silly82/Herz_Schwarm_CCC_V/README.md

# ❤️ CCC Heart Swarm Badge (Herz-Schwarm)

Synchronized ESP-NOW Heart Badges for the CCC Camp & Congress.
*Synchronisierte ESP-NOW Herz-Badges für das CCC Camp & den Congress.*

---

## Deutsch

### Was ist das?
Ein Schwarm von 8x8 LED Herz-Badges auf Basis der **Waveshare ESP32-S3-Matrix**. Die Badges kommunizieren über **ESP-NOW**, synchronisieren ihren Takt, reagieren auf die Nähe anderer Geräte (RSSI) und enthalten interaktive Easter Eggs.

### Funktionen
- **Herzschlag-Sync:** Alle Badges schlagen im exakt gleichen Rhythmus.
- **Näherungseffekt:** Je näher dir ein anderes Badge kommt, desto heller leuchtet dein Herz. Ab Badge-FW 1.6.0 zählt dafür das **nächste** Badge (stärkstes Signal), nicht mehr der Durchschnitt über alle; das Tempo hängt nicht mehr an der Nähe, damit alle im gleichen Takt bleiben. Ferngesteuerte Effekte leuchten auf allen Badges gleich hell (feste Helligkeit, `FX_BRIGHT`).
- **Primzahlen-Osterei:** Wenn die **Gesamtzahl im Schwarm** eine Primzahl ist — also **sichtbare andere Badges plus dein eigenes** (z. B. du + 12 andere = 13; nur unter 17, ab dort greift die Singularität) — pulsiert das Herz stärker und es gibt weisse Glitzer-Pixel.
- **Die Singularität (≥17 Geräte):** Sobald **mindestens 17 Geräte insgesamt** da sind (du + 16 sichtbare Peers), schaltet die Animation auf den **Regenbogen-Modus** um (nicht nur bei exakt 17).
- **Der Morse-Virus:** Morsese ein **«C»** (`- . - .`) über die BOOT-Taste, um einen weissen Blitz-Virus durch den gesamten Schwarm zu jagen. Ab Badge-FW 1.6.0 endet der Morse-Virus auf jedem Badge nach **3 s** von selbst (am Badge gibt es keine Stopp-Geste); nur der von Basisstation/App gestartete Virus läuft endlos bis zum Stopp.
- **Die Welle (Basisstation):** Eine Welle breitet sich von der Basisstation aus: Badges in der Nähe leuchten zuerst, weiter entfernte später. Ein Durchlauf dauert ~4 s und wiederholt sich ab Badge-FW 1.4.1 **endlos** (Zyklus alle 4000 ms) — beendet wird die Welle erst per **manuellem Stopp** (Modus `10`, oder `12` für alle Effekte): Toggle im Web-UI, MQTT-Payload `10` oder Nerves-Dashboard; Badges leiten den Stopp begrenzt weiter, so erreicht er auch Geräte außerhalb der Basis-Reichweite. Ältere Badges verstehen den Stopp nicht und laufen wie bisher nach ~4 s aus. Ab Badge-FW 1.4.0: Wer die Basis direkt hört, zündet nach deren Signal (−45 dBm → sofort, −95 dBm → 2 s); alle anderen nach dem Badge, von dem sie die Welle haben, plus 150–750 ms je nach Signal zu ihm. Jedes Badge rechnet dabei auf den gemeinsamen Wellenstart zurück und übernimmt den kürzesten bekannten Weg — die Welle läuft so auch zu Badges, die die Basis gar nicht hören.
- **Fernauslösung (Basisstation):** Kompatibles `SyncPacket` mit `mode` **1** (Virus), **2** (Regenbogen / Singularity-Optik), **3** (Primzahl-Party), **4** (Welle / RSSI-Ripple, 4-s-Zyklus), **5** (Beat-Puls ~150 ms), **6** (RSSI-Zonen-Farben), **7** (Ambient-Farbe), **8** (Strobe), **9** (Badge finden — nur das Badge mit der Ziel-MAC blinkt grün), **10** (Welle stoppen — beendet die laufende Welle, ab Badge-FW 1.4.1), **11** (Tap-Meldung — `virusID` = Tap-Zählerstand), **12** (Alle stoppen — global, `virusID` = Kennung des Stopps), **13** (Funk-Update auslösen — nur App + Bridge, ab Badge-FW 1.7.0). Ab Badge-FW **1.5.0** laufen alle visuellen Effekte **endlos**, bis man sie stoppt oder ein neu gestarteter visueller Effekt sie ersetzt („letzter Effekt gewinnt" — Beat und Identify bleiben dabei erhalten). Die früheren festen Fenster (Virus 3 s, Regenbogen 15 s, Primzahl 12 s, Zonen 5 s, Ambient 30 s, Strobe 2 s) sind nur noch **nominale Zykluslängen**, nach denen der Effekt sich wiederholt. Ausnahmen: **Beat** bleibt ein 150-ms-Puls pro Paket, **Identify** (Modus 9) bleibt 10 s. Neue `virusID` pro Effekt verhindert Doppel-Trigger; während eines Effekts wird der passende `mode` weitergesendet (Kettenreaktion im Schwarm).
- **Tap-Counter (BOOT-Taste, ab Badge-FW 1.5.0):** Kurze Drücke auf die BOOT-Taste (**≤ 250 ms** — dieselben Ereignisse, die in der Morse-Eingabe ein Punkt sind; Morse unverändert) werden gezählt und als Modus `11` gemeldet (`virusID` = Zählerstand, monoton; 3× im 60-ms-Abstand plus Nachsendung nach 1,2 s, einmal beim Start). Andere Badges leiten fremde Tap-Pakete begrenzt weiter (**23 Byte** mit angehängter Ursprungs-MAC) und merken sich je MAC den höchsten Stand (Dedup). Der Zählerstand wird gedrosselt in NVS gespeichert (Namespace `hstap`, max. 1 Schreibvorgang/30 s). In der Nerves-App endet die Kette als **Tap-Counter-Karte** (Gesamtsumme und je Badge, Reset mit Rückfrage — Reset setzt nur die Anzeige auf 0, die Badge-Zähler laufen weiter).
- **Alle stoppen (Modus `12`, ab Badge-FW 1.5.0):** Globaler Stopp. Ab Badge-FW 1.6.0 / Basisstation 0.4.2 / Bridge 0.4.2 / App 0.2.2 trägt jeder Stopp eine eigene Kennung im `virusID`-Feld und wirkt je Badge genau einmal — ein verspätetes Echo schaltet so keinen Effekt mehr ab, der nach dem Stopp gestartet wurde (`virusID = 0` von älteren Sendern wird weiter verstanden, dann ohne diesen Schutz). Badges deaktivieren alle Effekt-Slots außer Identify und leiten den Stopp begrenzt weiter (max. 3 Sendungen, ~60 ms Abstand, dann 1000 ms Sperre — gleiches Muster wie der Wellen-Stopp). Erreichbar über Dashboard-Knopf „Alle Effekte auf den Badges stoppen", Basisstation-Knopf „⏹ Alle stoppen", `POST /api/effect?m=12` oder MQTT-Payload `12`.
- **Bewegungssensor (ab Badge-FW 1.8.0):** Schütteln lässt das Herz 1,5 s mit weißen Funken flattern. Optional: „Herz immer aufrecht" und Abdunkeln in Ruhe (beides standardmäßig aus). Am Gerät noch nicht getestet — siehe *Bewegungssensor*.
- **Funk-Update (ab Badge-FW 1.7.0):** Badges laden eine neue Firmware selbst per WLAN, ausgelöst über den Schwarm-Funk von der App-Seite `/badge-update` (Modus `13`, mit Schlüssel abgesichert). Nur in Builds mit `ota_secret.h`; am Gerät noch nicht getestet — siehe *Funk-Update der Badges*.
- **Nerves-Controller (Raspberry Pi):** Optionale Elixir/Nerves-App (`herz_schwarm_nerves/`) steuert den Schwarm über einen USB-ESP32-Bridge (ESP-NOW). LiveView Web-UI für Effekt-Steuerung, Beat-Tap-Tempo, Ambient-Farbwahl. Koexistiert mit der Basisstation auf Kanal 13. **Dev-Start auf Mac** (ohne Nerves-Build): siehe `herz_schwarm_nerves/MAC_SETUP.md`. Ab App 0.2.0 / Bridge 0.3.0 steuert die Seite **`/bridge-update`** die Bridge-Firmware per **UART-OTA** über das bestehende USB-Kabel (kein WLAN, kein `esptool`) — die Bridge braucht dafür einmalig einen USB-Flash mit dem neuen Partition-Schema `min_spiffs`; Details in Punkt 12 der nummerierten Doku. Ab App 0.2.0 / Bridge 0.4.0 zusätzlich im Dashboard: **Tap-Counter-Karte** (Modus `11`) und Knopf „Alle Effekte auf den Badges stoppen" (Modus `12`); BPM-Slider und Farbwähler wurden in Formulare gesetzt (vorher kamen Tempo- und Farbänderungen nie an) und das Verschieben des Tempo-Sliders startet den Beat nicht mehr. Ab App 0.3.0 / Bridge 0.5.0 löst die Seite **`/badge-update`** das Funk-Update der Badges aus. Betrieb auch direkt auf **Raspberry Pi OS** (systemd-Dienst, ohne Nerves-Firmware) — siehe *Betrieb auf dem Raspberry Pi*.

### Spezifische Hardware-Hinweise (Waveshare ESP32-S3-Matrix)
- **Pinout:** Die interne Matrix ist fest an **GPIO 14** verdrahtet. Die BOOT-Taste liegt auf **GPIO 0**.
- **Farben:** Die Matrix der Waveshare-Boards ist **RGB** verdrahtet (am Gerät verifiziert — mit `BGR` waren Rot und Blau vertauscht). Die Firmware initialisiert entsprechend `FastLED.addLeds<WS2812B, LED_PIN, RGB>`.
- **Sicherheit:** Da die Rückseite des Boards offene Kontakte hat, wird dringend empfohlen, diese mit Klebeband (Kapton) zu isolieren oder ein Gehäuse zu verwenden.
- **Eigene Hardware:** `herz_badge/` enthält das KiCad-Projekt für ein akkubetriebenes Badge (Waveshare-Schaltplan nachgezeichnet, Akku-Version platziert, noch nicht geroutet). Siehe `herz_badge/README.md`.

---

## 🇬🇧 English

### What is this?
A swarm of 8x8 LED heart badges based on the **Waveshare ESP32-S3-Matrix**. They communicate via **ESP-NOW**, sync their pulse, react to proximity (RSSI), and feature interactive Easter Eggs.

### Features
- **Heartbeat Sync:** All badges beat at the exact same rhythm.
- **Proximity Awareness:** The closer another badge gets, the brighter your heart glows. From badge FW 1.6.0 this follows the **nearest** badge (strongest signal) instead of the average over all peers; tempo no longer depends on proximity, so everyone stays on the same beat. Remote-triggered effects use a fixed brightness (`FX_BRIGHT`) and look the same on every badge.
- **Prime Number Easter Egg:** When the **total swarm size** is prime — **other visible badges plus your own** (e.g. you + 12 others = 13; only below 17, where the singularity takes over) — the heart pulses more strongly with occasional white sparkles.
- **The Singularity (≥17 devices):** When **at least 17 devices** are present in total (you + 16 visible peers), the animation switches to **rainbow mode** (not only at exactly 17).
- **The Morse Virus:** Morse a **"C"** (`- . - .`) using the BOOT button to trigger a white flash "virus" across the entire swarm. From badge FW 1.6.0 the Morse virus ends after **3 s** on every badge (there is no stop gesture on the badge); only a virus started from the base station or the app runs until stopped.
- **The Wave (base station):** A wave ripples outward from the base station: nearby badges light up first, distant ones later. One pass takes ~4 s; from badge FW 1.4.1 the wave **repeats endlessly** (4000 ms cycle) and only ends on a **manual stop** (mode `10`, or `12` to stop all effects): toggle in the web-UI, MQTT payload `10`, or Nerves dashboard — badges relay the stop with limited rebroadcasts, so it also reaches devices outside the base's range. Older badges don't understand the stop and finish after ~4 s as before. From badge FW 1.4.0, badges that hear the base fire by its signal strength (−45 dBm → immediately, −95 dBm → 2 s); others fire after the badge they got the wave from, plus 150–750 ms by signal to it. Every badge aligns to the shared wave start and keeps the shortest known path, so the wave also reaches badges out of the base's range.
- **Remote trigger (base station):** Compatible `SyncPacket` with `mode` **1** (virus), **2** (rainbow / singularity look), **3** (prime-party look), **4** (wave / RSSI ripple, 4 s cycle), **5** (beat pulse ~150 ms), **6** (RSSI zone colors), **7** (ambient color), **8** (strobe), **9** (find badge — only the badge with the target MAC blinks green), **10** (stop the wave — ends the running wave, badge FW 1.4.1+), **11** (tap report — `virusID` = tap counter), **12** (stop all — global, `virusID` = id of this stop), **13** (trigger over-the-air update — app + bridge only, badge FW 1.7.0+). From badge FW **1.5.0** all visual effects run **endlessly** until stopped or until a newly started visual effect replaces them ("last effect wins" — beat and identify are kept). The previous fixed windows (virus 3 s, rainbow 15 s, prime 12 s, zones 5 s, ambient 30 s, strobe 2 s) are now only **nominal cycle lengths** after which the effect repeats. Exceptions: **beat** remains a 150 ms pulse per packet, **identify** (mode 9) stays at 10 s. A fresh `virusID` per effect avoids re-triggering; while active, badges forward the same `mode` for swarm propagation.
- **Tap counter (BOOT button, badge FW 1.5.0+):** Short BOOT presses (**≤ 250 ms** — the same events that count as a dot in morse input; morse itself is unchanged) are counted and reported as mode `11` (`virusID` = counter, monotonic; sent 3× at 60 ms spacing plus a re-send after 1.2 s, and once at boot). Other badges relay foreign tap packets with limited rebroadcast (**23 bytes** with the origin MAC appended) and keep the highest value per MAC (dedup). The counter is persisted to NVS with throttling (namespace `hstap`, max. 1 write/30 s). In the Nerves app the chain ends on a **Tap-Counter card** (total and per badge, reset with confirmation — reset only zeroes the display, badge counters keep running).
- **Stop all (mode `12`, badge FW 1.5.0+):** Global stop. From badge FW 1.6.0 / base station 0.4.2 / bridge 0.4.2 / app 0.2.2 every stop carries its own id in `virusID` and takes effect exactly once per badge, so a late echo can no longer switch off an effect started after the stop (`virusID = 0` from older senders is still understood, without that protection). Badges deactivate all effect slots except identify and relay the stop with limited rebroadcast (max. 3 sends, ~60 ms apart, then a 1000 ms lock — same pattern as the wave stop). Reachable via the dashboard button "Alle Effekte auf den Badges stoppen", the base station button "⏹ Alle stoppen", `POST /api/effect?m=12`, or MQTT payload `12`.
- **Motion sensor (badge FW 1.8.0+):** Shaking the badge makes the heart flutter with white sparks for 1.5 s. Optional: "heart always upright" and dimming at rest (both off by default). Not yet tested on hardware — see *Bewegungssensor* (German).
- **Over-the-air update (badge FW 1.7.0+):** Badges download new firmware over Wi-Fi themselves, triggered through the swarm radio from the app page `/badge-update` (mode `13`, protected by a shared key). Only in builds with `ota_secret.h`; not yet tested on hardware — see *Funk-Update der Badges* (German).
- **Nerves Controller (Raspberry Pi):** Optional Elixir/Nerves app (`herz_schwarm_nerves/`) controls the swarm via a USB ESP32 bridge (ESP-NOW). LiveView web-UI for effect control, beat tap-tempo, ambient color picker. Coexists with the base station on channel 13. From app 0.2.0 / bridge 0.3.0 the **`/bridge-update`** page pushes new bridge firmware via **UART-OTA** over the existing USB cable (no Wi-Fi, no `esptool`) — existing bridge devices first need one USB flash with the new `min_spiffs` partition scheme. **Security note:** the `/bridge-update` page has **no login** — anyone who can reach the app on the network can upload and flash bridge firmware. Run the app only in a trusted network or restrict access at the network level (firewall/VPN/LAN segment); there is deliberately no login yet, unlike the base station's OTA, which uses HTTP Basic Auth. From app 0.2.0 / bridge 0.4.0 the dashboard also shows a **Tap-Counter card** (mode `11`) and an "Alle Effekte auf den Badges stoppen" button (mode `12`); the BPM slider and color picker now sit inside forms (`phx-change` does not fire on standalone inputs outside a form, so tempo and color changes never arrived), and moving the tempo slider no longer starts the beat (start only via "Start"). From app 0.3.0 / bridge 0.5.0 the **`/badge-update`** page triggers the over-the-air update of the badges (also without login; a trigger additionally needs the shared key `BADGE_OTA_KEY` on the server). The app also serves the diagnosis page **`/diagnose`** (monitoring: counters, bridge state, log panel, badge metrics). The app currently runs on plain **Raspberry Pi OS (Debian 13, aarch64)** as systemd service `herz-schwarm` on port 4000 — no Nerves firmware; see `herz_schwarm_nerves/MAC_SETUP.md`.

### Specific Hardware Notes (Waveshare ESP32-S3-Matrix)
- **Pinout:** Internal matrix is wired to **GPIO 14**. BOOT button is on **GPIO 0**.
- **Color Order:** The matrix is wired **RGB** (verified on device — with `BGR`, red and blue were swapped). The firmware initializes `FastLED.addLeds<WS2812B, LED_PIN, RGB>`.
- **Safety:** As the back of the board has exposed contacts, it is highly recommended to insulate it with tape (Kapton) or use a 3D-printed case.
- **Own hardware:** `herz_badge/` holds the KiCad project for a battery-powered badge (the Waveshare schematic redrawn, the battery version placed, not yet routed). See `herz_badge/README.md`.

### Build, flash & serial monitor (Arduino CLI)
- **FQBN:** `esp32:esp32:esp32s3` — sketch folder = repository root (`Herz_Schwarm_CCC_V.ino`). Port: `arduino-cli board list`.
- **Production build:** `compile` + `upload` without debug flags (smaller binary, no serial overhead in the loop).
- **Serial debug on USB (ESP32-S3):** enable **USB CDC On Boot** (`CDCOnBoot=cdc`) and `ENABLE_SERIAL_DEBUG=1`. Because `upload` has no `--build-property`, use `--build-path build_debug` on compile and `--input-dir build_debug` on upload — see the **Arduino CLI** subsection under *Setup & Configuration* for copy-paste commands.
- **Live log:** `arduino-cli monitor -p <port> -c baudrate=115200` in an **interactive** terminal; stop with `Ctrl+C` before flashing again.
- **Batch flash (several devices):** `scripts/batch_flash_herz_schwarm.sh` needs **esptool** on `PATH` in addition to arduino-cli. See *Batch-Update* under *Setup & Configuration* (German) for options and the log files `firmware_update_log.csv` / `firmware_update_log.md`.
- **Interactive TUI (currently v0.2.1):** running the same script in a terminal with `pyserial` installed auto-launches an ANSI menu (`scripts/flash_gui.py`) for port scanning, build mode (release/debug), compile, flash + MAC-read (parsed from upload output, no separate `esptool read_mac`), and log view. TUI covers **flash operations only** — effect control (modes 1–8, plus wave stop `10` and stop-all `12`) stays on the base station via Web-UI (port 80) or MQTT. macOS, Linux and (from v0.2.0) Windows; v0.2.0 also adds parallel flashing, retry of failed ports and automatic rebuild of a stale build.
- **Morse logging:** with debug on, each symbol prints as `[Morse]`; after 800 ms without a new symbol the word is evaluated (`-.-.` triggers the virus, otherwise `ignoriert`). With debug off, none of this is compiled into `loop()`.
- **Firmware version:** see *Firmware-Version* (German section under *Setup & Configuration*): `FW_*` in `Herz_Schwarm_CCC_V.ino`; release `MAJOR.MINOR.PATCH`, debug `MAJOR.MINOR.DD+debug` with `DD` 01–99.
- **ESP-NOW:** firmware version is sent in each sync packet (17-byte `SyncPacket`); legacy 13-byte peers still work — see *ESP-NOW Paket (Sync)* in the German section.
- **Windows:** building and uploading with Arduino CLI works the same (ports are `COMx`); the TUI (`python scripts\flash_gui.py`) supports Windows from v0.2.0, the Bash batch script is macOS/Linux only — see *Windows* below.
- **Checks:** there is no CI; compile the firmwares and run `pytest` / `mix test` locally before pushing — see *Prüfen vor dem Push* below.

---

## 🛠 Setup & Configuration
- **MCU:** Waveshare ESP32-S3-Matrix
- **Arduino IDE Board:** "ESP32S3 Dev Module"
- **USB Mode:** "Hardware CDC and JTAG"
- **USB CDC On Boot:** *Enabled* if you want `Serial` output on the USB cable while debugging (matches `CDCOnBoot=cdc` in CLI).
- **Library:** FastLED (v3.6+); WiFi, ESP-NOW, Wire, Update und HTTPClient kommen mit dem ESP32-Core. Basisstation zusätzlich PubSubClient, Bridge zusätzlich ArduinoJson 7.
- **Geprüfter Stand:** ESP32-Core 3.3.12, FastLED 3.10.9, PubSubClient 2.8.0, ArduinoJson 7.4.3.

### Arduino CLI
Build und Upload lassen sich mit der **Arduino CLI** erledigen. **FQBN:** `esp32:esp32:esp32s3`. **Sketch-Verzeichnis:** Wurzel dieses Repos (Datei `Herz_Schwarm_CCC_V.ino`). Im Ordner `.cursor/rules/` liegt eine **Cursor-Regel** (`arduino-cli.mdc`) mit typischen Befehlen.

**Port ermitteln:**

```bash
arduino-cli board list
```

**Standard-Build & Upload** (ohne Serial-Debug, weniger Flash/RAM):

```bash
arduino-cli compile --fqbn esp32:esp32:esp32s3 .
arduino-cli upload -p /dev/cu.usbmodemXXXX --fqbn esp32:esp32:esp32s3 .
```

(`usbmodemXXXX` durch den eigenen Eintrag aus `board list` ersetzen.)

**Serial-Debug & Live-Log am USB-Kabel (ESP32-S3):**  
Am Rechner erscheint `Serial` nur zuverlässig über USB, wenn **USB CDC On Boot** aktiv ist. Zusätzlich muss `ENABLE_SERIAL_DEBUG` an sein (siehe unten). `arduino-cli upload` unterstützt **kein** `--build-property`; deshalb zuerst in einen Build-Ordner kompilieren und mit `--input-dir` flashen:

```bash
arduino-cli compile --fqbn esp32:esp32:esp32s3 --board-options CDCOnBoot=cdc \
  --build-property "compiler.cpp.extra_flags=-DENABLE_SERIAL_DEBUG=1" \
  --build-path build_debug .
arduino-cli upload -p /dev/cu.usbmodemXXXX --fqbn esp32:esp32:esp32s3 \
  --board-options CDCOnBoot=cdc --input-dir build_debug .
```

Der Zwischenordner `build_debug/` steht in `.gitignore` und wird nicht ins Repo committet.

**Seriellen Monitor (live):** In einem **normalen Terminal** starten (Hintergrund/CI beendet den Monitor oft sofort). **Baudrate:** 115200.

```bash
arduino-cli monitor -p /dev/cu.usbmodemXXXX -c baudrate=115200
```

Beenden mit `Ctrl+C`. Vor einem erneuten Upload den Monitor beenden (Port freigeben).

### Windows

Kompilieren und Hochladen mit der Arduino CLI funktionieren unter Windows mit denselben Befehlen (kompiliert geprüft mit Arduino CLI 1.6.0; geflasht wurde von Windows aus bisher nicht). Unterschiede:

- Der Port heißt `COMx` statt `/dev/cu.…` (`arduino-cli board list`).
- In PowerShell mehrzeilige Befehle in eine Zeile schreiben oder mit dem Backtick statt `\` umbrechen.
- Die TUI läuft ab v0.2.0 auch unter Windows: `python scripts\flash_gui.py` (braucht `pip install pyserial`). `scripts/batch_flash_herz_schwarm.sh` und `scripts/version.sh` sind Bash-Skripte für macOS/Linux; in Git Bash laufen sie, die Port-Erkennung des Bash-Modus kennt `COMx` aber nicht.
- Die App (`herz_schwarm_nerves/`) braucht Elixir; ohne lokale Installation lassen sich ihre Tests nur auf dem Mac oder dem Pi ausführen.

### Prüfen vor dem Push

Das Projekt hat bewusst **keine CI**. Vor einem Push von Hand prüfen:

| Was | Befehl |
|-----|---|
| Firmware | Badge, Basisstation und Bridge mit `arduino-cli compile` bauen (Befehle oben) |
| Flash-Tooling | `python -m pytest scripts` (43 Tests) |
| App | `mix test` in `herz_schwarm_nerves/` (braucht Elixir) |

Funk- und LED-Verhalten bleiben ein Test am Gerät.

### Betrieb auf dem Raspberry Pi
Die Phoenix-App läuft aktuell **ohne Nerves-Firmware** direkt auf **Raspberry Pi OS (Debian 13, aarch64)** als systemd-Dienst `herz-schwarm` auf Port **4000** — kein Nerves-Build, kein `mix release`. Zusätzlich stellt die App die Diagnose-Seite **`/diagnose`** bereit (Monitoring: Zähler, Bridge-Zustand, Log-Panel, Badge-Metriken). Setup-Details (Autostart, Log, Updates) stehen in `herz_schwarm_nerves/MAC_SETUP.md`; hier bewusst nur der Verweis, keine doppelte Anleitung.

### Batch-Update (mehrere Badges nacheinander)

Für viele Waveshare-Matrix-Badges am USB (nacheinander flashen oder **mehrere USB-Ports gleichzeitig**): Skript `scripts/batch_flash_herz_schwarm.sh` im Repo. Es baut **einmal** in den lokalen Ordner `build_batch/` (in `.gitignore`, analog zu `build_debug/`) und führt pro erkanntem Port `arduino-cli upload` aus, danach **`esptool read_mac`**, und **hängt** einen Eintrag an die Protokolldateien in der **Repo-Wurzel** an:

- **`firmware_update_log.csv`** — Semikolon-getrennt: Zeitstempel, Firmware-String, Port, Ergebnis, MAC
- **`firmware_update_log.md`** — dieselben Daten als Markdown-Tabelle

**Voraussetzung:** [Arduino CLI](https://arduino.github.io/arduino-cli/) (wie oben) **und** [esptool](https://github.com/espressif/esptool) (`esptool.py` oder `esptool` im `PATH`, z. B. `brew install esptool`). Liest esptool den Chip nicht, **`ESPTOOL=/pfad/zu/esptool.py`** setzen.

**Port-Erkennung:** `arduino-cli board list --format json` — es werden Anschlüsse genutzt, deren **Board-Erkennung** `esp32:esp32:esp32s3` *oder* (häufig auf macOS) **`esp32:esp32:esp32_family`** liefert. Wenn kein passender Port erscheint, Ports manuell oder per USB-Heuristik:

```bash
chmod +x scripts/batch_flash_herz_schwarm.sh
./scripts/batch_flash_herz_schwarm.sh
./scripts/batch_flash_herz_schwarm.sh --ports /dev/cu.usbmodem101 /dev/cu.usbmodem102
./scripts/batch_flash_herz_schwarm.sh --all-usb
./scripts/batch_flash_herz_schwarm.sh --no-compile
./scripts/batch_flash_herz_schwarm.sh --debug
```

| Option / Ablauf | Bedeutung |
|---|---|
| (ohne Optionen) | Erkannte ESP32-Ports flashen, einmal kompilieren |
| `--ports …` | Nur diese Gerätepfade (z. B. aus `arduino-cli board list`) |
| `--all-usb` | Typische USB-Seriell-Pfade (`usbmodem*`, WCH, FTDI-ähnlich), wenn die CLI kein FQBN meldet |
| `--no-compile` | Nur `upload` aus bestehendem `build_batch/` (nach vorherigem Lauf) |
| `--debug` | Entspricht **Serial-Debug**-Build: `CDCOnBoot=cdc` und `-DENABLE_SERIAL_DEBUG=1` (siehe oben) |

Vor dem Lauf: **seriellen Monitor beenden** (`Ctrl+C`), sonst ist der Port belegt. Pro Gerät: zuerst Flash, danach MAC auslesen; Ergebnis `ok` / `upload_failed` / `ok_mac_unread` u. a. steht in der CSV/MD. Ausdrücklich mit **`bash ./scripts/...`** starten, falls die System-Shell zickt.

### CLI Pseudo-GUI (interaktiv, aktuell v0.2.1)

`scripts/batch_flash_herz_schwarm.sh` startet **automatisch** eine interaktive TUI, wenn ein TTY erkannt wird und `pyserial` installiert ist. Die TUI (`scripts/flash_gui.py`) ist ein dünner Wrapper um die gleiche Logik — nutzt aber ANSI-Boxen für Menü, Live-Output und Multi-Select.

**Voraussetzung** (einmalig):
```bash
pip3 install --user pyserial
```

**Start:**
```bash
./scripts/batch_flash_herz_schwarm.sh       # TUI automatisch
./scripts/batch_flash_herz_schwarm.sh --no-gui   # Bash-Modus erzwingen
./scripts/batch_flash_herz_schwarm.sh --gui      # TUI erzwingen (Fehler wenn nicht möglich)
python3 scripts/flash_gui.py               # TUI direkt starten
python3 scripts/flash_gui.py --debug       # gleich im Debug-Modus starten
python scripts\flash_gui.py                # Windows (PowerShell)
```

Über dem Menü steht eine Statuszeile: Firmware-Version, Build-Modus, ob der vorhandene Build noch zum Sketch passt, die ausgewählten Ports und zuletzt fehlgeschlagene Ports.

**Hauptmenü:**
| Taste | Funktion |
|---|---|
| `1` | ESP32-S3-Ports scannen und auswählen (Enter = alle, sonst `1,3` oder `2-4`) |
| `2` | Build-Modus: Release ↔ Debug umschalten |
| `3` | Firmware kompilieren (Live-Ausgabe von arduino-cli) |
| `4` | Flashen, MAC aus der Upload-Ausgabe; am Ende eine Ergebnisübersicht mit Dauer |
| `5` | Log anzeigen (letzte 20 Zeilen aus `firmware_update_log.md`) |
| `6` | Gleichzeitig flashen an/aus (Standard aus: ein Board nach dem anderen mit Live-Ausgabe) |
| `r` | Fehlgeschlagene Ports erneut flashen (erscheint nur nach einem Fehler) |
| `q` | Beenden |

Vor dem Flashen baut die TUI von selbst neu, wenn kein Build da ist, der Build-Modus gewechselt wurde oder `Herz_Schwarm_CCC_V.ino` bzw. `ota_secret.h` neuer sind als der Build. Ein Upload, der länger als 3 Minuten hängt, wird abgebrochen.

**Geltungsbereich:** TUI ist **nur** für **Flash-Operationen** zuständig (Compile, Upload, MAC-Read, Log). Effekt-Steuerung (Modes 1–8 + Wellen-Stopp `10` + Alle stoppen `12`, Virus/Regenbogen/Beat/Ambient/…) läuft weiterhin über die **Basisstation**: per **Web-UI** (Port 80) oder per **MQTT** (Broker konfiguriert in NVS). Der TUI-Flasher hat keinen ESP-NOW-Adapter und ist deshalb kein Effekt-Tool.

**Plattformen:** macOS (primär, mit Badges getestet), Linux (gleicher Code). Windows ab v0.2.0: Ports heißen `COMx` und werden über arduino-cli bzw. pyserial gefunden; Menü, Port-Suche und Kompilieren sind unter Windows 11 geprüft, das Flashen selbst dort noch nicht.

**Logs:** werden in die **gleichen Dateien** angehängt wie der Bash-Modus (`firmware_update_log.csv` / `firmware_update_log.md`) — keine Duplikation, vollständige Audit-Trail über alle Läufe und Tools.

**Änderungen v0.2.0** (mit Tests geprüft, mit echten Badges noch nicht geflasht):
- **Windows-Unterstützung** — `COMx`-Ports, Farben im Windows-Terminal, UTF-8-Ausgabe; arduino-cli wird auch unter `C:\Program Files\Arduino CLI` gefunden (oder über die Umgebungsvariable `ARDUINO_CLI`)
- **Falsche Debug-Version behoben** — `#define`-Zeilen mit Kommentar dahinter wurden übersehen und als 0 gelesen; im Log stand deshalb z. B. `1.8.00+debug` statt `1.8.01+debug`
- **Veralteter Build wird erkannt** — vorher wurde nach einem Wechsel Release ↔ Debug oder nach einer Sketch-Änderung die alte Binärdatei geflasht, solange irgendeine da war
- **Upload-Ausgabe läuft live mit** statt erst nach dem Ende des Uploads zu erscheinen
- **Gleichzeitig flashen** (Taste `6`) für mehrere Boards an einem Hub; **erneut flashen** nur der fehlgeschlagenen Ports (Taste `r`); Ergebnisübersicht am Ende
- **Rahmen stimmen** — die Breite wird ohne Farbcodes berechnet und passt sich Inhalt und Terminal an
- **Log** immer UTF-8 mit Zeitzone im Zeitstempel (vorher fehlte sie in der TUI)
- **41 Unit-Tests** in `flashlib/`

**Änderungen v0.2.1:** Im Kopf der TUI erscheint das Badge-Herz als Blockgrafik (ab 72 Spalten Fensterbreite; in schmaleren Fenstern entfällt es). 43 Unit-Tests.

**Änderungen v0.1.0 → v0.1.1 (Punkt-Release):**
- **MAC aus Upload-Output geparst** statt separates `esptool read_mac` — kein Bootloader-Reset-Race mehr, ~3s pro Board gespart
- **arduino-cli Path-Fallback** — funktioniert auch wenn das Binary nicht im PATH ist (z. B. nur in `/Applications/Arduino IDE.app/...`)
- **argv-Bug behoben** — `arduino-cli` wurde doppelt als Binary + Sub-Command übergeben (`unknown command "arduino-cli"`)
- **Auto-Build vor Flash** — wenn `build_batch_gui/*.bin` fehlt, wird automatisch kompiliert
- **23/23 Unit-Tests** in `flashlib/` grün

**Verifiziert mit 3 ESP32-S3-Badges** (18:58 Uhr, Firmware 1.1.0):
| Port | MAC |
|---|-----|
| `/dev/cu.usbmodem101`  | `34:b7:da:53:6b:98` |
| `/dev/cu.usbmodem1101` | `3c:0f:02:e4:61:00` |
| `/dev/cu.usbmodem1101` | `a0:f2:62:ec:3c:c8` |

### Funk-Update der Badges (OTA über WLAN, ab Badge 1.7.0 / Bridge 0.5.0 / App 0.3.0)

Badges holen sich eine neue Firmware selbst per WLAN, ausgelöst über den Schwarm-Funk — kein USB-Kabel pro Badge. **Stand: kompiliert und in der CI geprüft, am Gerät noch nicht getestet** (siehe `todo.md`).

**Einmalig einrichten:**

1. `ota_secret.h.example` als `ota_secret.h` neben `Herz_Schwarm_CCC_V.ino` kopieren und alle drei Werte setzen: `OTA_WIFI_SSID`, `OTA_WIFI_PASS` (ein 2,4-GHz-WLAN, in dem der Rechner mit der App erreichbar ist) und `OTA_KEY` (langer zufälliger Text). Die Datei steht in `.gitignore`.
2. Alle Badges **einmal per USB** mit dieser Firmware flashen. Ohne `ota_secret.h` wird der OTA-Code gar nicht mitkompiliert — im öffentlichen Repo gibt es bewusst keinen Standard-Schlüssel.
3. Bridge auf 0.5.0 bringen (über `/bridge-update`).
4. Die App mit der Umgebungsvariable `BADGE_OTA_KEY` starten — exakt derselbe Text wie `OTA_KEY`.

**Update ausführen:**

1. Firmware mit erhöhter Version und derselben `ota_secret.h` bauen: `arduino-cli compile --fqbn esp32:esp32:esp32s3 --build-path build_ota .` → `build_ota/Herz_Schwarm_CCC_V.ino.bin`. Diese Datei enthält WLAN-Passwort und Schlüssel im Klartext — nicht weitergeben; `build_ota/` steht in `.gitignore`.
2. In der App die Seite **`/badge-update`** öffnen, die `.bin` ablegen. Die App liest Version (Marker `HERZFW:x.y.z;` im Binary), Größe und MD5.
3. Adresse des App-Rechners im Badge-WLAN und Port (Standard 4000) prüfen, **„Update an alle Badges senden"**.

**Was die Badges tun:** Jedes Badge prüft den Auslöser (Modus `13`, HMAC-SHA256 mit `OTA_KEY`), leitet ihn begrenzt weiter (3×) und aktualisiert sich nur, wenn die Zielversion **neuer** ist als die eigene. Nach einer zufälligen Wartezeit (0,5–6,5 s, damit nicht alle gleichzeitig laden) verlässt es den Schwarm-Funk, meldet sich am WLAN an, lädt `http://<Adresse>:<Port>/firmware/badge.bin`, prüft Größe und MD5 und startet neu. Anzeige: **blau blinkend** = sucht WLAN, **blau füllend** = lädt, **grün** = fertig, **rot** = fehlgeschlagen. Auch nach einem Fehler startet das Badge neu und läuft mit der alten Firmware weiter; denselben Auslöser versucht es nicht noch einmal, erst einen neuen.

**Grenzen:** Eine Firmware, die ohne `ota_secret.h` gebaut wurde, lässt sich per Funk einspielen, kann danach aber selbst kein Funk-Update mehr (dann wieder USB). Gleiche oder ältere Versionen werden abgelehnt — zum Testen die Version erhöhen. Die Basisstation kann das Update nicht auslösen, nur App + Bridge. Wer einen echten Auslöser mitschneidet, kann ihn erneut senden: Badges mit älterer Version versuchen dann das Update, scheitern ohne erreichbaren Server und sind dafür etwa 25 s aus dem Schwarm — eine fremde Firmware lässt sich so nicht einspielen (MD5 im signierten Auslöser).

### Bewegungssensor (ab Badge 1.8.0)

Die Waveshare ESP32-S3-Matrix hat einen Beschleunigungssensor (QMI8658, I²C: SDA GPIO 11, SCL GPIO 12, Adresse `0x6B`). Die Firmware liest ihn 25-mal pro Sekunde. **Stand: kompiliert, am Gerät noch nicht getestet.** Antwortet beim Start kein passender Sensor oder meldet er in Ruhe nicht etwa 1 g, bleibt alles aus und das Badge läuft wie bisher. Ganz abschalten: `-DENABLE_IMU=0`.

| Funktion | Standard | Schalter |
|---|---|---|
| **Schütteln → Herzflattern:** 1,5 s weiße Funken über dem normalen Herz, nur am eigenen Badge und nur ohne ferngesteuerten Effekt | an | Schwelle `IMU_SHAKE_G` (1,2 g), `IMU_SHAKE_HITS`, `IMU_FLUTTER_MS` |
| **Herz immer aufrecht:** dreht das Herz in 90°-Schritten nach der Schwerkraft | **aus** | `IMU_AUTO_ROTATE=1`, dazu `IMU_ROTATION_OFFSET` (0–3) und `IMU_MIRROR` (0/1) |
| **Abdunkeln in Ruhe:** nach der eingestellten Zeit ohne Bewegung leuchtet das normale Herz nur mit `BRIGHT_MIN` | **aus** | `IMU_REST_DIM_MS` (z. B. `300000` für 5 min) |

**„Herz immer aufrecht" einmessen** (einmal für den Board-Typ, weil die Lage des Sensors zur LED-Matrix nicht aus den Unterlagen hervorgeht):

1. Debug-Build mit `-DIMU_AUTO_ROTATE=1 -DENABLE_SERIAL_DEBUG=1` flashen, seriellen Monitor öffnen. Alle 2 s erscheint `[IMU] x=… y=… z=… |a|=… Lage=N Drehung=M`.
2. Badge so halten, wie es getragen wird. Zeigt das Herz nicht aufrecht, `IMU_ROTATION_OFFSET` so wählen, dass `(Lage + Offset) mod 4 = 0` ergibt.
3. Badge um 90° im Uhrzeigersinn drehen. Dreht sich das Herz in die falsche Richtung, `IMU_MIRROR=1` setzen und den Offset mit `(4 − Lage + Offset) mod 4 = 0` neu bestimmen.
4. Beide Werte im Sketch eintragen und `IMU_AUTO_ROTATE` auf `1` stellen.

Liegt das Badge flach (weniger als 0,6 g in der Matrix-Ebene), bleibt die letzte Drehung stehen.

### Serial-Debug & Morse-Logging
- **Aktivierung:** Im Sketch `ENABLE_SERIAL_DEBUG` auf `1` setzen *oder* beim Kompilieren `-DENABLE_SERIAL_DEBUG=1` wie oben.
- **Aus:** Standard im Sketch ist `0` — dann gibt es **keinen** Serial-Code in der Hauptschleife (kein Einfluss auf die Animation).
- **Mit Debug an:** Es erscheinen u. a. alle 2 s eine **Status**-Zeile (Peers, RSSI, Helligkeit, Morse-Puffer) und **sofort** bei jedem erkannten Morse-Zeichen eine Zeile `[Morse]` mit Dauer in ms; nach 800 ms Pause wird das Wort ausgewertet (`VIRUS` bei exakt `-.-.`, sonst `ignoriert`).
- **Morse-Regel im Code:** Taste gedrückt halten **≤ 250 ms** → Punkt `.`, **> 250 ms** → Strich `-`. Nach **800 ms** ohne neues Zeichen wird der Puffer geleert und geprüft.

### Firmware-Version (Schema A.B.C.D)

Im Sketch `Herz_Schwarm_CCC_V.ino` oben bei den `FW_VERSION_*`-Defines. Versionsschema **A.B.C.D**:

| Komponente | Name | Bedeutung | Wann erhöhen? |
|---|---|---|---|
| **A** = `FW_VERSION_MAJOR` | Major | Breaking Change, Architektur-Wechsel | Nur auf speziellen Wunsch (per Diskussion) |
| **B** = `FW_VERSION_MINOR` | Minor | Großes neues Feature (z. B. TUI, neue Effekte, neues Funk-Protokoll) | Nach Diskussion, vor Merge nach `main` |
| **C** = `FW_VERSION_PATCH` | Patch | Kleines Feature / Refactor / Bugfix | Nach Diskussion, max 99, danach B hoch |
| **D** | Build | **Git-Commit-Zähler seit letztem A.B.C-Wechsel** | **Nur in Git-Tags**, nicht im Code (würde sonst Neukompilation bei jedem Commit erfordern). Tag-Format: `v1.2.0.5` = 5 Commits seit `v1.2.0` |

**Anzeige im Badge / Basisstation** (ohne D, da SyncPacket nur 17 Byte hat):

| Build | Anzeige (Beispiel) | Bedeutung |
|---|---|---|
| **Release** (`ENABLE_SERIAL_DEBUG=0`) | `1.2.0` | `FW_VERSION_MAJOR.MINOR.PATCH` |
| **Debug** (`ENABLE_SERIAL_DEBUG=1`) | `1.2.01+debug` | `FW_VERSION_MAJOR.MINOR` + **`FW_DEBUG_BUILD`** zweistellig (`01`…`99`) + Kennzeichnung `+debug` |

**Versions-Helper** (`scripts/version.sh`):
```bash
scripts/version.sh current        # aktuelle A.B.C aus .ino
scripts/version.sh next-tag       # naechster vA.B.C.D-Tag (D = Commits seit vA.B.C.0)
scripts/version.sh since v1.2.0.0 # Anzahl Commits seit Tag
scripts/version.sh tag            # annotierten Tag setzen
```

**Beispiel:** Code-Stand ist `1.2.0`, seit `v1.2.0.0` gab es 5 Commits → Tag `v1.2.0.5`. Nach Merge in `main` und Diskussion über ein neues Feature wird C auf `1` gesetzt → `1.2.1` → nächster Tag wird `v1.2.1.0`. Bump auf `1.3.0` (großes Feature) → C wieder auf `0` → `v1.3.0.0`. Bump auf `2.0.0` (Breaking Change) → kompletter Reset.

**Aktueller Stand:** `1.8.0` — letzter Git-Tag `v1.4.0.0` (1.4.1 bis 1.8.0 sind noch nicht getaggt). Versionen aller Module: siehe *Versionen aller Module*.

**Versionsverlauf Badge:**

| Version | Änderung |
|---|---|
| 1.8.0 | Bewegungssensor: Schütteln lässt das Herz flattern; „Herz immer aufrecht" und Abdunkeln in Ruhe als Optionen (siehe *Bewegungssensor*). Am Gerät noch nicht getestet. |
| 1.7.0 | Funk-Update über WLAN, Modus `13` (siehe *Funk-Update der Badges*). Am Gerät noch nicht getestet. |
| 1.6.0 | Nähe steuert nur noch die Helligkeit und meint das nächste Badge statt des Durchschnitts; Tempo je Modus fest (normal ~58 BPM, Primzahl ~103, Regenbogen ~123); ferngesteuerte Effekte mit fester Helligkeit; Morse-Virus endet nach 3 s; „Alle stoppen" mit Kennung. Am Gerät noch nicht getestet. |
| 1.5.1 | Echtes 50-Hz-Frame-Raster und 20-Hz-Sync (vorher zählte die Arbeitszeit des Frames nicht mit, effektiv ~44 Hz / ~15 Hz); Basisstation und Bridge zählen nicht mehr als Peer; Regenbogen-Farbton läuft über den Schwarm-Takt und ist zwischen Badges synchron. Am Gerät noch nicht getestet. |
| 1.5.0 | Alle visuellen Effekte laufen endlos bis Stopp bzw. bis ein neuer Effekt sie ersetzt; Tap-Meldung über die BOOT-Taste (Modus `11`); globaler Stopp (Modus `12`); LED-Farbordnung RGB. |
| 1.4.1 | Welle wiederholt sich endlos, Wellen-Stopp (Modus `10`). |
| 1.4.0 | Welle läuft von der Basis nach außen (Signal des Wellen-Pakets, Hop-Verzögerung, gemeinsamer Wellenstart). |
| 1.3.0 | „Badge finden" (Modus `9`); Stationen zählen nicht mehr für den Takt. |
| 1.2.1–1.2.3 | Sync mit 20 Hz statt 50 Hz; gemeinsamer Phasen-Zähler (wirklich synchroner Puls); Races zwischen den Kernen behoben. |
| 1.2.0 | Versionsschema A.B.C.D, Flash-TUI. |

**Änderungen v1.1.0 (Performance-Optimierung, historisch):**
- `String` → `char[12]` für Morse-Puffer (kein Heap-Overhead)
- Peer-Tracking: Hash-Index statt O(n²)-Scan
- `isPrime()` → Lookup-Tabelle (O(1))
- Herz-Maske: 64-bit Bitmaske statt 2D-Array
- Wave-Rebroadcast: nicht-blockierend statt `delay()`
- Frame-Limit: dynamisch statt festes `delay(20)`
- Effekt-State: Array-basiert statt 24 Einzelvariablen
- `smoothRSSI` als `volatile` für ISR-Sicherheit (ab 1.2.3 durch einen gemeinsamen Schutz der geteilten Daten ersetzt, ab 1.6.0 Signal je Peer)

**Pflege:**
- **`FW_VERSION_PATCH`** (und bei Bedarf MINOR/MAJOR) bei **Releases / Merge nach `main`** anheben (SemVer-üblich).
- **`FW_DEBUG_BUILD`** nur auf dem **Debug-Zweig** bei jedem **sichtbaren neuen Debug-Stand** um 1 erhöhen, **höchstens 99**. Bei Überlauf: MINOR anheben und Debug-Zähler wieder bei `01` starten (oder neue Basis-Version festlegen — im Team einheitlich halten).
- Nach größeren Änderungen: Kurzkommentar im Sketch neben den `FW_*`-Zeilen aktualisieren.

### Versionen aller Module

Das A.B.C.D-Schema oben beschreibt **nur die Badge-Firmware** (`Herz_Schwarm_CCC_V.ino`) — sie treibt auch den repo-weiten `vA.B.C.D`-Git-Tag. Die anderen vier Artefakte im Monorepo versionieren sich **unabhängig**, mit je eigenem `MAJOR.MINOR.PATCH`:

| Modul | Datei | Define/Feld | Aktuell |
|---|---|---|---|
| Badge (Schwarm) | `Herz_Schwarm_CCC_V.ino` | `FW_VERSION_MAJOR/MINOR/PATCH` | 1.8.0 |
| Basisstation | `Herz_Schwarm_BaseStation/Herz_Schwarm_BaseStation.ino` | `BASESTATION_FW_MAJOR/MINOR/PATCH` | 0.4.2 |
| Bridge (Nerves-Adapter) | `herz_schwarm_nerves/firmware/esp32_bridge/esp32_bridge.ino` | `BRIDGE_FW_MAJOR/MINOR/PATCH` | 0.5.0 |
| Nerves/Phoenix-App | `herz_schwarm_nerves/mix.exs` | `@version` | 0.3.0 |
| Flash-Tooling (Python) | `scripts/flashlib/__init__.py` | `__version__` | 0.2.1 |

Jedes Modul wird unabhängig gebaut, geflasht bzw. deployed — eine einzige globale Versionsnummer für alles ist bewusst nicht das Ziel. `scripts/version.sh all` zeigt den aktuellen Stand aller fünf; `scripts/version.sh tag` schreibt sie als Snapshot in die Tag-Message des `vA.B.C.D`-Releases (D bleibt reiner Git-Commit-Zähler seit dem letzten `vA.B.C`-Tag, repo-weit — nicht auf Badge-Änderungen beschränkt).

### ESP-NOW Paket (Sync)
Kompaktes `SyncPacket` (packed): `magic_id`, `beatCounter`, `virusID`, `mode` wie bisher, plus **vier Byte** `ver_major`, `ver_minor`, `ver_rel`, `ver_dbg` (gesamt **17 Byte**). **Ältere Firmware** sendet nur **13 Byte** — wird weiter erkannt; die Version des Peers bleibt dann unbekannt (`?` im Debug-Log), bis ein Paket mit voller Länge ankommt. Zusätzliche Kosten: etwas größeres Payload pro Sendezyklus, wenig RAM pro Peer für die gespeicherte Version.

**`beatCounter` = Schwarm-Takt (ab Badge-FW 1.2.2):** gemeinsamer Phasen-Zähler, ein Puls = 65536 Einheiten; die Helligkeit wird ausschließlich daraus berechnet. Empfängt ein Badge einen Wert, der vor seinem eigenen liegt, holt er weich auf (Max-Regel, ab 4 Pulsen Abstand direkter Sprung) — der Schwarm folgt so dem schnellsten Badge und pulsiert synchron. Ausnahme Modus `7`: dort ist `beatCounter` die Farbe. Pakete von Stationen (Basisstation/Bridge, `ver_major == 0`) zählen ab 1.3.0 nicht für den Takt — sie senden ihr `millis()` und ließen den Schwarm sonst bei jedem Effekt in der Phase springen. Bis 1.2.1 lief der Puls über `beatsin8()` mit dem lokalen `millis()` und war deshalb nie wirklich synchron.

**Senderate:** Ab Badge-FW 1.2.1 broadcastet jedes Badge mit **20 Hz** (`SYNC_TX_INTERVAL_MS`, vorher 50 Hz = jeder Frame); bei einem Wechsel von `mode`/`virusID` wird sofort gesendet, damit sich Effekte ohne Verzögerung verbreiten. Das reduziert die Kanal-Last bei vielen Badges um 60 %.

**`mode`-Werte (Badge & Basisstation):** `0` normal; `1` Virus-Animation; `2` Fern-Regenbogen; `3` Fern-Primzahl-Party; `4` Welle (RSSI-/Hop-basierter Ripple, ~4 s pro Durchlauf, ab Badge-FW 1.4.1 **endlos** wiederholt bis Stopp via Modus `10` (oder `12` für alle Effekte); ab Badge-FW 1.4.0 hängen Badges 2× `uint16` an — Phase im laufenden Zyklus (`elapsed % 4000`, 0…3999; vorher „ms seit Wellenstart“, da `uint16` bei endloser Welle nach ~65 s überlaufen würde) und eigene Puls-Verzögerung, 21 Byte; Layout unverändert, abwärtskompatibel; Stationen senden weiter 17 Byte); `5` Beat-Puls (weiss, ~150 ms pro Paket — bleibt ein Einzel-Puls, kein Endlos-Effekt); `6` RSSI-Zonen-Farben (rot/gelb/blau, nominaler Zyklus ~5 s); `7` Ambient-Farbe (RGB aus `beatCounter`, nominaler Zyklus ~30 s); `8` Strobe (weisse Blitze, nominaler Zyklus ~2 s) — `1`–`4`, `6`–`8` laufen ab Badge-FW 1.5.0 **endlos**, bis Stopp (`10`/`12`) oder bis ein neuer visueller Effekt sie ersetzt, die Zeiten sind dann nur noch nominale Zykluslängen; `9` „Badge finden“ (ab Badge-FW 1.3.0: Paket = `SyncPacket` + **6 Byte Ziel-MAC**, 23 Byte; nur das Badge mit dieser STA-MAC blinkt 10 s grün mit voller Helligkeit, ältere Firmware ignoriert es); `10` Welle stoppen (ab Badge-FW 1.4.1 / Basisstation 0.3.1; das Stopp-Paket trägt die Ziel-Wellen-ID im `virusID`-Feld, `0` = Wildcard „stoppe die laufende Welle“; Badges beenden die Welle und leiten den Stopp begrenzt weiter — max. 3 Sendungen, ~60 ms Abstand, danach 1000 ms Sperre — damit er auch Badges außerhalb der Basis-Reichweite erreicht; dieselbe Welle (gleiche `virusID`) zündet danach nicht wieder, ein neuer Wellenstart (neue `virusID`) läuft normal an; ältere Badges ignorieren `10` und laufen wie bisher in ~4 s aus); `11` Tap-Meldung (ab Badge-FW 1.5.0: Badge zählt kurze Drücke auf die BOOT-Taste ≤ 250 ms — dieselben Ereignisse, die in der Morse-Eingabe ein Punkt sind, Morse unverändert — und sendet `mode = 11` mit dem **Zählerstand in `virusID`** (monoton): 3× im Abstand von 60 ms plus Nachsendung nach 1,2 s, beim Start einmal; fremde Tap-Pakete werden begrenzt weitergeleitet — **23 Byte** mit angehängter Ursprungs-MAC —, gemerkt wird je MAC nur der **höchste** Stand (Dedup); Zählerstand wird gedrosselt in NVS gespeichert (Namespace `hstap`, max. 1 Schreibvorgang/30 s)); `12` Alle stoppen (ab Badge-FW 1.5.0: **global**; `virusID` = Kennung des Stopps, ab 1.6.0 wirkt jede Kennung je Badge genau einmal, `0` = alter Sender ohne Kennung; Badges deaktivieren alle Effekt-Slots außer Identify und leiten den Stopp begrenzt weiter — max. 3 Sendungen, ~60 ms Abstand, danach 1000 ms Sperre, gleiches Muster wie der Wellen-Stopp). `13` Funk-Update auslösen (ab Badge-FW 1.7.0, nur in Builds mit `ota_secret.h`; **54 Byte**: `SyncPacket` + Zielversion (3) + IPv4-Adresse (4) + Port (2) + Größe (4) + MD5 (16) + Prüfwert (8, gekürzter HMAC-SHA256 über die ersten 46 Byte); `virusID` = Kennung des Auslösers; gesendet nur von App + Bridge, Badges leiten 3× weiter — siehe *Funk-Update der Badges*). (`1`–`9` lösen Effekte aus — mit `11` seit 1.5.0 die Tap-*Meldung*, kein Effekt; `10` beendet die Welle, `12` stoppt alle Effekt-Slots außer Identify; `0` ist Standard nach Stopp bzw. bei reiner Nähe-Logik.)

**Paketlängen:** 13 Byte (alte Firmware ohne Version), 17 (`SyncPacket`), 21 (Welle von Badges), 23 („Badge finden" und weitergeleitete Tap-Meldung), 54 (Funk-Update).

**`virusID`-Bereiche (ab Badge-FW 1.6.0):** `1`…`99999` gehören dem Morse-Virus der Badges (endet nach 3 s). Basisstation (ab 0.4.2), Bridge (ab 0.4.2) und App (ab 0.2.2, `100001`…`2³²−1`) vergeben nur Kennungen darüber — daran erkennt ein Badge, ob ein Virus endlos laufen soll.

**Stationen:** Basisstation und Bridge senden `ver_major == 0`. Badges erkennen sie daran und zählen sie weder als Peer (ab 1.5.1) noch für den Takt (ab 1.3.0); Basisstation und Bridge führen sich gegenseitig nicht in ihrer Badge-Liste (ab 0.4.1). Eine Badge-Firmware mit Hauptversion 0 würde deshalb als Station gelten.

---

## Projekt-Dokumentation (nummeriert)

1. **Badge-Sketch:** `Herz_Schwarm_CCC_V.ino` (Repo-Wurzel), Ziel-Hardware **Waveshare ESP32-S3-Matrix**, **FQBN** `esp32:esp32:esp32s3`, Kanal **13**, `MAGIC_ID` wie im Sketch.
2. **Basisstation-Sketch:** Ordner `Herz_Schwarm_BaseStation/`, Datei `Herz_Schwarm_BaseStation.ino`, **FQBN** `esp32:esp32:esp32s3`; Ethernet **W5500** (Referenz-Pins Spotpear: SCK 13, MISO 12, MOSI 11, CS 14, RST 9, INT 10).
3. **Firmware-Version Basisstation:** `BASESTATION_FW_MAJOR/MINOR/PATCH` im Basisstation-Sketch; in der Web-UI und in JSON (`/api/peers` → `station`) sichtbar (JSON-Key `station` ist ein fester String, unabhängig vom Define-Namen).
4. **Web-UI Basisstation:** **http://herz-base.local** (mDNS, ab 0.2.0) bzw. HTTP Port **80** auf der per DHCP vergebenen Ethernet-IP (Hostname `herz-base`, IP auch im Serial-Log `ETH IP: …`): Peers-Tabelle (Polling), alle Effekte **1–8** (Virus / Regenbogen / Primzahl-Party / Welle / Beat / Zonen / Ambient mit Farbwähler / Strobe), **MQTT-Konfiguration** (Formular). Ab 0.3.1: Der Welle-Button ist ein Toggle („🌊 Welle“ ↔ „⏹ Welle stoppen“, sendet Modus `10`); die Basisstation bleibt im Versand zustandslos und lernt den laufenden Wellenzustand aus den weitergeleiteten Badge-Paketen (Modus 4 → läuft, Modus 10 → gestoppt), angezeigt über das Peers-Polling (`wave`). Ab 0.4.0: Knopf **„⏹ Alle stoppen"** (Modus `12`); Tap-Zahlen (Modus `11`) werden in der Web-UI **nicht** angezeigt — sie stehen nur als `taps` je Peer in `GET /api/peers` und als Ereignis auf dem MQTT-Status-Topic.
5. **REST-API Basisstation:** `GET /api/peers` (JSON: Station-Version, `wave` (`true`/`false` — gelernt aus Badge-Paketen: Modus 4 → läuft, Modus 10 → gestoppt), Peer-Liste mit MAC, RSSI, Firmware-String, Alter und — ab 0.4.0 — `taps` (Tap-Zählerstand je Peer); `GET /api/peers` enthält außerdem `mqtt.enabled`/`mqtt.connected`; `POST /api/effect?m=1…8|10|12` (`m=10` stoppt die laufende Welle, ab 0.3.1; `m=12` stoppt alle Effekt-Slots außer Identify — global, ab 0.4.0; bei `m=7` optional `&c=RRGGBB` als Ambient-Farbe, Default Weiß; ungültiges `m` → HTTP 400); `POST /api/virus` (Alias für `m=1`); `POST /api/identify?mac=AA:BB:CC:DD:EE:FF` („Badge finden“, Modus 9, 3× gesendet); `POST /api/ota` (Firmware-Upload, multipart, HTTP Basic Auth `admin` / OTA-Passwort, danach Neustart); `GET /api/mqtt` (Konfiguration **ohne** Passwort, mit `has_password` und `connected`); `POST /api/mqtt` (Form-URL-encoded: `en`, `host`, `port`, `user`, optional `pass`, `ts`, `tc` — leeres Passwort = unverändert).
6. **MQTT:** **Klartext-TCP** (typisch Port **1883**), **kein TLS**. Einstellungen in **NVS** (`Preferences`, Namespace `hs_mqtt`); Broker per **Hostname oder IP** (`Network.hostByName`). Topics konfigurierbar: Status (Publish, JSON wie Peers-Kurzform), Befehl (Subscribe). Befehls-Payload: leer → Virus (`m=1`, wie bisher); `N` → Effekt `N` (1–8); `10` → laufende Welle stoppen (ab Basisstation 0.3.1; das Stopp-Paket trägt die zuletzt gelernte Ziel-Wellen-ID im `virusID`-Feld, `0` = Wildcard); `12` → alle Effekte stoppen (ab 0.4.0, globales Stopp-Paket; ab 0.4.2 mit eigener Kennung im `virusID`-Feld statt `0`); `7:RRGGBB` → Ambient-Farbe. Ab 0.4.0 publiziert die Basisstation bei einem **neuen Tap-Höchststand** zusätzlich `{"evt":"tap","mac":"…","count":N}` auf dem Status-Topic.
7. **Kompilieren Basisstation:** `arduino-cli compile Herz_Schwarm_BaseStation` — **ohne `--fqbn`**, Board-Optionen kommen aus `Herz_Schwarm_BaseStation/sketch.yaml` (`PartitionScheme=no_fs`: 2× 2 MB App statt 1,25 MB, Flash-Auslastung ~52 % statt 78 %; `CDCOnBoot=cdc`: Serial-Log über USB). Ein explizites `--fqbn` überschreibt die Datei. In der Arduino IDE: *Partition Scheme* „No FS 4MB (2MB APP x2)“ und *USB CDC On Boot* „Enabled“ wählen. NVS-Offset ist identisch zu „Default“ → MQTT-Konfiguration bleibt beim Umstellen erhalten.
8. **Flashen Badge:** `arduino-cli upload -p <PORT> --fqbn esp32:esp32:esp32s3 .` im Repo-Wurzelverzeichnis; Port mit `arduino-cli board list`.
9. **Flashen Basisstation:** `arduino-cli upload -p <PORT> Herz_Schwarm_BaseStation` (ebenfalls ohne `--fqbn`, damit die neue Partitionstabelle mitgeflasht wird). **Ab 0.3.0 auch per OTA** über die Web-UI (Karte *Firmware-Update*): `arduino-cli compile --export-binaries Herz_Schwarm_BaseStation` und `Herz_Schwarm_BaseStation/build/esp32.esp32.esp32s3/Herz_Schwarm_BaseStation.ino.bin` hochladen — das **App-Binary** (auf dem Gerät liegt es nach dem Update z. B. als `Herz_Schwarm_BaseStation_0.4.0.bin`); **nicht** `.merged.bin`, weder Bootloader noch Partitionstabellen. Das **OTA-Passwort** ist einkompiliert: im öffentlichen Repo steht nur ein Platzhalter, das echte Passwort gehört in `Herz_Schwarm_BaseStation/ota_secret.h` (gitignored, Vorlage `ota_secret.h.example`). Ohne diese Datei warnt die Web-UI. Die erste Version mit OTA muss einmal per USB drauf. (**Nicht verwechseln:** Das Update der *Basisstation* ist dieser HTTP-Upload; die ESP32-**Bridge** der Nerves-App hat kein Netzwerk und wird per UART-OTA aus dem Dashboard aktualisiert — Punkt 12a.)
9a. **Batch-Update Badges:** `scripts/batch_flash_herz_schwarm.sh` (siehe Abschnitt *Batch-Update*), Log: `firmware_update_log.csv` / `firmware_update_log.md`, Build-Cache `build_batch/`.
10. **Build-Artefakte und Geheimnisse:** Ordner `build_debug/`, `build_batch/`, `build_batch_gui/`, `build_basestation/`, `build_bridge/` und `build_ota/` sind in `.gitignore` und gehören nicht ins Repository. Ebenso `ota_secret.h` (Badge: WLAN-Zugang und Schlüssel für das Funk-Update) und `Herz_Schwarm_BaseStation/ota_secret.h` (OTA-Passwort der Basisstation) — im Repo liegen nur die Vorlagen `ota_secret.h.example`.
11. **Abwärtskompatibilität:** Badges mit alter Firmware reagieren nur auf **`mode == 1`** (Virus); `2`–`8` werden ignoriert. Basisstation und Nerves-Controller können trotzdem alle Modi senden. Modus `10` (Welle stoppen) versteht nur Badge-FW ab **1.4.1** — ältere Badges ignorieren ihn und laufen wie bisher in ~4 s aus (nicht endlos); gesendet wird er ab Basisstation **0.3.1**. Modi `11` (Tap-Meldung) und `12` (Alle stoppen) versteht nur Badge-FW ab **1.5.0** — ältere Badges ignorieren beide; `12` senden Basisstation ab **0.4.0** und das Nerves-Dashboard ab App 0.2.0 / Bridge 0.4.0. Tap-Weiterleitung (23 Byte) und Tap-Anzeige in der App setzen Bridge **0.4.0** voraus. **Gemischter Schwarm mit Badges unter 1.6.0:** Sie lassen den Morse-Virus endlos laufen, leiten „Alle stoppen" ohne Kennung weiter und koppeln Tempo und Helligkeit noch an den Durchschnitt aller Badges — sauber wird das erst, wenn alle auf 1.6.0 oder neuer sind. Modus `13` (Funk-Update) versteht nur Badge-FW ab **1.7.0** mit `ota_secret.h`; alle anderen Badges ignorieren ihn, ältere müssen also einmal per USB geflasht werden.
12. **Nerves-Controller:** Ordner `herz_schwarm_nerves/`, Elixir/Phoenix-App, als Nerves-Firmware für **Raspberry Pi 4** angelegt, im Betrieb aber als normale Phoenix-App auf Raspberry Pi OS (siehe *Betrieb auf dem Raspberry Pi*). Steuert Badges über USB-ESP32-Bridge (ESP-NOW Kanal 13). Web-UI auf Port 4000 mit Badge-Liste und „🔎 Finden“ (Modus 9, ab Bridge 0.2.0 / App 0.1.2). Bridge-Firmware: `herz_schwarm_nerves/firmware/esp32_bridge/esp32_bridge.ino` (Arduino, benötigt ArduinoJson-Library). Effektmodi 1–8 plus Wellen-Stopp (Modus `10`, Welle-Button als Toggle, ab Bridge 0.2.1 / App 0.1.3), Beat-Tap-Tempo, Ambient-RGB-Steuerung. Koexistiert mit Basisstation (unterschiedliche `virusID`s). Ab App 0.2.0 / Bridge 0.4.0: Dashboard mit **Tap-Counter-Karte** (Modul `HerzSchwarm.TapCounter`: Merge über Maximum je Badge, Gesamtsumme inkl. verdrängter Badges über ein High-Water-Mark, max. 64 Badges; Anzeige der Einzelergebnisse mit Rückfrage-Reset — Reset setzt nur die *Anzeige* auf 0 via Offset je MAC, die Badge-Zähler laufen weiter. Persistenz: JSON-Datei, Pfad aus Config `:tap_store_path`, Default `~/.local/share/herz-schwarm/taps.json`, Schreiben gedrosselt auf max. alle 5 s, atomar). Neuer Knopf **„Alle Effekte auf den Badges stoppen"** (Modus `12`). **Bedienfehler behoben:** BPM-Slider und Farbwähler hingen nicht an einem `<form>` — `phx-change` feuert auf Einzel-Inputs nur innerhalb eines Formulars, deshalb kamen Tempo- und Farbänderungen nie an; jetzt in Formularen, und das Verschieben des Tempo-Sliders startet den Beat nicht mehr (Start nur über „Start"). Die App hat bewusst keinen Login — im Netz ist sie damit grundsätzlich ungeschützt. Die LiveView-Seite **`DiagnoseLive`** (`/diagnose`) zeigt Zähler, Bridge-Uptime/Heap, Log-Filter und RSSI-Verlauf der Badge-Metriken.
12a. **Bridge-UART-Protokoll & UART-OTA (ab Bridge 0.3.0 / App 0.2.0):** Kommandos sind newline-JSON über Serial (115200 Baud, max. 256 Byte pro Zeile): neben `effect`/`status`/`peers`/`identify` neu `ota_begin` (`size`, optional informativ `ver`) → `Update.begin`, `ota_chunk` (`off`, `data` = Base64 über 96 Rohbytes) → `Update.write` mit je einem `ack`/`err` pro Chunk (strikt sequenziell, Wiederholung des letzten Chunks ist idempotent), `ota_end` → `Update.end(true)` + Neustart der Bridge, `ota_abort` → verwirft das Update. `pong` meldet zusätzlich `fw` (Bridge-Version) und `ota` (`idle`/`writing`/`error`); Firmware < 0.3.0 sendet beide Felder nicht. Ab Bridge 0.4.0 kommen über UART zusätzlich Tap-Meldungen an: `{"evt":"tap","mac":"AA:BB:CC:DD:EE:FF","count":N}` — nur bei neuem Höchststand einer MAC (Dedup in der Bridge). Während eines Updates antwortet `effect` mit `err` `busy: ota` (`status`/`peers` laufen weiter); ein verwaistes Update wirft die Bridge nach 30 s ohne Verkehr automatisch zurück (dann `ota:"error"` im pong, Effekte wieder möglich). **Voraussetzung Partitionierung:** `firmware/esp32_bridge/sketch.yaml` setzt `PartitionScheme=min_spiffs` (zwei App-Slots à ~1,9 MB); laut Build belegt die Firmware 46 % des Slots (S3) bzw. ~50 % (C3), mit dem `default`-Schema wären es 69 % von nur 1 310 720 B. Ein **bereits geflashtes Gerät muss einmalig per USB** mit dem neuen Schema geflasht werden (die Partitionstabelle wird mitgeschrieben) — erst danach funktioniert OTA; ohne OTA-Slot schlägt `Update.begin` fehl und die Update-Seite zeigt die Fehlermeldung. Bekannte Grenzen: keine eigene Prüfsumme pro Chunk (Integrität prüft `Update.end` über die Image-Prüfsumme), die App akzeptiert als Datei nur `.bin` mit ESP-Magic-Byte `0xE9`, der reale OTA-Ablauf auf Hardware ist noch nicht getestet. **Abgrenzung zur Basisstation (Punkt 9):** deren Update läuft als HTTP-Upload in der eigenen Web-UI — die Bridge hat kein Netzwerk, ihr Update kommt per UART aus dem Nerves-Dashboard. Neue Seite **`/bridge-update`**: zeigt Bridge-Firmware-Version und OTA-Zustand, Upload der Sketch-`.bin` (≈ 900 kB, z. B. `esp32_bridge.ino.bin`, max. 2 MB — **nicht** `.merged.bin`, nicht den Bootloader), Start/Abbruch, Fortschrittsbalken (Prozent + Bytes); der Dashboard-Header zeigt die Bridge-Version und verlinkt die Seite. Ablauf in der App: sequenziell in 96-Byte-Chunks, 1000 ms Timeout pro Chunk, max. 3 Wiederholungen, danach automatischer Abbruch; `ota_begin`/`ota_end` mit 20 s Timeout ohne Wiederholung; Gesamt-Timeout 10 min. Grobe Faustregel laut Implementierer: ~5–7 kB/s → ~2,5–4 min für ein ~900 kB-Image. Details: `herz_schwarm_nerves/MAC_SETUP.md`.
12b. **Funk-Update der Badges (ab Badge 1.7.0 / Bridge 0.5.0 / App 0.3.0):** Seite **`/badge-update`** (Modul `HerzSchwarm.BadgeOta`): legt die Badge-`.bin` ab (Verzeichnis aus Config `:badge_ota_dir`, Standard `~/.local/share/herz-schwarm`), liefert sie unter `GET /firmware/badge.bin` aus und baut das signierte 54-Byte-Auslösepaket (Schlüssel aus der Umgebungsvariable `BADGE_OTA_KEY`). An die Bridge geht es als `{"cmd":"badge_ota","pkt":"<Base64, 54 Byte>"}`; die Bridge prüft Länge, Magic und Modus und sendet es 3×. Ablauf und Grenzen: Abschnitt *Funk-Update der Badges*. Am Gerät noch nicht getestet.
**Sicherheitshinweis (`/bridge-update`):** Die Update-Seite hat **keinen Login** — jeder, der die App im Netz erreicht, kann eine Bridge-Firmware hochladen und flashen. Die App nur in einem vertrauenswürdigen Netz betreiben oder den Zugriff auf Netzwerkebene beschränken (Firewall/VPN/LAN-Segment); ein Login gibt es bewusst noch nicht — im Gegensatz zur OTA der Basisstation (Punkt 9), die HTTP Basic Auth nutzt.
13. **Cursor / Arduino CLI:** Zusätzliche Befehle in `.cursor/rules/arduino-cli.mdc`.
14. **Prüfung:** keine CI — Kompilieren und Tests laufen von Hand, siehe Abschnitt *Prüfen vor dem Push*.
15. **Offene Punkte und Tests am Gerät:** `todo.md`.
16. **Eigene Badge-Hardware:** `herz_badge/` (KiCad, Akku-Version; Stand in `herz_badge/README.md`).

### Code Adjustments
Ensure the FastLED initialization matches the Waveshare hardware (im Sketch ist die Farbreihenfolge wie dort verdrahtet gesetzt, siehe `Herz_Schwarm_CCC_V.ino`):
`FastLED.addLeds<WS2812B, 14, RGB>(leds, 64);` — die Matrix ist **RGB** verdrahtet (am Gerät verifiziert; mit `BGR` waren Rot und Blau vertauscht).

---
**Happy Hacking!** 🚀✨
