silly82/Herz_Schwarm_CCC_V/herz_badge/docs/datasheets/C3013940_ESP32-S3FH4R2.md

# ESP32-S3FH4R2 (C3013940)
Source: docs/datasheets/C3013940_ESP32-S3FH4R2.pdf, fetched 2026-10-17 by scripts/fetch_datasheets.py

Espressif ESP32-S3 series datasheet v1.9, **Chinese edition**. PDF page = printed page. FH4R2 = 4 MB quad flash + 2 MB quad PSRAM in package, -40 to 85 °C.

## Key numbers

| Parameter | Min / Typ / Max | Conditions | Page |
|---|---|---|---|
| VDDA, VDD3P3, VDD3P3_RTC, VDD3P3_CPU | 3.0 / 3.3 / 3.6 V (abs max 3.6 V) | VDD3P3_CPU ≤ 3.3 V while burning eFuses | p60 |
| Supply capability I_VDD | ≥0.5 A | single supply | p60 |
| Wi-Fi RX | 88 mA (HT20), 91 mA (HT40) | peak, 3.3 V, CPU 80 MHz | p62 |
| Wi-Fi TX | 340 mA @21 dBm (11b); 291 @19 dBm (11g); 283 @18.5 dBm (HT20 MCS7); 286 @18 dBm (HT40) | peak, 100 % duty | p62 |
| TX at 13 dBm / reduced power | not given | | p62 |
| Modem-sleep (WAITI) | 22.0 / 36.1 mA @80 MHz; 27.6 / 42.3 @160; 32.9 / 47.6 @240 | periph clocks off / on | p63 |
| Modem-sleep (dual-core busy) | 33.1-107.9 mA depending on clock and load | | p63 |
| Light-sleep | 240 µA + 40 µA for 2 MB quad PSRAM (≈280 µA) | VDD_SPI and Wi-Fi off | p63 |
| Deep-sleep | 7 µA (RTC mem on); 8 µA (RTC mem + RTC periph on) | | p63 |
| Off (CHIP_PU low) | 1 µA | | p63 |
| Brownout threshold / default | not given | | – |
| VDD_SPI for FH4R2 | 3.3 V, fed from VDD3P3_RTC via R_SPI = 14 Ω | | p13, p61 |
| VDD_SPI select | EFUSE_VDD_SPI_FORCE = 0 -> GPIO45 strap: 0 = 3.3 V (default, weak pull-down), 1 = 1.8 V | | p29, p31 |
| CHIP_PU timing | t_STBL ≥ 50 µs (rails stable before release), t_RST ≥ 50 µs (low to reset) | | p27 |
| CHIP_PU levels | VIH_nRST ≥ 0.75 x VDD, VIL_nRST ≤ 0.25 x VDD; must not float | | p25, p61 |
| Strapping hold t_H | ≥3 ms after CHIP_PU high | GPIO0 pull-up = SPI boot | p29, p30 |
| GPIO | VIH 0.75 VDD, VIL 0.25 VDD, VOH ≥ 0.8 VDD; I_OH 40 mA / I_OL 28 mA (drive 3); R_PU / R_PD 45 kΩ | 3.3 V, 25 °C | p61 |

## Notes for this board
- GPIO45 must be low at reset (or VDD_SPI fixed by eFuse). A pull-up on GPIO45 selects 1.8 V and the in-package 3.3 V flash/PSRAM will not boot.
- 7 GPIOs are taken by the in-package flash/PSRAM (SPICS0/SPICS1, CLK, D, Q, WP, HD; pins 28-35) and are not free (p4, p28).
- The modem-sleep table is stated for S3/S3FH8; PSRAM parts "may be slightly higher" (p62).
- RF figures are peak values at 100 % TX duty; average current for the sim depends on the duty cycle.
- The 3.3 V rail must stay ≥3.0 V at the ~340 mA TX peak. With the ME6217's 100-180 mV dropout at 300 mA, VSW ≥ ~3.2 V keeps the rail above 3.0 V, and VSW ≥ ~3.5 V keeps it in regulation.
- Main crystal is required (p38). Its frequency and load caps are not specified in this edition.
