silly82/Herz_Schwarm_CCC_V/herz_badge/docs/datasheets/C427602_ME6217C33M5G.md

# ME6217C33M5G (C427602)
Source: docs/datasheets/C427602_ME6217C33M5G.pdf, fetched 2026-10-17 by scripts/fetch_datasheets.py

Microne ME6217 series, rev V02. C = with CE pin, 33 = 3.3 V, M5 = SOT-23-5.

## Key numbers

| Parameter | Min / Typ / Max | Conditions | Page |
|---|---|---|---|
| Pinout (SOT-23-5) | 1 VIN, 2 VSS, 3 CE, 4 NC, 5 VOUT | ME6217Cxx | p2 |
| Output voltage | 0.99 / 1.00 / 1.01 x 3.3 V | I_OUT = 100 mA, V_IN = 4.3 V | p4 |
| Dropout @100 mA | ≈30 mV (graph) | ME6217C50 curve only, V_IN = V_OUT + 1 V | p7 |
| Dropout @200 mA | ≈60 mV (graph) | ME6217C50 curve only | p7 |
| Dropout @300 mA | – / 100 / 180 mV | 3.0 V ≤ V_OUT ≤ 5.5 V | p4 |
| Dropout definition | V_IN where V_OUT = 98 % of nominal | note 3 | p4 |
| Quiescent current I_SS1 | – / 100 / 130 µA | CE on, no load | p4 |
| Shutdown current I_SS2 | – / 0.1 / 1.0 µA | CE off | p4 |
| Max output current | 800 mA | V_IN ≥ V_OUT + 1 V, limited by package P_D | p4 |
| Input range | 2.0 to 6.5 V; abs max 7.0 V | | p2, p4 |
| Short-circuit current | 350 mA typ | V_OUT = 0 V (foldback) | p4 |
| Thermal shutdown | 160 °C | | p4 |
| CE thresholds | V_CEH ≥ 1.5 V, V_CEL ≤ 0.3 V; I_CE ±0.1 µA | no internal pull, do not float | p4, p5 |
| Load regulation | 10 / 50 mV | 1-300 mA | p4 |
| Required caps | C_IN ≥ 4.7 µF, C_L ≥ 4.7 µF, ESR ≤ 0.5 Ω | tested with 10 µF / 10 µF | p4, p6 |

## Notes for this board
- Use the SOT-23-5 column on p2. The application drawing on p1 numbers the pins like SOT-89-5 (1 CE, 4 VIN), which is wrong for M5. The AP2112K-3.3 symbol pinout (1 VIN, 2 GND, 3 EN, 5 VOUT) matches.
- The dropout curve is only given for the 5.0 V part. For the 3.3 V part only the 300 mA table value applies (100 typ / 180 max). Keep VSW ≥ ~3.5 V for Wi-Fi TX peaks (~340 mA).
- Iq vs V_IN (p7, C50 only) climbs to ~200 µA as V_IN approaches V_OUT. Expect higher Iq in dropout on a low battery; no 3.3 V curve is given.
- SOT-23-5 power dissipation is not given (only SOT-89-5 = 1000 mW). On USB, (4.6 - 3.3) V x 0.3 A ≈ 0.4 W at peaks.
- Tie CE to VIN (VSW); the datasheet forbids floating CE. V_OUT must not exceed V_IN + 0.3 V (reverse body diode, p5).
- Output may rise at loads ≤1 mA (p6), which matters in ESP32 deep sleep.
