silly82/Herz_Schwarm_CCC_V/herz_badge/docs/datasheets/C431540_MSK12C02.md

# MSK12C02 (C431540)
Source: docs/datasheets/C431540_MSK12C02.pdf, fetched 2026-10-17 by scripts/fetch_datasheets.py

Shenzhen Shouhan 7-pin SMD slide switch, spec Version A/0 (2024-12-14). PDF p1 is the drawing; PDF p3-p7 are spec pages "1/5"-"5/5".

## Key numbers

| Parameter | Min / Typ / Max | Conditions | Page |
|---|---|---|---|
| Contact rating | 12 V DC, 50 mA | | p1, p4 |
| Contact resistance | ≤100 mΩ (≤200 mΩ after env. tests, ≤500 mΩ end of life) | 5 V 10 mA | p4-p6 |
| Insulation / dielectric | ≥100 MΩ @ 100 V DC; 250 VAC 1 min | | p4 |
| Lever travel | 1.6 ±0.2 mm full travel | | p1, p4 |
| Operating force | 150 ±100 gf | | p4 |
| Life | 10,000 cycles | no load, 60/min | p6 |
| Operating temperature | -20 to +70 °C | | p3 |
| Contacts | ③ ② ① on one side, ② = common; drawn state ②-③ closed, ① open | circuit diagram | p1 |
| Pin spacing | ③-② 1.5 mm, ②-① 3.0 mm (unequal) | | p1 |
| Shell | 4 tabs ④, drawn tied to ground | | p1 |
| Body / actuator | 8.0 x 2.8 mm body; knob 1.3 mm wide, 1.45 mm above body | | p1 |
| Land pattern | signal pads 0.6 x 1.3 mm; tab pads 1.05 x 0.7 mm (outer span 8.4, inner 6.3, rows 2.2 mm apart); 2 x Ø0.85 mm holes 3 mm apart | "安装参考图" | p1 |
| Soldering | reflow peak 260 °C, 1 pass only; hand 350 °C ≤3 s | | p7 |

## Notes for this board
- 50 mA rating: fine for switching the P-FET gate (≈40 µA through the 100 k). It must never carry load current.
- The text says "1 pole, 1 throw" (p4) but the part has three terminals. The drawing gives ②-③ in one position and does not state which position closes ②-①. Wire ② (common) and one outer pin, then confirm ON/OFF direction against the knob on a sample.
- Unequal 1.5 / 3.0 mm pitch: check the footprint (KiCad SW_SPDT_Shouhan_MSK12C02) against p1.
- Only one reflow pass is allowed. On a double-sided build, place the switch on the second side.
- In the ON position the 100 k gate pull-up draws VSYS / 100 k ≈ 30-47 µA continuously (a circuit property, not from this datasheet).
