silly82/Herz_Schwarm_CCC_V/herz_badge/boards/badge/mcu.kicad_sch

## KiCad design herz_badge/boards/badge/mcu.kicad_sch (2026-10-20)

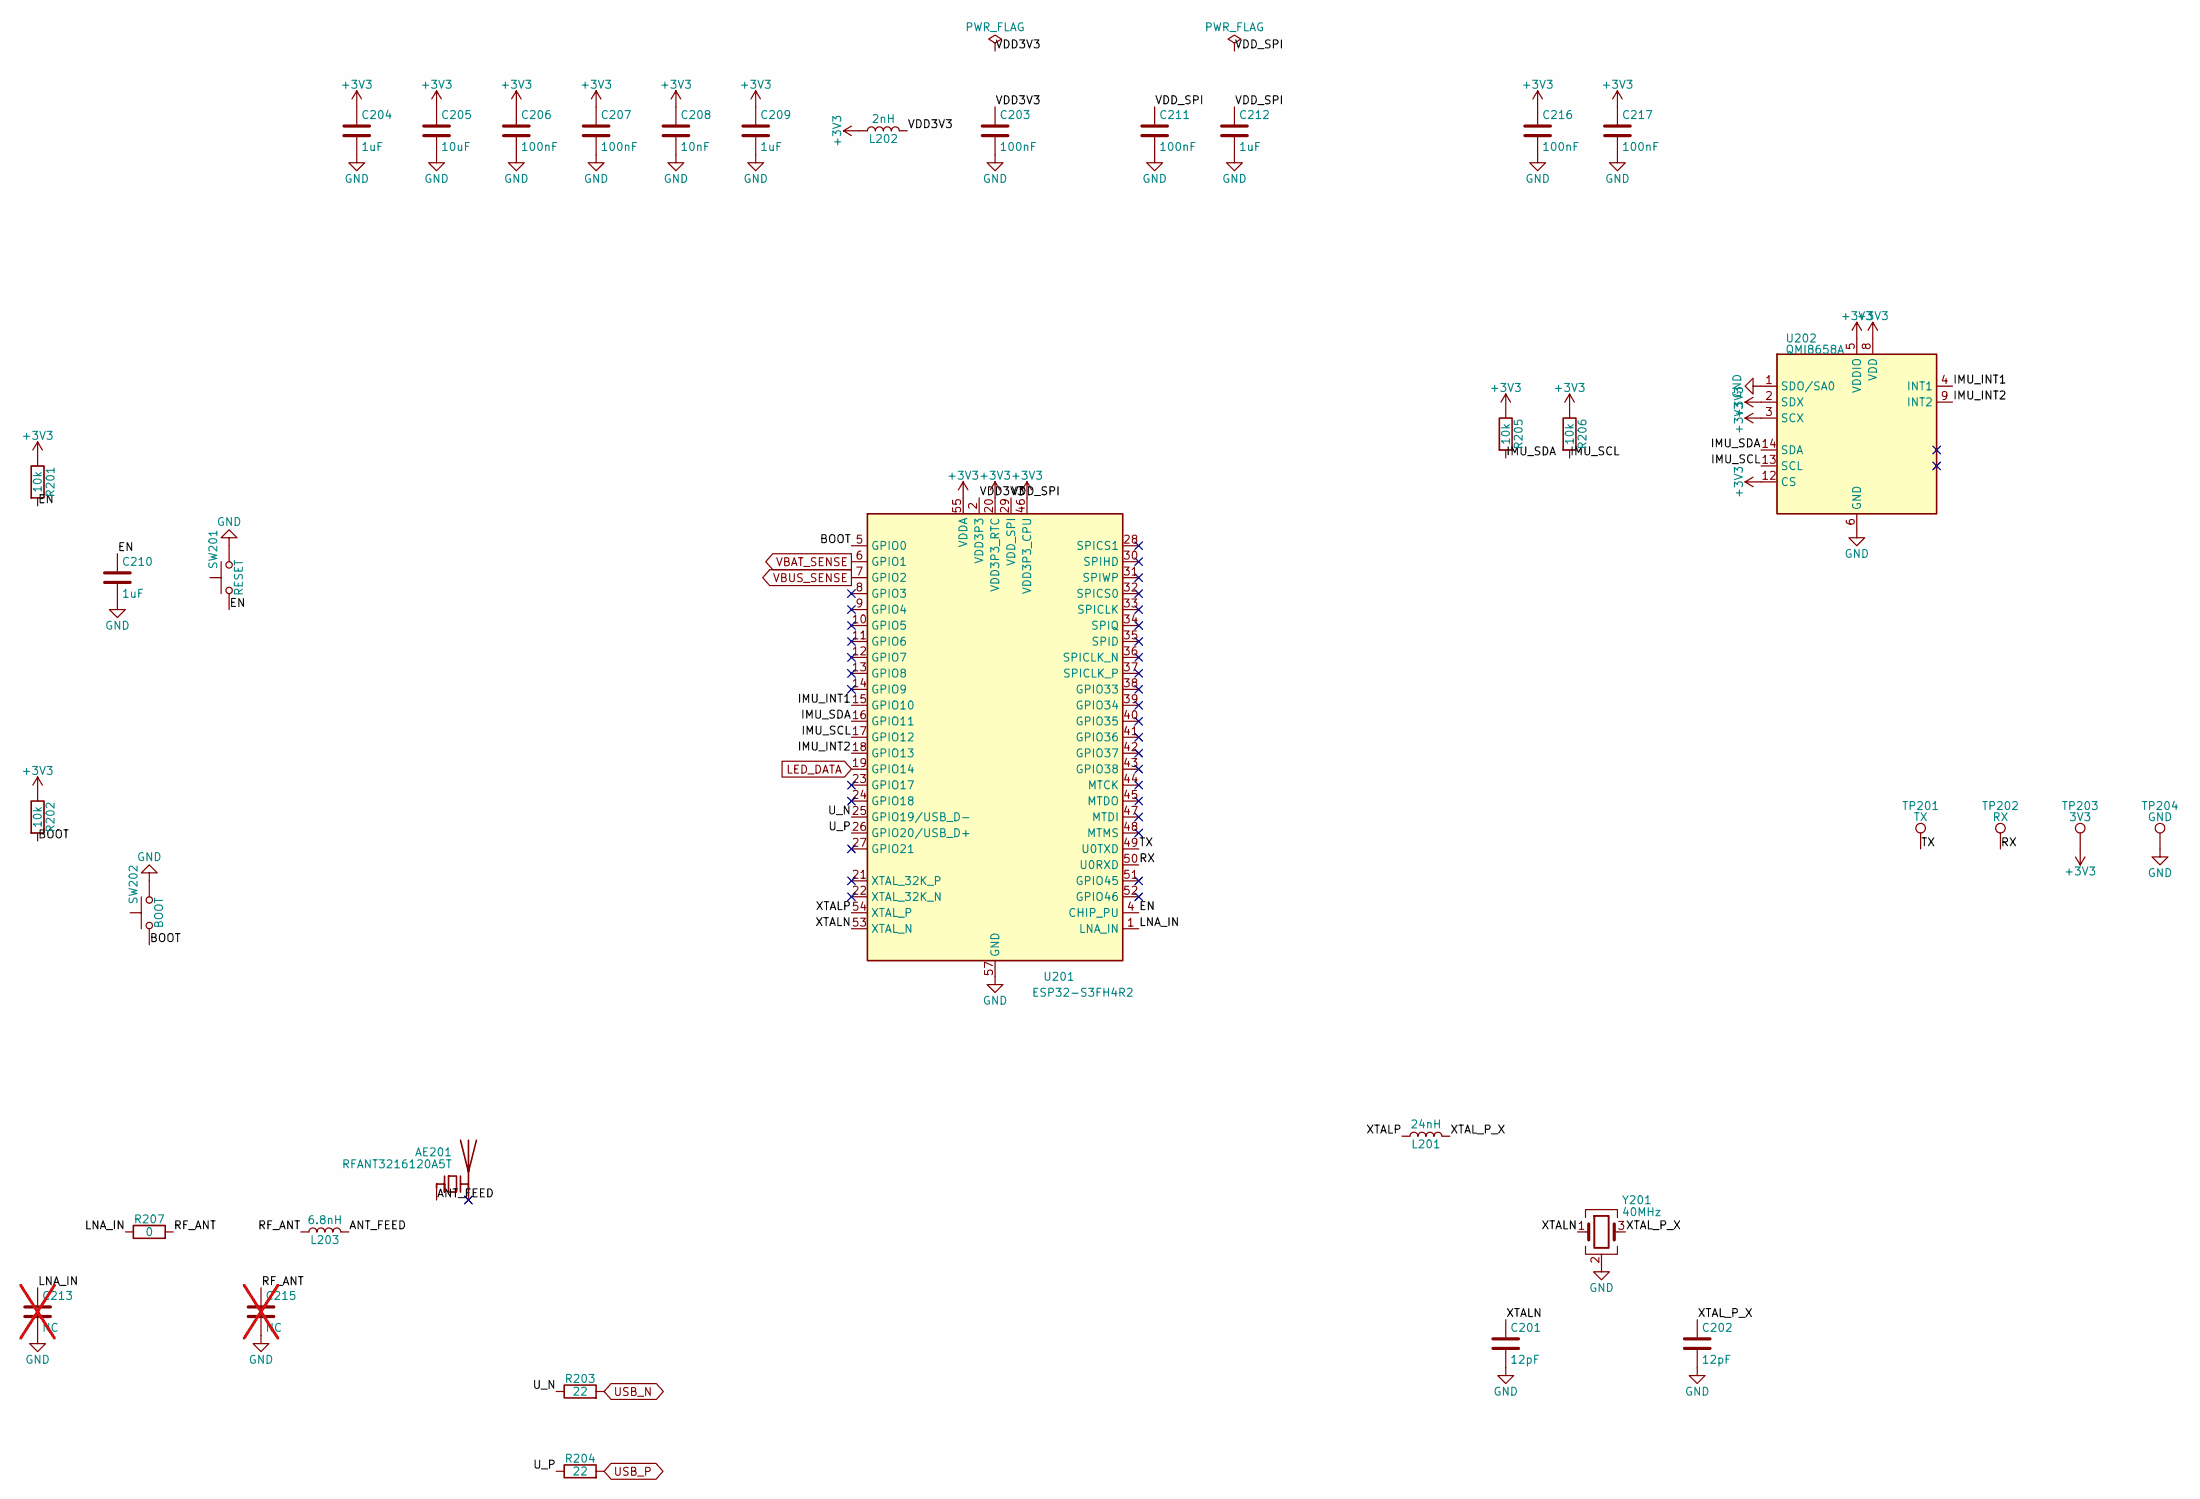
[picture p1: schematic mcu.kicad_sch]

Parts:
AE201: RFANT3216120A5T; ANT_Walsin_RFANT3216120A5T; LCSC C127629
C201, C202: 12pF; C_0402_1005Metric; LCSC C1547
C203, C206, C207, C211, C216, C217: 100nF; C_0402_1005Metric; LCSC C1525
C204, C209, C210, C212: 1uF; C_0402_1005Metric; LCSC C52923
C205: 10uF; C_0603_1608Metric; LCSC C19702
C208: 10nF; C_0402_1005Metric; LCSC C15195
C213, C215: NC; C_0402_1005Metric; not fitted
L201: 24nH; L_0402_1005Metric; LCSC C74301
L202: 2nH; L_0402_1005Metric; LCSC C76769
L203: 6.8nH; L_0402_1005Metric; LCSC C77110
R201, R202, R205, R206: 10k; R_0402_1005Metric; LCSC C25744
R203, R204: 22; R_0402_1005Metric; LCSC C25092
R207: 0; R_0402_1005Metric; LCSC C17168
SW201: RESET; SW_SPST_TS-1088-xR020; LCSC C455280
SW202: BOOT; SW_SPST_TS-1088-xR020; LCSC C455280
TP201: TX; TestPoint_Pad_D1.0mm
TP202: RX; TestPoint_Pad_D1.0mm
TP203: 3V3; TestPoint_Pad_D1.0mm
TP204: GND; TestPoint_Pad_D1.0mm
U201: ESP32-S3FH4R2; QFN-56-1EP_7x7mm_P0.4mm_EP4x4mm; LCSC C3013940
U202: QMI8658A; LGA-14_3x2.5mm_P0.5mm_LayoutBorder3x4y; LCSC C3021082
Y201: 40MHz; Crystal_SMD_3225-4Pin_3.2x2.5mm; LCSC C426988

Connections:
+3V3: C204.1, C205.1, C206.1, C207.1, C208.1, C209.1, C216.1, C217.1, L202.1, R201.1, R202.1, R205.1, R206.1, TP203.1, U201.20 (VDD3P3_RTC), U201.46 (VDD3P3_CPU), U201.55 (VDDA), U201.56 (VDDA), U202.2 (SDX), U202.3 (SCX), U202.5 (VDDIO), U202.8 (VDD), U202.12 (CS)
ANT_FEED: AE201.1 (FEED), L203.2
BOOT: R202.2, SW202.1, U201.5 (GPIO0)
EN: C210.1, R201.2, SW201.1, U201.4 (CHIP_PU)
GND: C201.2, C202.2, C203.2, C204.2, C205.2, C206.2, C207.2, C208.2, C209.2, C210.2, C211.2, C212.2, C213.2, C215.2, C216.2, C217.2, SW201.2, SW202.2, TP204.1, U201.57 (GND), U202.1 (SDO/SA0), U202.6 (GND), U202.7 (GND), Y201.2 (G), Y201.4 (G)
IMU_INT1: U201.15 (GPIO10), U202.4 (INT1)
IMU_INT2: U201.18 (GPIO13), U202.9 (INT2)
IMU_SCL: R206.2, U201.17 (GPIO12), U202.13 (SCL)
IMU_SDA: R205.2, U201.16 (GPIO11), U202.14 (SDA)
LED_DATA: U201.19 (GPIO14)
LNA_IN: C213.1, R207.1, U201.1 (LNA_IN)
RF_ANT: C215.1, L203.1, R207.2
RX: TP202.1, U201.50 (U0RXD)
TX: TP201.1, U201.49 (U0TXD)
USB_N: R203.2
USB_P: R204.2
U_N: R203.1, U201.25 (GPIO19/USB_D-)
U_P: R204.1, U201.26 (GPIO20/USB_D+)
VBAT_SENSE: U201.6 (GPIO1)
VBUS_SENSE: U201.7 (GPIO2)
VDD3V3: C203.1, L202.2, U201.2 (VDD3P3), U201.3 (VDD3P3)
VDD_SPI: C211.1, C212.1, U201.29 (VDD_SPI)
XTALN: C201.1, U201.53 (XTAL_N), Y201.1
XTALP: L201.1, U201.54 (XTAL_P)
XTAL_P_X: C202.1, L201.2, Y201.3
