silly82/Herz_Schwarm_CCC_V/herz_badge/boards/reference/mcu.kicad_sch

## KiCad design herz_badge/boards/reference/mcu.kicad_sch (2026-10-20)

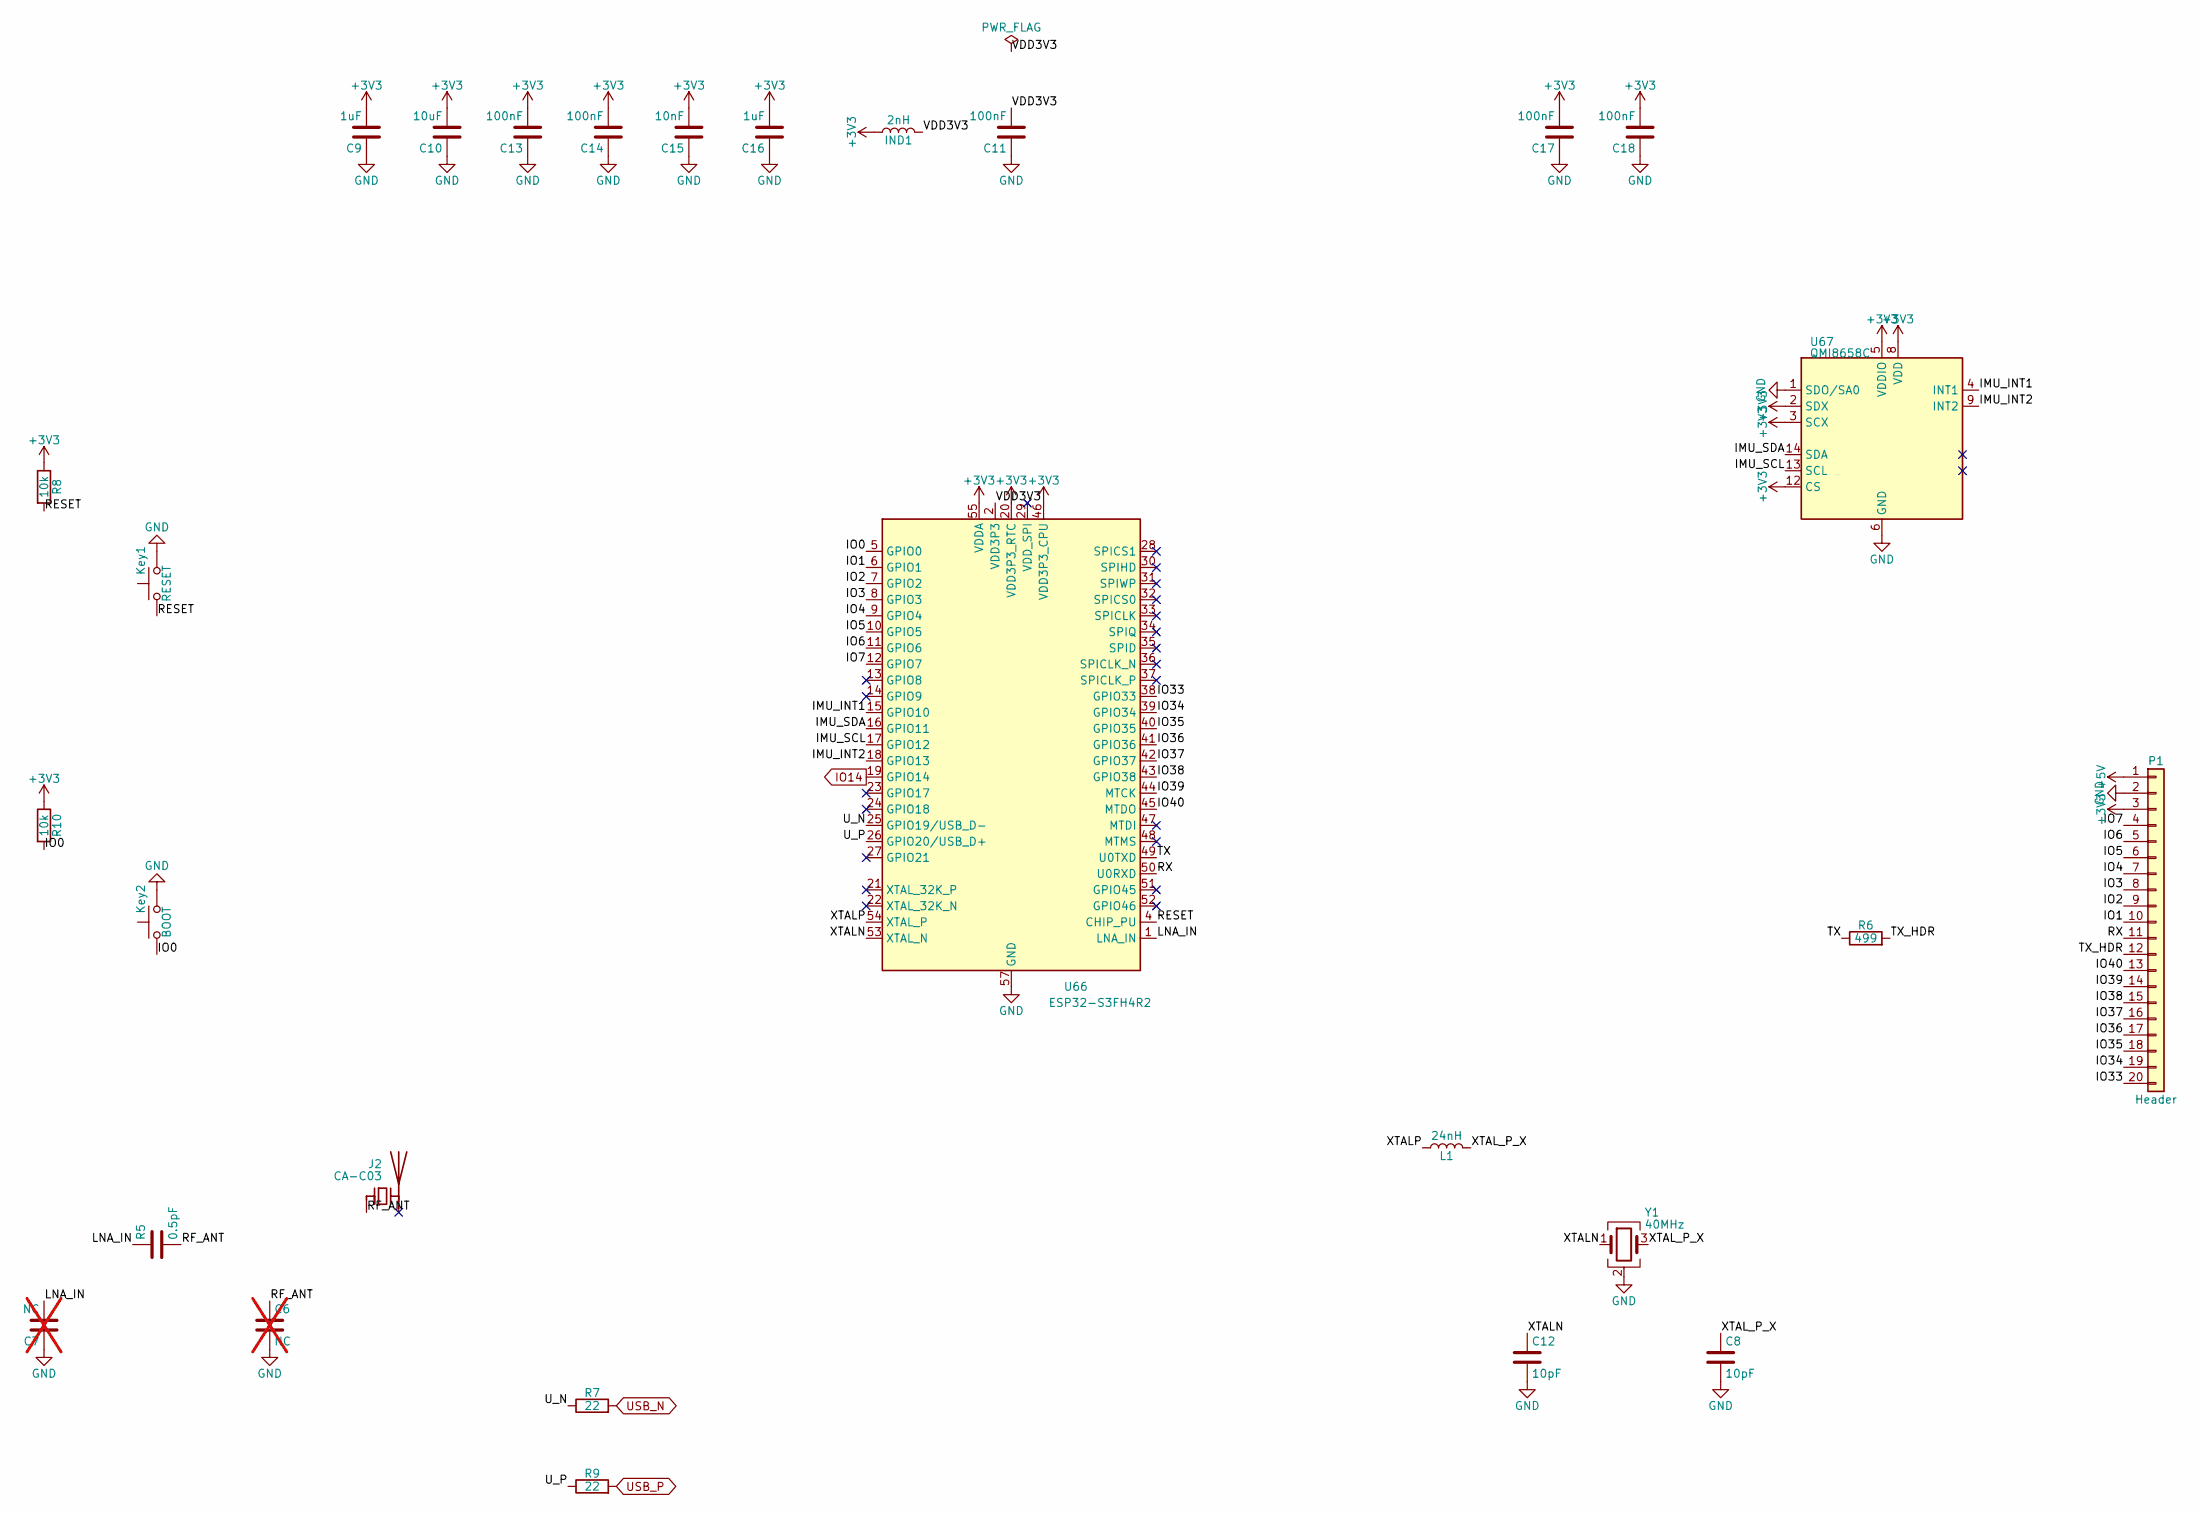
[picture p2: schematic mcu.kicad_sch]

Parts:
C6, C7: NC; C_0402_1005Metric; not fitted
C8, C12: 10pF; C_0402_1005Metric; LCSC C32949
C9, C16: 1uF; C_0402_1005Metric; LCSC C52923
C10: 10uF; C_0603_1608Metric; LCSC C19702
C11, C13, C14, C17, C18: 100nF; C_0402_1005Metric; LCSC C1525
C15: 10nF; C_0402_1005Metric; LCSC C15195
IND1: 2nH; L_0402_1005Metric; LCSC C76769
J2: CA-C03
Key1: RESET; SW_SPST_TS-1088-xR020; LCSC C455280
Key2: BOOT; SW_SPST_TS-1088-xR020; LCSC C455280
L1: 24nH; L_0402_1005Metric; LCSC C74301
P1: Header
R5: 0.5pF; C_0402_1005Metric; LCSC C1544
R6: 499; R_0402_1005Metric; LCSC C4125
R7, R9: 22; R_0402_1005Metric; LCSC C25092
R8, R10: 10k; R_0402_1005Metric; LCSC C25744
U66: ESP32-S3FH4R2; QFN-56-1EP_7x7mm_P0.4mm_EP4x4mm; LCSC C3013940
U67: QMI8658C; LGA-14_3x2.5mm_P0.5mm_LayoutBorder3x4y; LCSC C2842151
Y1: 40MHz; Crystal_SMD_3225-4Pin_3.2x2.5mm; LCSC C426988

Connections:
+3V3: C9.2, C10.2, C13.2, C14.2, C15.2, C16.2, C17.2, C18.2, IND1.1, P1.3, R8.1, R10.1, U66.20 (VDD3P3_RTC), U66.46 (VDD3P3_CPU), U66.55 (VDDA), U66.56 (VDDA), U67.2 (SDX), U67.3 (SCX), U67.5 (VDDIO), U67.8 (VDD), U67.12 (CS)
+5V: P1.1
GND: C6.2, C7.1, C8.2, C9.1, C10.1, C11.1, C12.2, C13.1, C14.1, C15.1, C16.1, C17.1, C18.1, Key1.2, Key2.2, P1.2, U66.57 (GND), U67.1 (SDO/SA0), U67.6 (GND), U67.7 (GND), Y1.2 (G), Y1.4 (G)
IMU_INT1: U66.15 (GPIO10), U67.4 (INT1)
IMU_INT2: U66.18 (GPIO13), U67.9 (INT2)
IMU_SCL: U66.17 (GPIO12), U67.13 (SCL)
IMU_SDA: U66.16 (GPIO11), U67.14 (SDA)
IO0: Key2.1, R10.2, U66.5 (GPIO0)
IO1: P1.10, U66.6 (GPIO1)
IO2: P1.9, U66.7 (GPIO2)
IO3: P1.8, U66.8 (GPIO3)
IO4: P1.7, U66.9 (GPIO4)
IO5: P1.6, U66.10 (GPIO5)
IO6: P1.5, U66.11 (GPIO6)
IO7: P1.4, U66.12 (GPIO7)
IO14: U66.19 (GPIO14)
IO33: P1.20, U66.38 (GPIO33)
IO34: P1.19, U66.39 (GPIO34)
IO35: P1.18, U66.40 (GPIO35)
IO36: P1.17, U66.41 (GPIO36)
IO37: P1.16, U66.42 (GPIO37)
IO38: P1.15, U66.43 (GPIO38)
IO39: P1.14, U66.44 (MTCK)
IO40: P1.13, U66.45 (MTDO)
LNA_IN: C7.2, R5.1, U66.1 (LNA_IN)
RESET: Key1.1, R8.2, U66.4 (CHIP_PU)
RF_ANT: C6.1, J2.1 (FEED), R5.2
RX: P1.11, U66.50 (U0RXD)
TX: R6.1, U66.49 (U0TXD)
TX_HDR: P1.12, R6.2
USB_N: R7.2
USB_P: R9.2
U_N: R7.1, U66.25 (GPIO19/USB_D-)
U_P: R9.1, U66.26 (GPIO20/USB_D+)
VDD3V3: C11.2, IND1.2, U66.2 (VDD3P3), U66.3 (VDD3P3)
XTALN: C12.1, U66.53 (XTAL_N), Y1.1
XTALP: L1.1, U66.54 (XTAL_P)
XTAL_P_X: C8.1, L1.2, Y1.3
