silly82/Herz_Schwarm_CCC_V/herz_badge/boards/reference/power.kicad_sch

## KiCad design herz_badge/boards/reference/power.kicad_sch (2026-10-20)

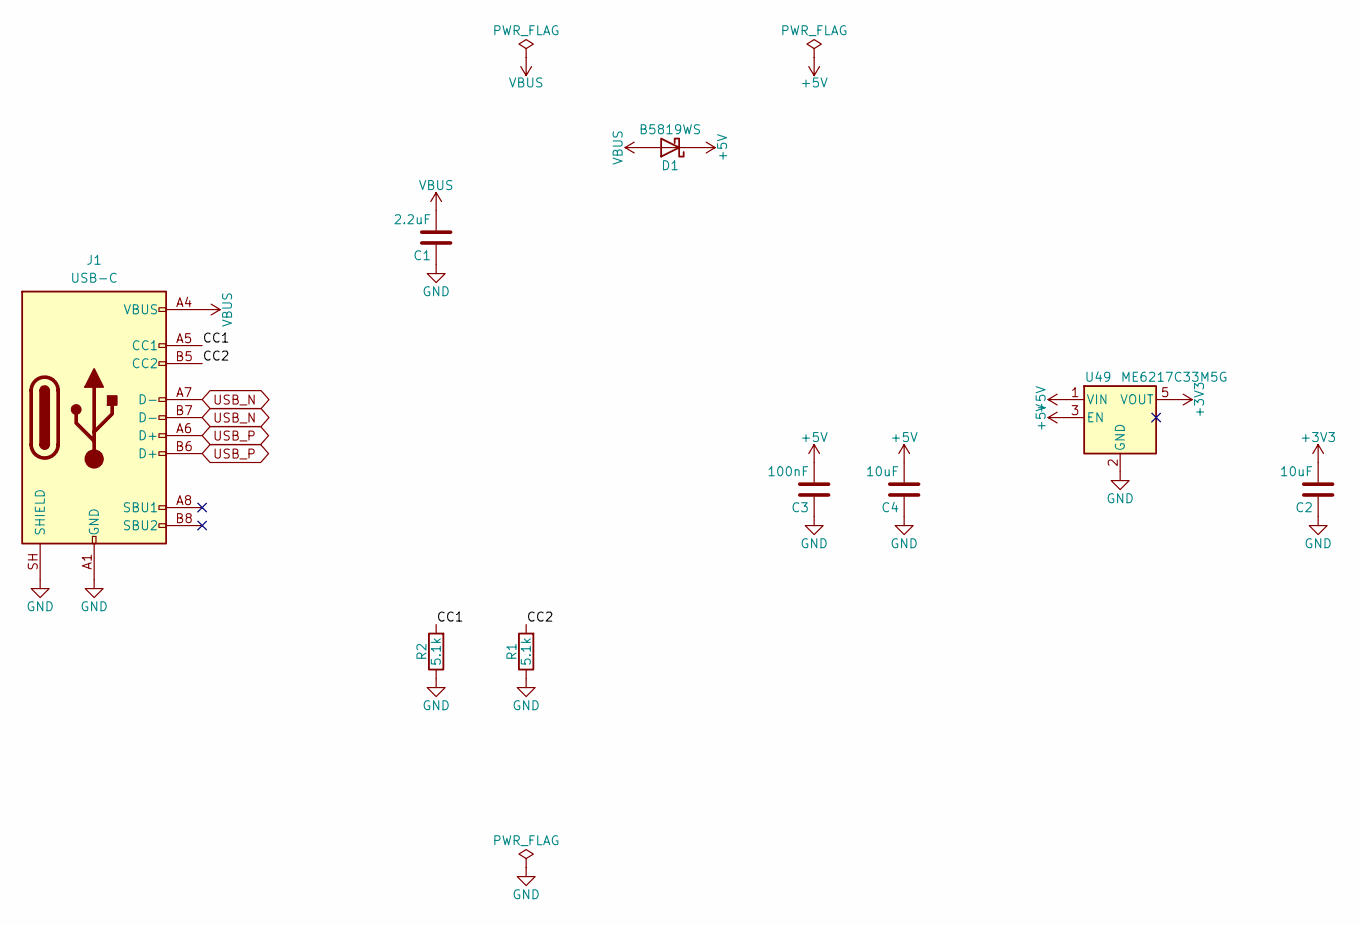
[picture p3: schematic power.kicad_sch]

Parts:
C1: 2.2uF; C_0402_1005Metric; LCSC C12530
C2, C4: 10uF; C_0603_1608Metric; LCSC C19702
C3: 100nF; C_0402_1005Metric; LCSC C1525
D1: B5819WS; D_SOD-323; LCSC C64886
J1: USB-C; USB_C_Receptacle_HRO_TYPE-C-31-M-12; LCSC C165948
R1, R2: 5.1k; R_0402_1005Metric; LCSC C25905
U49: ME6217C33M5G; SOT-23-5; LCSC C427602

Connections:
+3V3: C2.2, U49.5 (VOUT)
+5V: C3.2, C4.2, D1.1 (K), U49.1 (VIN), U49.3 (EN)
CC1: J1.A5 (CC1), R2.2
CC2: J1.B5 (CC2), R1.2
GND: C1.1, C2.1, C3.1, C4.1, J1.A1 (GND), J1.A12 (GND), J1.B1 (GND), J1.B12 (GND), J1.SH (SHIELD), R1.1, R2.1, U49.2 (GND)
USB_N: J1.A7 (D-), J1.B7 (D-)
USB_P: J1.A6 (D+), J1.B6 (D+)
VBUS: C1.2, D1.2 (A), J1.A4 (VBUS), J1.A9 (VBUS), J1.B4 (VBUS), J1.B9 (VBUS)
