silly82/Herz_Schwarm_CCC_V/Herz_Schwarm_CCC_V.ino

#include <esp_now.h>
#include <WiFi.h>
#include <FastLED.h>
#include <esp_wifi.h>
#include <Preferences.h>

// Funk-Update (OTA über WLAN, ab 1.7.0): nur aktiv, wenn ota_secret.h (gitignored, Vorlage:
// ota_secret.h.example) WLAN-Zugang und Schlüssel definiert. Ohne die Datei wird der gesamte
// OTA-Code nicht mitkompiliert und Modus 13 ignoriert — im öffentlichen Repo steht bewusst
// kein Standard-Schlüssel.
#if __has_include("ota_secret.h")
#include "ota_secret.h"
#endif
#if defined(OTA_WIFI_SSID) && defined(OTA_WIFI_PASS) && defined(OTA_KEY)
#define OTA_ENABLED 1
#include <HTTPClient.h>
#include <NetworkClient.h>
#include <Update.h>
#include "mbedtls/md.h"
#else
#define OTA_ENABLED 0
#endif

// Bewegungssensor (QMI8658 auf der Waveshare ESP32-S3-Matrix, ab 1.8.0). Abschalten mit
// -DENABLE_IMU=0. Antwortet beim Start kein passender Sensor, bleibt die Funktion von selbst aus.
#ifndef ENABLE_IMU
#define ENABLE_IMU 1
#endif
#if ENABLE_IMU
#include <Wire.h>
#endif

// Serial-Ausgaben blockieren und können die Animation ruckeln lassen — Standard: aus.
// Aktivieren: hier auf 1 setzen oder Build-Flag: -DENABLE_SERIAL_DEBUG=1
#ifndef ENABLE_SERIAL_DEBUG
#define ENABLE_SERIAL_DEBUG 0
#endif

/*
 * --- Firmware-Version (siehe README: „Firmware-Version“) ---
 * Git: Release mit Tag v1.0.0 auf main. 1.0.0 = Release-Linie (ESP-NOW Herzschwarm,
 * Primzahl/Singularität, Morse-Virus, optional Serial-Debug).
 *
 * Release-Build (ENABLE_SERIAL_DEBUG=0): Anzeige MAJOR.MINOR.PATCH
 * Debug-Build (ENABLE_SERIAL_DEBUG=1):    Anzeige MAJOR.MINOR.DD — DD zweistellig 01…99
 *
 * Versionsschema A.B.C.D (siehe README "Firmware-Version"):
 *   A = MAJOR: nur auf speziellen Wunsch (Breaking Change / Architektur-Wechsel)
 *   B = MINOR: großes neues Feature (Beispiel: 1.1.0 -> 1.2.0 = TUI)
 *   C = PATCH: kleines Feature / Refactor (max 99, danach B hoch)
 *   D = BUILD: jeder Git-Commit wird hochgezählt, NUR als Git-Tag/Commit-Marker,
 *              NICHT im Firmware-Code (würde bei jedem Commit neu kompiliert
 *              werden müssen). Tag-Format: vA.B.C.D, z. B. v1.2.0.5 = 5
 *              Commits seit 1.2.0 (oder seit letztem A.B.C-Wechsel).
 */
#define FW_VERSION_MAJOR 1
#define FW_VERSION_MINOR   8
#define FW_VERSION_PATCH   0  // 1.8.0: Bewegungssensor — Schütteln lässt das Herz flattern; Herz-immer-aufrecht und Abdunkeln in Ruhe als Optionen; 1.7.0: Funk-Update (OTA über WLAN, Modus 13, nur mit ota_secret.h); 1.6.0: Nähe steuert nur noch die Helligkeit (Tempo fest je Modus) und meint das nächste Badge statt des Mittels; ferngesteuerte Effekte mit fester Helligkeit; Morse-Virus endet nach 3 s; „Alle stoppen“ mit Kennung; 1.5.1: echtes 50-Hz-Frame-Raster + 20-Hz-Sync, Stationen zählen nicht als Peer, Regenbogen-Farbton schwarmsynchron; 1.5.0: Tap-Counter (Modus 11); Effekte laufen endlos bis „Alle stoppen“ (Modus 12), letzter Effekt gewinnt; 1.4.1: Welle läuft endlos (Zyklus 4 s) bis Stopp über Modus 10
#define FW_DEBUG_BUILD     1  // Nur Debug-Zweig: bei sichtbarem neuen Debug-Stand +1, max 99

#if FW_DEBUG_BUILD < 1 || FW_DEBUG_BUILD > 99
#error "FW_DEBUG_BUILD muss zwischen 1 und 99 liegen (zweistelliger Debug-Zähler)."
#endif

// Versions-Marker im Binary: "HERZFW:1.7.0;". Die App liest daraus die Version einer
// hochgeladenen .bin (für das Funk-Update), ohne dass man sie von Hand eintippen muss.
// setup() liest den Marker über einen volatile-Zeiger, damit ihn der Linker nicht entfernt.
#define FW_STR_(x) #x
#define FW_STR(x) FW_STR_(x)
static const char FW_MARKER[] =
    "HERZFW:" FW_STR(FW_VERSION_MAJOR) "." FW_STR(FW_VERSION_MINOR) "." FW_STR(FW_VERSION_PATCH) ";";
static const char *volatile fwMarkerPtr = FW_MARKER;

// --- HARDWARE EINSTELLUNGEN ---
#define LED_PIN     14    // Waveshare S3 Matrix intern
#define NUM_LEDS    64
#define BUTTON_PIN  0     // BOOT-Button
#define BRIGHT_MIN  4   
#define BRIGHT_MAX  130   // Etwas reduziert wegen Hitzeentwicklung S3
// Feste Helligkeit für ferngesteuerte Effekte (Virus, Regenbogen, Welle, Ambient, Strobe …):
// unabhängig von der Nähe, damit ein Effekt auf allen Badges gleich hell ist. Bewusst unter
// BRIGHT_MAX: Effekte laufen endlos, Dauer-Weiß auf allen Herz-Pixeln wird sonst zu heiß.
#define FX_BRIGHT   64
// Glättung der Nähe pro Frame (50 Hz): 0.08 ≈ 250 ms Zeitkonstante
#define NEAR_SMOOTH 0.08f
// Glättung des Signals je Peer pro Paket (20 Hz): fängt das RSSI-Rauschen einzelner Pakete ab
#define PEER_RSSI_SMOOTH 0.2f

// --- BEWEGUNGSSENSOR (QMI8658, I²C) ---
#define IMU_SDA_PIN   11
#define IMU_SCL_PIN   12
#define IMU_ADDR      0x6B   // SA0 auf GND
#define IMU_READ_INTERVAL_MS 40   // 25 Hz reichen für Lage und Schütteln (~1 ms I²C je Lesung)
// Schütteln: so viele Messungen mit |a| mehr als IMU_SHAKE_G von 1 g entfernt, innerhalb des
// Fensters → das Herz „flattert“ (weiße Funken, nur lokal, nur ohne ferngesteuerten Effekt).
#define IMU_SHAKE_G          1.2f
#define IMU_SHAKE_HITS       3
#define IMU_SHAKE_WINDOW_MS  600
#define IMU_FLUTTER_MS       1500
// Herz immer aufrecht: dreht das Herz in 90°-Schritten nach der Schwerkraft. Standard AUS,
// weil die Lage des Sensors zur LED-Matrix erst einmal am Gerät bestimmt werden muss
// (README: „Bewegungssensor“). Danach IMU_ROTATION_OFFSET/IMU_MIRROR setzen und einschalten.
#ifndef IMU_AUTO_ROTATE
#define IMU_AUTO_ROTATE      0
#endif
#ifndef IMU_ROTATION_OFFSET
#define IMU_ROTATION_OFFSET  0    // 0…3: Drehung, die in der Trage-Lage „aufrecht“ ergibt
#endif
#ifndef IMU_MIRROR
#define IMU_MIRROR           0    // 1, wenn sich das Herz beim Drehen in die falsche Richtung dreht
#endif
#define IMU_UPRIGHT_MIN_G    0.6f // so viel Schwerkraft muss in der Matrix-Ebene liegen (sonst liegt das Badge flach)
#define IMU_ROT_HOLD_MS      400  // neue Lage muss so lange anliegen
// Abdunkeln in Ruhe: nach so vielen ms ohne Bewegung leuchtet das normale Herz nur noch mit
// BRIGHT_MIN. 0 = aus (Standard: Badges können auch als ruhende Installation ausliegen).
#ifndef IMU_REST_DIM_MS
#define IMU_REST_DIM_MS      0
#endif
#define IMU_MOTION_G         0.08f

// --- CCC & SYNC SETTINGS ---
#define CCC_CHANNEL 13          
#define MAGIC_ID    0x421337CC  
#define PEER_TIMEOUT 4000       // Nach 4 Sek. wird ein verschwundenes Badge gelöscht
#define MAX_PEERS   25
#define SYNC_TX_INTERVAL_MS 50  // 20 Hz Sync-Broadcast (Frame-Rate bleibt 50 Hz)

// Schwarm-Takt: heartBeatState ist ein gemeinsamer Phasen-Zähler, 1 Puls = 65536.
// Empfangene Werte, die vorne liegen, werden übernommen (Max-Regel) → alle Badges
// folgen dem schnellsten. Kleine Abstände weich aufholen, große direkt springen.
#define BEAT_UNITS_PER_PULSE 65536UL
#define BEAT_JUMP_THRESHOLD  (4 * BEAT_UNITS_PER_PULSE)

// Remote-Effekte (Basisstation / kompatibles Paket): mode im SyncPacket.
// Die visuellen Effekte (1–4, 6–8) laufen endlos, bis Modus 12 („Alle stoppen“) oder ein anderer
// visueller Effekt kommt (letzter gewinnt). Nur Beat (150-ms-Puls) und Identify (10 s) laufen aus.
#define SYNC_MODE_VIRUS    1  // weißer Blitz (wie Morse -.-.) — Zyklus 3 s
#define SYNC_MODE_RAINBOW  2  // Singularity-Regenbogen
#define SYNC_MODE_PRIME    3  // Primzahl-Puls + Sparkles
#define SYNC_MODE_WAVE     4  // Welle: ripple von Basisstation nach RSSI-Distanz
#define SYNC_MODE_BEAT     5  // Beat-Sync Puls (manuell oder BPM)
#define SYNC_MODE_ZONE     6  // RSSI-Zonen-Farben
#define SYNC_MODE_AMBIENT  7  // Feste Farbe (alle LEDs)
#define SYNC_MODE_STROBE   8  // Strobe-Blitz
#define SYNC_MODE_IDENTIFY 9  // "Badge finden": nur das Badge mit der Ziel-MAC blinkt grün
#define SYNC_MODE_WAVE_STOP 10 // Welle manuell stoppen (Welle läuft sonst endlos im 4-s-Zyklus)
#define SYNC_MODE_TAP      11 // Tap-Counter: virusID = Zählerstand (monoton, 32 Bit); weitergeleitet + 6 Byte Ursprungs-MAC
#define SYNC_MODE_STOP_ALL 12 // „Alle stoppen“: räumt alle Effekte außer Identify ab; virusID = Kennung des Stopps (jeder Stopp wirkt je Badge genau einmal; 0 = alte Sender ohne Kennung); begrenzt weitergeleitet
// IDs 1..MORSE_VIRUS_ID_MAX sind dem Morse-Virus der Badges vorbehalten: ein solcher Virus
// endet nach 3 s von selbst (am Badge gibt es keine Stopp-Geste). Stationen vergeben größere
// IDs, deren Effekte laufen endlos bis zum Stopp.
#define MORSE_VIRUS_ID_MAX 99999UL
#define ALL_STOP_SEEN_SLOTS 4  // zuletzt verarbeitete Stopp-Kennungen (Ringpuffer)
// Funk-Update: SyncPacket + Zielversion, Server-IP/Port, Größe, MD5 und HMAC-Tag (54 Byte,
// siehe OtaTrigger). Nur mit ota_secret.h wirksam; ältere Firmware ignoriert den Modus.
#define SYNC_MODE_OTA      13
#define OTA_TAG_LEN        8       // gekürzter HMAC-SHA256 über alles davor
#define OTA_FWD_COUNT      3       // Auslöser begrenzt weiterleiten (wie Stopp) …
#define OTA_FWD_GAP_MS     60
#define OTA_SEEN_SLOTS     4       // zuletzt gesehene Auslöser-Kennungen (Ringpuffer)
#define OTA_MIN_DELAY_MS   500     // erst weiterleiten, dann ins WLAN …
#define OTA_JITTER_MS      6000    // … zufällig verteilt, damit nicht alle Badges gleichzeitig laden
#define OTA_WIFI_TIMEOUT_MS  20000 // so lange auf das WLAN warten
#define OTA_STALL_TIMEOUT_MS 10000 // so lange darf der Download stocken
#define REMOTE_RAINBOW_MS  15000
#define REMOTE_PRIME_MS    12000
#define WAVE_DURATION_MS   4000    // Länge eines Wellenzyklus; die Welle wiederholt ihn endlos bis zum Stopp
#define WAVE_STOP_FWD_COUNT  3     // Stopp-Paket wird max. so oft weitergeleitet …
#define WAVE_STOP_FWD_GAP_MS 60    // … im Abstand von ~60 ms (nicht blockierend, aus loop())
#define WAVE_STOP_LOCK_MS    1000  // danach keine erneute Weiterleitung (kein Echo-Sturm)
#define ALL_STOP_FWD_COUNT   3     // „Alle stoppen“ (Modus 12): gleiches Muster wie der Wellen-Stopp …
#define ALL_STOP_FWD_GAP_MS  60
#define ALL_STOP_LOCK_MS     1000
// Tap-Counter: kurzer BOOT-Tastendruck (<= 250 ms, wie Morse-Punkt) zählt als Tap
#define TAP_SEND_COUNT     3       // je Tap so viele Pakete …
#define TAP_SEND_GAP_MS    60      // … im Abstand von ~60 ms (nicht blockierend, aus loop())
#define TAP_RESEND_MS      1200    // einmal Nachsendung nach dem letzten Burst (jenseits der Weiterleitungs-Sperre)
#define TAP_BOOT_DELAY_MS  500     // Stand nach dem Boot einmal melden (Funk ist dann bereit)
#define TAP_FWD_COUNT      3       // fremde Tap-Pakete: max. so oft weiterleiten …
#define TAP_FWD_GAP_MS     60      // … im Abstand von ~60 ms
#define TAP_FWD_LOCK_MS    1000    // danach keine neue Weiterleitung (kein Echo-Sturm)
#define TAP_SEEN_SLOTS     8       // Dedup-Tabelle: höchster Stand je Absender-MAC, ältester Eintrag fliegt raus
#define TAP_SAVE_INTERVAL_MS 30000 // Zählerstand höchstens alle 30 s in den Flash (Verschleiß)
#define TAP_NVS_NAMESPACE  "hstap"
#define TAP_NVS_KEY        "cnt"
#define WAVE_PULSE_MS      700
#define WAVE_MAX_DELAY_MS  (WAVE_DURATION_MS - WAVE_PULSE_MS)  // spätester Pulsbeginn nach Wellenstart
#define WAVE_STATION_SPAN_MS 2000  // direkt von der Basis: -45 dBm → 0 ms … -95 dBm → 2000 ms
#define WAVE_HOP_MIN_MS    150     // über ein Badge weitergeleitet: Sender-Verzögerung + 150 …
#define WAVE_HOP_SPAN_MS   600     // … + 600 ms je nach Signal zum Sender
#define BEAT_PULSE_MS      150
#define REMOTE_ZONE_MS     5000
#define REMOTE_AMBIENT_MS  30000
#define STROBE_DURATION_MS 2000
#define STROBE_FLASH_MS    80
#define IDENTIFY_MS        10000
#define IDENTIFY_BLINK_MS  125

// Zone colors (compile-time, per badge firmware)
#define ZONE0_COLOR  CRGB(255, 50, 50)   // Nah (RSSI > -55): rot
#define ZONE1_COLOR  CRGB(255, 200, 0)   // Mitte (RSSI > -75): gelb
#define ZONE2_COLOR  CRGB(50, 100, 255)  // Fern  (RSSI <= -75): blau

// --- DATENSTRUKTUR ---
// Alte Firmware: 13 Byte (magic…mode). Neu: +4 Byte Firmware-Stände, packed ohne Padding.
// SyncPacket enthaelt A.B.C (ver_rel=PATCH) + ver_dbg (Debug-Build-Zaehler 1..99 oder 0=Release).
// D (Git-Build-Nummer) wird NICHT per Funk gesendet, nur in Git-Tags gefuehrt (Platz + Kabel-Last).
// ver_rel = PATCH bei Release (ver_dbg==0); ver_dbg 1…99 = Debug-Build (+debug), 0 = Release-Binary.
#define SYNC_PACKET_LEGACY_LEN 13
// Identify-Pakete hängen 6 Byte Ziel-MAC an das SyncPacket an (17 + 6 = 23 Byte).
// Ältere Firmware liest nur sizeof(SyncPacket) und kennt Modus 9 nicht → ignoriert.
#define IDENTIFY_PACKET_LEN (sizeof(SyncPacket) + 6)
// Wellen-Pakete von Badges (ab 1.4.0) hängen 2× uint16 an: Phase im Wellenzyklus
// (ms seit Wellenstart modulo WAVE_DURATION_MS, also 0..3999) und die eigene Puls-Verzögerung.
// Damit rechnet der Empfänger auf den gemeinsamen Start zurück, statt beim Empfang neu zu
// beginnen. Ältere Firmware liest nur 17 Byte.
#define WAVE_PACKET_LEN (sizeof(SyncPacket) + 4)
// Tap-Pakete: direkt vom Badge = SyncPacket (17 Byte, MAC = Absender). Von einem Nachbarn
// weitergeleitet: + 6 Byte MAC des ursprünglichen Badges (23 Byte). Ältere Firmware kennt
// Modus 11 nicht und ignoriert beide Längen.
#define TAP_FWD_PACKET_LEN (sizeof(SyncPacket) + 6)

struct __attribute__((packed)) SyncPacket {
    uint32_t magic_id;
    uint32_t beatCounter;
    uint32_t virusID;
    uint8_t  mode;
    uint8_t  ver_major;
    uint8_t  ver_minor;
    uint8_t  ver_rel;
    uint8_t  ver_dbg;
};

// --- MASKE (Oben definiert für den Compiler) ---
const uint8_t heartMask[8][8] = {
  {0,0,0,0,0,0,0,0}, {0,1,1,0,0,1,1,0}, {1,1,1,1,1,1,1,1}, {1,1,1,1,1,1,1,1},
  {1,1,1,1,1,1,1,1}, {0,1,1,1,1,1,1,0}, {0,0,1,1,1,1,0,0}, {0,0,0,1,1,0,0,0}
};

SyncPacket txData;
CRGB leds[NUM_LEDS];

// --- PEER TRACKING ---
struct PeerTracker {
    uint8_t mac[6];
    uint32_t lastSeen;
    uint8_t ver_major;
    uint8_t ver_minor;
    uint8_t ver_rel;
    uint8_t ver_dbg;
    uint8_t ver_known;  // 1 = mindestens ein Paket mit Versionsfeldern empfangen
    float   rssi;       // geglättetes Signal dieses Badges (dBm) — das stärkste bestimmt die Nähe
};
PeerTracker seenPeers[MAX_PEERS];
uint8_t uniquePeerCount = 0;

// --- VARIABLEN ---
// stateMux schützt alles, was OnDataRecv (WiFi-Task, Core 0) schreibt und loop()
// (Core 1) liest: seenPeers, smoothRSSI, heartBeatState/beatCatchup, fx[], wave*,
// ambient*. loop() kopiert einmal pro Frame unter der Sperre und rendert ohne.
static portMUX_TYPE stateMux = portMUX_INITIALIZER_UNLOCKED;
float smoothRSSI = -95;
uint32_t heartBeatState = 0;     // Schwarm-Phase (siehe BEAT_UNITS_PER_PULSE)
uint32_t beatCatchup = 0;        // noch aufzuholender Vorsprung des schnellsten Peers
static uint32_t frameBeat = 0;   // Snapshot von heartBeatState für den aktuellen Frame
uint8_t broadcastMac[] = {0xFF, 0xFF, 0xFF, 0xFF, 0xFF, 0xFF};
static uint8_t ownMac[6] = {0};  // eigene STA-MAC, Ziel-Vergleich für SYNC_MODE_IDENTIFY

// Effect-State-Struct: ersetzt 8× copy-paste Variablen
struct EffectState {
    uint32_t id;
    uint32_t startTime;
    bool active;
};
enum EffectIdx : uint8_t { E_VIRUS=0, E_RAINBOW, E_PRIME, E_WAVE, E_BEAT, E_ZONE, E_AMBIENT, E_STROBE, E_IDENTIFY, E_COUNT };
EffectState fx[E_COUNT] = {};
// Nominale Effektdauer / Zykluslänge. Ablaufen (active=false nach Ablauf) tun nur Beat und Identify;
// alle anderen Effekte laufen endlos (Render-Fenster modulo bzw. statisch, siehe loop()).
static const uint32_t fxDurationMs[E_COUNT] = {
    3000, REMOTE_RAINBOW_MS, REMOTE_PRIME_MS, WAVE_DURATION_MS,
    BEAT_PULSE_MS, REMOTE_ZONE_MS, REMOTE_AMBIENT_MS, STROBE_DURATION_MS, IDENTIFY_MS
};

// Visuelle Effekt-Slots: ein Start löscht die anderen (letzter gewinnt). E_BEAT und E_IDENTIFY
// gehören nicht dazu. Aufruf unter stateMux.
static void clearOtherVisualFx(uint8_t keep) {
    static const uint8_t visual[] = { E_VIRUS, E_RAINBOW, E_PRIME, E_WAVE, E_ZONE, E_AMBIENT, E_STROBE };
    for (uint8_t i = 0; i < sizeof(visual); i++) {
        if (visual[i] != keep) fx[visual[i]].active = false;
    }
}

// Wave-spezifisch: fx[E_WAVE].startTime = Wellenstart an der Basis (lokale Zeit),
// waveDelay = eigener Pulsbeginn danach (kürzester bekannter Weg, siehe OnDataRecv)
uint32_t waveDelay = 0;
// Die Welle läuft endlos: loop() setzt startTime pro Zyklus um WAVE_DURATION_MS vor.
// Gestoppte Wellen-ID: weitergeleitete Wellenpakete mit dieser ID werden ignoriert.
// Eine Welle mit anderer ID startet normal (die alte ID bleibt gesperrt, damit verspätete
// Pakete der alten Welle sie nicht wiederbeleben).
uint32_t waveStopId = 0;
// Stopp-Weiterleitung (begrenztes Flooding): OnDataRecv setzt nur den Zustand,
// loop() sendet. Alles unter stateMux.
static uint8_t  stopFwdLeft = 0;       // noch zu sendende Stopp-Pakete
static uint32_t stopFwdNext = 0;       // Zeitpunkt der nächsten Sendung
static uint32_t stopFwdId = 0;         // Ziel-Wellen-ID des weiterzuleitenden Stopps (unverändert aus dem Paket)
static uint32_t stopLastSent = 0;      // Zeitpunkt der letzten Sendung (Beginn der Sperre)
static bool     stopLockActive = false;
// „Alle stoppen“ (Modus 12): gleiches Weiterleitungs-Muster. Jeder Stopp trägt eine Kennung und
// wird je Badge genau einmal verarbeitet (allStopSeen) — verspätete Echos desselben Stopps
// schalten so keinen Effekt mehr ab, der danach gestartet wurde. Kennung 0 (alte Sender):
// wie früher, jedes Paket räumt ab, Dedup der Weiterleitung nur über die Sperre.
static uint32_t allStopSeen[ALL_STOP_SEEN_SLOTS] = {0};
static uint8_t  allStopSeenPos = 0;
static uint32_t allStopFwdId = 0;      // Kennung des weiterzuleitenden Stopps (unverändert aus dem Paket)
static uint8_t  allStopFwdLeft = 0;
static uint32_t allStopFwdNext = 0;
static uint32_t allStopLastSent = 0;
static bool     allStopLockActive = false;

// Tap-Counter, empfangene Stände (OnDataRecv schreibt, loop() liest) — alles unter stateMux
struct TapSeen {
    uint8_t  mac[6];
    uint32_t count;     // höchster gesehener Stand dieser MAC
    uint32_t stamp;     // millis() der letzten Aktualisierung (ältester Eintrag wird ersetzt)
    bool     used;
};
static TapSeen  tapSeen[TAP_SEEN_SLOTS];
static uint8_t  tapFwdLeft = 0;        // noch zu sendende Weiterleitungen
static uint32_t tapFwdNext = 0;
static uint8_t  tapFwdMac[6];          // Ursprungs-MAC des weiterzuleitenden Pakets
static uint32_t tapFwdCount = 0;
static uint32_t tapFwdLastSent = 0;
static bool     tapFwdLockActive = false;
// Eigener Tap-Zähler: nur loop() (Core 1) liest/schreibt → kein Mutex nötig
static uint32_t tapCount = 0;
static bool     tapDirty = false;      // seit dem letzten Speichern geändert
static uint32_t tapLastSave = 0;
static uint8_t  tapBurstLeft = 0;      // noch zu sendende Pakete des eigenen Stands
static uint32_t tapBurstNext = 0;
static bool     tapResendPending = false;
static uint32_t tapResendAt = 0;

// Ambient-spezifisch
uint8_t ambientR = 0, ambientG = 0, ambientB = 0;

// Morse: char-Array statt String (kein Heap)
char morseBuf[12] = {0};
uint8_t morseLen = 0;
uint32_t btnDownTime = 0;
uint32_t lastBtnRelease = 0;

// Primzahl-LUT für 1..26 (MAX_PEERS+1)
static const bool primeLUT[27] = {
    0,0,1,1,0,1,0,1,0,0,  // 0..9
    0,1,0,1,0,0,0,1,0,1,  // 10..19
    0,0,0,1,0,0,0         // 20..26
};

// Herz-Maske als 64-Bit Bitmaske (1 = Herz-Pixel)
static uint64_t heartMask64;

CRGB heartColor = CRGB(255, 0, 150); // Cyber-Pink

#if ENABLE_SERIAL_DEBUG
static void printFwVersionBanner() {
    Serial.printf("Herz-Schwarm FW %u.%u.%02u+debug (RSSI/Morse/Peers siehe Log)\n",
                  FW_VERSION_MAJOR, FW_VERSION_MINOR, FW_DEBUG_BUILD);
}
#endif

static void sendSync(uint8_t mode, uint32_t fxId) {
    txData.magic_id = MAGIC_ID;
    uint16_t waveInfo[2] = {0, 0};
    // Ambient: beatCounter trägt die Farbe (0xRRGGBB), sonst den Schwarm-Takt
    portENTER_CRITICAL(&stateMux);
    txData.beatCounter = (mode == SYNC_MODE_AMBIENT)
        ? ((uint32_t)ambientR << 16) | ((uint32_t)ambientG << 8) | ambientB
        : heartBeatState;
    if (mode == SYNC_MODE_WAVE) {
        // Phase im Zyklus (< 4000): kein uint16-Überlauf bei endloser Welle
        waveInfo[0] = (uint16_t)((millis() - fx[E_WAVE].startTime) % WAVE_DURATION_MS);
        waveInfo[1] = (uint16_t)waveDelay;
    }
    portEXIT_CRITICAL(&stateMux);
    txData.virusID = fxId;
    txData.mode = mode;
    txData.ver_major = FW_VERSION_MAJOR;
    txData.ver_minor = FW_VERSION_MINOR;
    txData.ver_rel = FW_VERSION_PATCH;
#if ENABLE_SERIAL_DEBUG
    txData.ver_dbg = FW_DEBUG_BUILD;
#else
    txData.ver_dbg = 0;
#endif
    // Fehler ignorieren — nächster Sendezyklus sendet wieder
    if (mode == SYNC_MODE_WAVE) {
        uint8_t buf[WAVE_PACKET_LEN];
        memcpy(buf, &txData, sizeof(txData));
        memcpy(buf + sizeof(txData), waveInfo, sizeof(waveInfo));
        esp_now_send(broadcastMac, buf, sizeof(buf));
    } else {
        esp_now_send(broadcastMac, (uint8_t *)&txData, sizeof(txData));
    }
}

// Tap-Paket senden (nur aus loop()). origin == nullptr: eigener Stand, 17 Byte (unverändertes
// SyncPacket). Sonst Weiterleitung: gleiches Paket + 6 Byte Ursprungs-MAC. Nimmt stateMux nicht.
static void sendTap(const uint8_t *origin, uint32_t count) {
    SyncPacket p;
    memset(&p, 0, sizeof(p));
    p.magic_id = MAGIC_ID;
    p.beatCounter = millis();
    p.virusID = count;
    p.mode = SYNC_MODE_TAP;
    p.ver_major = FW_VERSION_MAJOR;
    p.ver_minor = FW_VERSION_MINOR;
    p.ver_rel = FW_VERSION_PATCH;
#if ENABLE_SERIAL_DEBUG
    p.ver_dbg = FW_DEBUG_BUILD;
#endif
    uint8_t buf[TAP_FWD_PACKET_LEN];
    memcpy(buf, &p, sizeof(p));
    size_t n = sizeof(p);
    if (origin) {
        memcpy(buf + n, origin, 6);
        n += 6;
    }
    esp_now_send(broadcastMac, buf, n);  // Fehler ignorieren — Zählerstand ist kumulativ
}

// Fremdes Tap-Paket aufnehmen. Aufruf unter stateMux. Nur ein höherer Stand als der zur MAC
// bekannte wird übernommen und (begrenzt) weitergeleitet; gesendet wird in loop().
// Ist die Weiterleitung gerade belegt/gesperrt, bleibt die Tabelle unverändert: ein späteres
// Paket (Nachsendung, nächster Tap — der Zähler ist kumulativ) wird dann noch weitergeleitet.
static void tapOnReceive(const uint8_t *origin, uint32_t count, uint32_t now) {
    int slot = -1, oldest = 0;
    for (int i = 0; i < TAP_SEEN_SLOTS; i++) {
        if (!tapSeen[i].used) {
            if (slot < 0 || tapSeen[slot].used) slot = i;   // freier Slot hat Vorrang
        } else if (memcmp(tapSeen[i].mac, origin, 6) == 0) {
            slot = i;
            break;
        } else if (tapSeen[i].stamp - tapSeen[oldest].stamp > 0x80000000UL) {
            oldest = i;  // i ist älter als oldest (vorzeichenrichtig verglichen)
        }
    }
    const bool known = (slot >= 0 && tapSeen[slot].used && memcmp(tapSeen[slot].mac, origin, 6) == 0);
    if (known && count <= tapSeen[slot].count) return;  // nichts Neues (Wiederholung/Echo)
    if (slot < 0) slot = oldest;                         // Tabelle voll: ältesten Eintrag ersetzen

    if (tapFwdLeft > 0 && memcmp(tapFwdMac, origin, 6) == 0) {
        tapFwdCount = count;  // gleiche MAC noch in Weiterleitung: neuesten Stand mitnehmen
    } else if (tapFwdLeft == 0 && !(tapFwdLockActive && now - tapFwdLastSent < TAP_FWD_LOCK_MS)) {
        memcpy(tapFwdMac, origin, 6);
        tapFwdCount = count;
        tapFwdLeft = TAP_FWD_COUNT;
        tapFwdNext = now;
    } else {
        return;  // belegt oder gesperrt: Tabelle nicht ändern, später erneut versuchen
    }
    memcpy(tapSeen[slot].mac, origin, 6);
    tapSeen[slot].count = count;
    tapSeen[slot].stamp = now;
    tapSeen[slot].used = true;
}

// Zählerstand sichern: Fehler dürfen den Betrieb nicht stören (dann wird übersprungen).
static void tapSave() {
    Preferences prefs;
    if (prefs.begin(TAP_NVS_NAMESPACE, false)) {
        prefs.putUInt(TAP_NVS_KEY, tapCount);
        prefs.end();
    }
}

// ===================== FUNK-UPDATE (OTA über WLAN, Modus 13) =====================
// Ablauf: Die Station sendet einen signierten Auslöser (Zielversion, Server, Größe, MD5).
// Ein Badge mit gültigem Tag leitet ihn begrenzt weiter. Ist die Zielversion neuer als die
// eigene, verlässt es nach einer zufälligen Wartezeit den Schwarm-Funk, meldet sich am WLAN
// aus ota_secret.h an, lädt http://<ip>:<port>/firmware/badge.bin, prüft Größe und MD5 und
// startet neu. Jeder Ausgang (Erfolg wie Fehler) endet mit einem Neustart — das stellt den
// Funk-Zustand am sichersten wieder her. Ein fehlgeschlagener Auslöser wird über den Neustart
// hinweg gemerkt und nicht erneut versucht (erst ein neuer Auslöser mit neuer Kennung).
// Schutz: Der Tag ist ein HMAC mit OTA_KEY — ohne Schlüssel lässt sich kein Update auslösen.
// Nur neuere Versionen werden angenommen, ein mitgeschnittener alter Auslöser bewirkt nichts.
#if OTA_ENABLED
struct __attribute__((packed)) OtaTrigger {
    SyncPacket hdr;        // mode = SYNC_MODE_OTA, virusID = Kennung des Auslösers
    uint8_t  ver[3];       // Zielversion MAJOR, MINOR, PATCH
    uint8_t  ip[4];        // Server (IPv4)
    uint16_t port;
    uint32_t size;         // Größe der .bin in Byte
    uint8_t  md5[16];      // MD5 der .bin
    uint8_t  tag[OTA_TAG_LEN];
};
static_assert(sizeof(OtaTrigger) == 54, "OtaTrigger muss 54 Byte lang sein (App und Bridge bauen dasselbe Paket)");
#define OTA_SIGNED_LEN (sizeof(OtaTrigger) - OTA_TAG_LEN)

// OnDataRecv legt einen Auslöser nur ab; geprüft (HMAC) und ausgeführt wird in loop().
static uint8_t  otaRxBuf[sizeof(OtaTrigger)];  // unter stateMux
static bool     otaRxPending = false;          // unter stateMux
static uint32_t otaSeen[OTA_SEEN_SLOTS] = {0}; // unter stateMux
static uint8_t  otaSeenPos = 0;                // unter stateMux
// Ab hier nur loop():
static bool     otaWaiting = false;            // Update angenommen, wartet auf den Start
static OtaTrigger otaJob;
static uint8_t  otaFwdBuf[sizeof(OtaTrigger)];
static uint8_t  otaFwdLeft = 0;
static uint32_t otaFwdNext = 0;
static uint32_t otaStartAt = 0;
// Überlebt den Software-Neustart (nicht das Aus- und Einschalten): Kennung des Auslösers,
// dessen Update fehlgeschlagen ist.
RTC_NOINIT_ATTR static uint32_t otaFailedId;

static bool otaTagOk(const uint8_t *pkt) {
    uint8_t mac[32];
    const mbedtls_md_info_t *info = mbedtls_md_info_from_type(MBEDTLS_MD_SHA256);
    if (info == nullptr) return false;
    if (mbedtls_md_hmac(info, (const uint8_t *)OTA_KEY, strlen(OTA_KEY), pkt, OTA_SIGNED_LEN, mac) != 0) {
        return false;
    }
    uint8_t diff = 0;  // ohne vorzeitigen Abbruch vergleichen
    for (int i = 0; i < OTA_TAG_LEN; i++) diff |= mac[i] ^ pkt[OTA_SIGNED_LEN + i];
    return diff == 0;
}

// Herz von unten nach oben füllen (percent 0…100) — Fortschritt und Ergebnis des Updates.
static void otaShow(uint8_t r, uint8_t g, uint8_t b, uint8_t percent) {
    uint8_t total = 0;
    for (int i = 0; i < NUM_LEDS; i++) total += (heartMask64 >> i) & 1;
    uint8_t lit = (uint8_t)(((uint16_t)total * percent) / 100);
    if (percent > 0 && lit == 0) lit = 1;
    FastLED.clear();
    for (int i = NUM_LEDS - 1; i >= 0 && lit > 0; i--) {
        if ((heartMask64 >> i) & 1) {
            leds[i] = CRGB(r, g, b);
            lit--;
        }
    }
    FastLED.setBrightness(FX_BRIGHT);
    FastLED.show();
}

// Ende des Updates: grün = ok, rot = fehlgeschlagen; danach immer Neustart (kehrt nie zurück).
static void otaEnd(bool ok, uint32_t id) {
    if (!ok) {
        Update.abort();
        otaFailedId = id;
    }
#if ENABLE_SERIAL_DEBUG
    Serial.printf("[OTA] %s, Neustart\n", ok ? "ok" : "fehlgeschlagen");
#endif
    if (ok) otaShow(0, 255, 0, 100); else otaShow(255, 0, 0, 100);
    delay(ok ? 800 : 1500);
    ESP.restart();
    for (;;) delay(1000);
}

// Blockierend, kehrt nie zurück: WLAN, Download, Flash, Neustart.
static void otaRun() {
    const uint32_t id = otaJob.hdr.virusID;
    const uint32_t size = otaJob.size;

    esp_now_unregister_recv_cb();
    esp_now_deinit();
    WiFi.persistent(false);  // WLAN-Zugang nicht im Flash ablegen
    WiFi.begin(OTA_WIFI_SSID, OTA_WIFI_PASS);
    const uint32_t t0 = millis();
    while (WiFi.status() != WL_CONNECTED) {
        if (millis() - t0 > OTA_WIFI_TIMEOUT_MS) otaEnd(false, id);
        otaShow(0, 0, 255, ((millis() / 250) % 2) ? 100 : 0);  // blau blinken: suche WLAN
        delay(50);
    }

    char url[64];
    snprintf(url, sizeof(url), "http://%u.%u.%u.%u:%u/firmware/badge.bin",
             otaJob.ip[0], otaJob.ip[1], otaJob.ip[2], otaJob.ip[3], (unsigned)otaJob.port);
    char md5hex[33];
    for (int i = 0; i < 16; i++) snprintf(md5hex + 2 * i, 3, "%02x", otaJob.md5[i]);
#if ENABLE_SERIAL_DEBUG
    Serial.printf("[OTA] lade %s (%lu Byte)\n", url, (unsigned long)size);
#endif

    NetworkClient client;
    HTTPClient http;
    http.setConnectTimeout(5000);
    http.setTimeout(8000);
    if (!http.begin(client, url)) otaEnd(false, id);
    const int code = http.GET();
    if (code != HTTP_CODE_OK || http.getSize() != (int)size) {
        http.end();
        otaEnd(false, id);
    }
    if (!Update.begin(size, U_FLASH) || !Update.setMD5(md5hex)) {
        http.end();
        otaEnd(false, id);
    }

    NetworkClient *stream = http.getStreamPtr();
    static uint8_t buf[1024];
    uint32_t written = 0, lastData = millis();
    uint8_t shownPct = 255;
    while (written < size) {
        const int avail = stream->available();
        if (avail > 0) {
            size_t want = (size_t)avail < sizeof(buf) ? (size_t)avail : sizeof(buf);
            if (want > size - written) want = size - written;
            const int n = stream->read(buf, want);
            if (n <= 0) continue;
            if (Update.write(buf, (size_t)n) != (size_t)n) {
                http.end();
                otaEnd(false, id);
            }
            written += (uint32_t)n;
            lastData = millis();
            const uint8_t pct = (uint8_t)((written * 100UL) / size);
            if (pct / 4 != shownPct / 4) {  // nur alle 4 % neu zeichnen
                shownPct = pct;
                otaShow(0, 0, 255, pct);
            }
        } else {
            if (!stream->connected() || millis() - lastData > OTA_STALL_TIMEOUT_MS) {
                http.end();
                otaEnd(false, id);
            }
            delay(2);
        }
    }
    http.end();
    otaEnd(Update.end(), id);  // end() prüft Größe und MD5 und schaltet den Boot-Slot um
}

// Einmal pro Frame aus loop(): abgelegten Auslöser prüfen, weiterleiten, ggf. Update starten.
static void otaPoll(uint32_t now) {
    uint8_t pkt[sizeof(OtaTrigger)];
    bool have = false;
    portENTER_CRITICAL(&stateMux);
    if (otaRxPending) {
        memcpy(pkt, otaRxBuf, sizeof(pkt));
        otaRxPending = false;
        have = true;
    }
    portEXIT_CRITICAL(&stateMux);

    if (have && otaTagOk(pkt)) {
        OtaTrigger t;
        memcpy(&t, pkt, sizeof(t));
        // Echter Auslöser: Kennung merken (jede nur einmal) und begrenzt weiterleiten —
        // auch wenn dieses Badge schon aktuell ist, damit er Badges dahinter erreicht.
        portENTER_CRITICAL(&stateMux);
        otaSeen[otaSeenPos] = t.hdr.virusID;
        otaSeenPos = (otaSeenPos + 1) % OTA_SEEN_SLOTS;
        portEXIT_CRITICAL(&stateMux);
        memcpy(otaFwdBuf, pkt, sizeof(otaFwdBuf));
        otaFwdLeft = OTA_FWD_COUNT;
        otaFwdNext = now;

        const bool newer =
            t.ver[0] != FW_VERSION_MAJOR ? t.ver[0] > FW_VERSION_MAJOR
            : t.ver[1] != FW_VERSION_MINOR ? t.ver[1] > FW_VERSION_MINOR
            : t.ver[2] > FW_VERSION_PATCH;
        if (!otaWaiting && newer && t.size > 0 && t.hdr.virusID != otaFailedId) {
            otaJob = t;
            otaWaiting = true;
            otaStartAt = now + OTA_MIN_DELAY_MS + (esp_random() % OTA_JITTER_MS);
#if ENABLE_SERIAL_DEBUG
            Serial.printf("[OTA] Update auf %u.%u.%u angenommen\n", t.ver[0], t.ver[1], t.ver[2]);
#endif
        }
    }

    if (otaFwdLeft > 0) {
        if ((int32_t)(now - otaFwdNext) >= 0) {
            esp_now_send(broadcastMac, otaFwdBuf, sizeof(otaFwdBuf));
            otaFwdLeft--;
            otaFwdNext = now + OTA_FWD_GAP_MS;
        }
    } else if (otaWaiting && (int32_t)(now - otaStartAt) >= 0) {
        otaRun();
    }
}
#endif  // OTA_ENABLED

// Pulsbeginn nach Wellenstart: direkt von der Basis nach deren Signal, sonst Verzögerung
// des weiterleitenden Badges plus ein Aufschlag nach dem Signal zu ihm. So läuft die
// Welle auch zu Badges, die die Basis gar nicht hören, in Hop-Schritten weiter.
static uint32_t waveDelayFor(float rssi, bool fromStation, uint32_t senderDelay) {
    float norm = (constrain(rssi, -95.0f, -45.0f) + 95.0f) / 50.0f;  // 0 = schwach, 1 = stark
    uint32_t d = fromStation
        ? (uint32_t)((1.0f - norm) * WAVE_STATION_SPAN_MS)
        : senderDelay + WAVE_HOP_MIN_MS + (uint32_t)((1.0f - norm) * WAVE_HOP_SPAN_MS);
    return d > WAVE_MAX_DELAY_MS ? WAVE_MAX_DELAY_MS : d;
}

// Puls-Helligkeit aus der gemeinsamen Schwarm-Phase (statt beatsin8, das mit dem
// lokalen millis() rechnet und daher nie zwischen Badges synchron ist).
static inline uint8_t swarmPulse(uint8_t lowest, uint8_t highest) {
    return lowest + scale8(sin8((uint8_t)(frameBeat >> 8)), highest - lowest);
}

// Regenbogen-Farbton aus derselben Schwarm-Phase: eine Farbrunde je zwei Pulse. So zeigen
// alle Badges denselben Farbton (ein lokaler Zähler pro Frame liefe auseinander).
static inline uint8_t swarmHue() {
    return (uint8_t)(frameBeat >> 9);
}

// --- HELPER: PRIMZAHL (LUT, O(1)) ---
static inline bool isPrimeFast(uint8_t n) {
    return (n < 27) ? primeLUT[n] : false;
}

// --- PEER TRACKING: lineare Suche ---
// Bei MAX_PEERS=25 schneller als jeder Hash und ohne Verwaltungs-Zustand,
// der beim Wiederbelegen freier Slots inkonsistent werden kann. Aufruf unter stateMux.
static void trackBadge(const uint8_t* mac, float rssi, bool hasVer, uint8_t vmaj, uint8_t vmin,
                       uint8_t vrel, uint8_t vdbg) {
    uint32_t now = millis();
    int slot = -1;
    for (int i = 0; i < MAX_PEERS; i++) {
        if (seenPeers[i].lastSeen == 0) {
            if (slot < 0) slot = i;  // erster freier Slot als Fallback
        } else if (memcmp(seenPeers[i].mac, mac, 6) == 0) {
            slot = i;
            break;
        }
    }
    if (slot < 0) return;  // Tabelle voll
    PeerTracker &p = seenPeers[slot];
    if (p.lastSeen == 0) {
        memcpy(p.mac, mac, 6);
        p.ver_known = 0;
        p.rssi = rssi;  // neuer Peer: direkt übernehmen
    } else {
        p.rssi += (rssi - p.rssi) * PEER_RSSI_SMOOTH;
    }
    p.lastSeen = now;
    if (hasVer) {
        p.ver_major = vmaj;
        p.ver_minor = vmin;
        p.ver_rel = vrel;
        p.ver_dbg = vdbg;
        p.ver_known = 1;
    }
}

void OnDataRecv(const esp_now_recv_info_t *recv_info, const uint8_t *incomingData, int len) {
    if (len < (int)SYNC_PACKET_LEGACY_LEN) return;
    if (*(const uint32_t *)incomingData != MAGIC_ID) return;

    SyncPacket rx;
    memset(&rx, 0, sizeof(rx));
    memcpy(&rx, incomingData, (size_t)len < sizeof(rx) ? (size_t)len : sizeof(rx));
    const bool hasVer = (len >= (int)sizeof(SyncPacket));

    const float currentRSSI = (float)recv_info->rx_ctrl->rssi;

    portENTER_CRITICAL(&stateMux);
    // now erst unter der Sperre lesen: so ist es nie früher als ein startTime/stopLastSent,
    // das loop() gerade gesetzt hat (now - x würde sonst überlaufen).
    const uint32_t now = millis();
    // Stationen (Basisstation/Bridge, FW-Major 0) sind keine Badges: nicht als Peer zählen,
    // sonst verschiebt jeder Effekt (und ein laufender Beat dauerhaft) Primzahl/Singularität um eins.
    const bool fromStation = hasVer && rx.ver_major == 0;
    if (!fromStation) {
        // Das Signal wird je Peer geführt; loop() nimmt daraus das stärkste (nächstes Badge).
        trackBadge(recv_info->src_addr, currentRSSI, hasVer, rx.ver_major, rx.ver_minor, rx.ver_rel,
                   rx.ver_dbg);
    }

    // Takt nur von Badges übernehmen: Stationen senden ihr millis() als beatCounter,
    // das würde den Schwarm bei jedem Effekt in der Phase springen lassen.
    // Bei Ambient ist beatCounter eine Farbe.
    // (Tap-Pakete tragen millis() im beatCounter → nie als Takt übernehmen.)
    if (rx.mode != SYNC_MODE_AMBIENT && rx.mode != SYNC_MODE_TAP && !fromStation) {
        int32_t ahead = (int32_t)(rx.beatCounter - heartBeatState);
        if (ahead > (int32_t)BEAT_JUMP_THRESHOLD) {
            heartBeatState = rx.beatCounter;
            beatCatchup = 0;
        } else if (ahead > 0 && (uint32_t)ahead > beatCatchup) {
            beatCatchup = (uint32_t)ahead;
        }
    }

    #define FX_START(idx, rxid) do { if ((rxid) != fx[idx].id) { fx[idx].id = (rxid); fx[idx].startTime = now; fx[idx].active = true; } } while(0)
    // Visueller Effekt: wie FX_START, löscht zusätzlich die anderen visuellen Slots (letzter gewinnt).
    // Dieselbe ID erneut (Echo/Weiterleitung eines bereits gesehenen oder gestoppten Effekts) tut nichts.
    #define VIS_START(idx, rxid) do { if ((rxid) != fx[idx].id) { clearOtherVisualFx(idx); fx[idx].id = (rxid); fx[idx].startTime = now; fx[idx].active = true; } } while(0)

    if (rx.mode == SYNC_MODE_VIRUS)   VIS_START(E_VIRUS,   rx.virusID);
    if (rx.mode == SYNC_MODE_RAINBOW) VIS_START(E_RAINBOW, rx.virusID);
    if (rx.mode == SYNC_MODE_PRIME)   VIS_START(E_PRIME,   rx.virusID);
    if (rx.mode == SYNC_MODE_WAVE) {
        // RSSI genau dieses Pakets (nicht smoothRSSI: das ist die Nähe zum nächsten Badge).
        // Badge-Pakete ab 1.4.0 tragen die Zyklus-Phase + Sender-Verzögerung;
        // Station und ältere Badges nicht (Phase 0, Sender-Verzögerung 0).
        uint32_t elapsed = 0, senderDelay = 0;
        if (!fromStation && len >= (int)WAVE_PACKET_LEN) {
            uint16_t wi[2];
            memcpy(wi, incomingData + sizeof(SyncPacket), sizeof(wi));
            elapsed = (uint32_t)wi[0] % WAVE_DURATION_MS;  // alte Badges senden ohnehin < 4000
            senderDelay = wi[1];
        }
        uint32_t d = waveDelayFor(currentRSSI, fromStation, senderDelay);
        if (rx.virusID == waveStopId) {
            // Gestoppte Welle (ggf. von Nachbarn weitergeleitet): ignorieren
        } else if (rx.virusID != fx[E_WAVE].id) {
            // Neue Welle bzw. später Einstieg in die laufende Welle: immer übernehmen
            clearOtherVisualFx(E_WAVE);
            fx[E_WAVE].id = rx.virusID;
            fx[E_WAVE].startTime = now - elapsed;
            fx[E_WAVE].active = true;
            waveDelay = d;
        } else if (fx[E_WAVE].active && d < waveDelay) {
            // Kürzerer Weg (z. B. Basis direkt nach einer Weiterleitung): übernehmen,
            // solange der eigene Puls im aktuellen Zyklus noch nicht läuft.
            uint32_t sinceStart = (now - fx[E_WAVE].startTime) % WAVE_DURATION_MS;
            if (sinceStart < waveDelay) waveDelay = d > sinceStart ? d : sinceStart;
        }
    }
    if (rx.mode == SYNC_MODE_WAVE_STOP) {
        // Welle beenden und ihre ID sperren. Weiterleitung nur, wenn gerade keine läuft
        // und die Sperre nach der letzten Weiterleitung abgelaufen ist; gesendet wird in loop().
        // Zu sperrende ID: laufende lokale Welle (echte ID, auch bei alter Basis mit Zufalls-ID),
        // sonst die Ziel-ID aus dem Paket (Welle trifft evtl. erst noch ein; 0 = unbekannt).
        // Ziel-ID: 0 = Wildcard → konkret die laufende lokale Welle nehmen.
        uint32_t zielId = rx.virusID;
        if (zielId == 0 && fx[E_WAVE].active && fx[E_WAVE].id != 0) zielId = fx[E_WAVE].id;
        if (zielId == 0) {
            // Ziel wirklich unbekannt (keine aktive Welle): nur lokal beenden, keine ID sperren
            fx[E_WAVE].active = false;
        } else {
            // Nur die passende Welle beenden; fremde laufende Welle bleibt
            if (fx[E_WAVE].active && fx[E_WAVE].id == zielId) fx[E_WAVE].active = false;
            waveStopId = zielId;  // Sperre immer setzen
        }
        const bool locked = stopLockActive && (now - stopLastSent < WAVE_STOP_LOCK_MS);
        if (stopFwdLeft == 0 && !locked) {
            stopFwdId = zielId;  // konkrete Ziel-ID weiterreichen
            stopFwdLeft = WAVE_STOP_FWD_COUNT;
            stopFwdNext = now;
        }
    }
    if (rx.mode == SYNC_MODE_STOP_ALL) {
        // Mit Kennung: jeder Stopp wirkt genau einmal. Ein Echo eines schon verarbeiteten Stopps
        // wird ignoriert — es darf keinen Effekt abschalten, der nach dem Stopp gestartet wurde
        // (dessen ID gälte sonst als „schon gesehen“ und er käme nie wieder).
        // Ohne Kennung (0, alte Sender): wie früher, Weiterleitung nur über die Sperre begrenzt.
        bool fresh = true, forward = false;
        if (rx.virusID != 0) {
            for (int i = 0; i < ALL_STOP_SEEN_SLOTS; i++) {
                if (allStopSeen[i] == rx.virusID) fresh = false;
            }
            if (fresh) {
                allStopSeen[allStopSeenPos] = rx.virusID;
                allStopSeenPos = (allStopSeenPos + 1) % ALL_STOP_SEEN_SLOTS;
                forward = true;
            }
        } else {
            const bool locked = allStopLockActive && (now - allStopLastSent < ALL_STOP_LOCK_MS);
            forward = (allStopFwdLeft == 0 && !locked);
        }
        if (fresh) {
            // Alle Effekte abräumen (auch Welle und Beat), nur Identify läuft seine 10 s zu Ende.
            // Die IDs bleiben stehen: Echos/verspätete Pakete derselben Effekte starten nichts neu.
            for (int i = 0; i < E_COUNT; i++) {
                if (i != E_IDENTIFY) fx[i].active = false;
            }
        }
        // Begrenzt weiterleiten (Kennung unverändert); gesendet wird in loop().
        if (forward) {
            allStopFwdId = rx.virusID;
            allStopFwdLeft = ALL_STOP_FWD_COUNT;
            allStopFwdNext = now;
        }
    }
    if (rx.mode == SYNC_MODE_TAP && hasVer && !fromStation && rx.virusID != 0) {
        // Direkt: Absender = Badge. Weitergeleitet (23 Byte): Ursprungs-MAC im Anhang.
        const uint8_t *origin = (len >= (int)TAP_FWD_PACKET_LEN)
            ? incomingData + sizeof(SyncPacket) : recv_info->src_addr;
        if (memcmp(origin, ownMac, 6) != 0) tapOnReceive(origin, rx.virusID, now);  // eigene Echos ignorieren
    }
#if OTA_ENABLED
    // Funk-Update: nur ablegen (eine noch nicht gesehene Kennung, ein Platz); loop() prüft den HMAC.
    if (rx.mode == SYNC_MODE_OTA && len == (int)sizeof(OtaTrigger) && !otaRxPending) {
        bool seen = false;
        for (int i = 0; i < OTA_SEEN_SLOTS; i++) {
            if (otaSeen[i] == rx.virusID) seen = true;
        }
        if (!seen) {
            memcpy(otaRxBuf, incomingData, sizeof(otaRxBuf));
            otaRxPending = true;
        }
    }
#endif
    if (rx.mode == SYNC_MODE_BEAT)    FX_START(E_BEAT,    rx.virusID);
    if (rx.mode == SYNC_MODE_ZONE)    VIS_START(E_ZONE,    rx.virusID);
    if (rx.mode == SYNC_MODE_AMBIENT && rx.virusID != fx[E_AMBIENT].id) {
        clearOtherVisualFx(E_AMBIENT);
        fx[E_AMBIENT].id = rx.virusID;
        fx[E_AMBIENT].startTime = now;
        fx[E_AMBIENT].active = true;
        ambientR = (rx.beatCounter >> 16) & 0xFF;
        ambientG = (rx.beatCounter >> 8) & 0xFF;
        ambientB = rx.beatCounter & 0xFF;
    }
    if (rx.mode == SYNC_MODE_STROBE)  VIS_START(E_STROBE,  rx.virusID);
    if (rx.mode == SYNC_MODE_IDENTIFY && len >= (int)IDENTIFY_PACKET_LEN &&
        memcmp(incomingData + sizeof(SyncPacket), ownMac, 6) == 0) {
        FX_START(E_IDENTIFY, rx.virusID);
    }
    #undef VIS_START
    #undef FX_START
    portEXIT_CRITICAL(&stateMux);
}

// ===================== BEWEGUNGSSENSOR (QMI8658) =====================
// Nur der Beschleunigungssensor (±8 g, 125 Hz), gelesen aus loop(). Drei Verwendungen:
// Schütteln → Herzflattern; optional Herz immer aufrecht; optional Abdunkeln in Ruhe.
// Alles bleibt aus, wenn der Sensor beim Start nicht antwortet oder keine ~1 g meldet —
// die Firmware läuft dann wie ohne Sensor.
static uint64_t heartMaskRot[4];   // Herz-Maske in 0°, 90°, 180°, 270° (im Uhrzeigersinn)
static uint8_t  heartRot = 0;      // aktuell verwendete Drehung
#if ENABLE_IMU
#define IMU_REG_WHO_AM_I 0x00      // liefert 0x05
#define IMU_REG_CTRL1    0x02
#define IMU_REG_CTRL2    0x03
#define IMU_REG_CTRL7    0x08
#define IMU_REG_AX_L     0x35      // AX_L, AX_H, AY_L, AY_H, AZ_L, AZ_H
#define IMU_LSB_PER_G    4096.0f   // bei ±8 g

static bool     imuOk = false;
static uint8_t  imuErrors = 0;
static uint32_t imuFlutterUntil = 0;
static bool     imuFlutter = false;
static uint32_t imuLastMotion = 0;

static bool imuWrite(uint8_t reg, uint8_t val) {
    Wire.beginTransmission((uint8_t)IMU_ADDR);
    Wire.write(reg);
    Wire.write(val);
    return Wire.endTransmission() == 0;
}

static bool imuRead(uint8_t reg, uint8_t *buf, uint8_t n) {
    Wire.beginTransmission((uint8_t)IMU_ADDR);
    Wire.write(reg);
    if (Wire.endTransmission(false) != 0) return false;
    if (Wire.requestFrom((uint8_t)IMU_ADDR, (size_t)n) != n) return false;
    for (uint8_t i = 0; i < n; i++) buf[i] = (uint8_t)Wire.read();
    return true;
}

// Beschleunigung in g je Achse (Sensor-Achsen).
static bool imuReadAccel(float *x, float *y, float *z) {
    uint8_t b[6];
    if (!imuRead(IMU_REG_AX_L, b, sizeof(b))) return false;
    *x = (int16_t)((uint16_t)b[1] << 8 | b[0]) / IMU_LSB_PER_G;
    *y = (int16_t)((uint16_t)b[3] << 8 | b[2]) / IMU_LSB_PER_G;
    *z = (int16_t)((uint16_t)b[5] << 8 | b[4]) / IMU_LSB_PER_G;
    return true;
}

static void imuInit() {
    Wire.begin(IMU_SDA_PIN, IMU_SCL_PIN, 100000);  // 100 kHz: das Board hat keine I²C-Pull-ups
    Wire.setTimeOut(20);
    uint8_t id = 0;
    if (!imuRead(IMU_REG_WHO_AM_I, &id, 1) || id != 0x05) return;  // kein QMI8658
    imuWrite(IMU_REG_CTRL1, 0x60);  // Register-Adresse zählt beim Lesen automatisch hoch
    imuWrite(IMU_REG_CTRL2, 0x26);  // Beschleunigung ±8 g, 125 Hz
    imuWrite(IMU_REG_CTRL7, 0x01);  // nur Beschleunigungssensor an (Gyro bleibt aus)
    delay(30);
    // Plausibilität: in Ruhe müssen etwa 1 g herauskommen. Sonst stimmt Messbereich oder
    // Byte-Reihenfolge nicht mit den Annahmen hier überein → Sensor nicht verwenden.
    for (int i = 0; i < 5 && !imuOk; i++) {
        float x, y, z;
        if (imuReadAccel(&x, &y, &z)) {
            const float mag = sqrtf(x * x + y * y + z * z);
            if (mag > 0.7f && mag < 1.4f) imuOk = true;
        }
        if (!imuOk) delay(10);
    }
    imuLastMotion = millis();
#if ENABLE_SERIAL_DEBUG
    Serial.printf("[IMU] QMI8658 gefunden, %s\n", imuOk ? "aktiv" : "Werte unplausibel -> aus");
#endif
}

// Einmal pro Frame aus loop(); liest höchstens alle IMU_READ_INTERVAL_MS.
static void imuPoll(uint32_t now) {
    static uint32_t lastRead = 0;
    if (imuFlutter && (int32_t)(now - imuFlutterUntil) >= 0) imuFlutter = false;
    if (!imuOk || now - lastRead < IMU_READ_INTERVAL_MS) return;
    lastRead = now;

    float x, y, z;
    if (!imuReadAccel(&x, &y, &z)) {
        if (++imuErrors >= 10) imuOk = false;  // Sensor antwortet nicht mehr: aufgeben
        return;
    }
    imuErrors = 0;

    // --- Lage: welche Kante zeigt nach unten? (nur wenn genug Schwerkraft in der Matrix-Ebene liegt)
    const float ax = fabsf(x), ay = fabsf(y);
    int8_t cand = -1;
    if (ax > IMU_UPRIGHT_MIN_G && ax > 1.5f * ay) cand = x > 0 ? 0 : 2;
    else if (ay > IMU_UPRIGHT_MIN_G && ay > 1.5f * ax) cand = y > 0 ? 1 : 3;
#if IMU_AUTO_ROTATE
    static int8_t pending = -1;
    static uint32_t pendingSince = 0;
    if (cand < 0) {
        pending = -1;  // flach oder schräg: Lage behalten
    } else {
        const uint8_t rot = (uint8_t)(((IMU_MIRROR ? 4 - cand : cand) + IMU_ROTATION_OFFSET) & 3);
        if (rot == heartRot) {
            pending = -1;
        } else if (pending != (int8_t)rot) {
            pending = (int8_t)rot;
            pendingSince = now;
        } else if (now - pendingSince >= IMU_ROT_HOLD_MS) {
            heartRot = rot;
            pending = -1;
        }
    }
#endif

    // --- Schütteln: mehrere deutlich von 1 g abweichende Messungen kurz nacheinander
    const float mag = sqrtf(x * x + y * y + z * z);
    static uint8_t hits = 0;
    static uint32_t firstHit = 0;
    if (fabsf(mag - 1.0f) > IMU_SHAKE_G) {
        if (hits == 0 || now - firstHit > IMU_SHAKE_WINDOW_MS) {
            hits = 0;
            firstHit = now;
        }
        if (++hits >= IMU_SHAKE_HITS) {
            hits = 0;
            imuFlutter = true;
            imuFlutterUntil = now + IMU_FLUTTER_MS;
        }
    }

    // --- Bewegung (für das Abdunkeln in Ruhe): Abstand zur letzten gemerkten Lage
    static float refX = 0, refY = 0, refZ = 0;
    if (fabsf(x - refX) > IMU_MOTION_G || fabsf(y - refY) > IMU_MOTION_G || fabsf(z - refZ) > IMU_MOTION_G) {
        refX = x; refY = y; refZ = z;
        imuLastMotion = now;
    }

#if ENABLE_SERIAL_DEBUG
    // Zum Einmessen von IMU_ROTATION_OFFSET / IMU_MIRROR: „Lage“ ist der Rohwert 0…3 (−1 = flach).
    static uint32_t lastLog = 0;
    if (now - lastLog >= 2000) {
        lastLog = now;
        Serial.printf("[IMU] x=%.2f y=%.2f z=%.2f |a|=%.2f Lage=%d Drehung=%u\n",
                      x, y, z, mag, (int)cand, (unsigned)heartRot);
    }
#else
    (void)cand;
#endif
}
#endif  // ENABLE_IMU

void setup() {
#if ENABLE_SERIAL_DEBUG
    Serial.begin(115200);
    printFwVersionBanner();
#endif
    pinMode(BUTTON_PIN, INPUT_PULLUP);
    // Versions-Marker lesen (volatile-Zeiger): hält "HERZFW:x.y.z;" im Binary (siehe oben).
    if (fwMarkerPtr[0] != 'H') return;

    // Tap-Zählerstand laden (Fehler → bei 0 starten) und nach dem Boot einmal melden
    {
        Preferences prefs;
        if (prefs.begin(TAP_NVS_NAMESPACE, false)) {
            tapCount = prefs.getUInt(TAP_NVS_KEY, 0);
            prefs.end();
        }
        tapLastSave = millis();
        if (tapCount > 0) {
            tapBurstLeft = TAP_SEND_COUNT;
            tapBurstNext = millis() + TAP_BOOT_DELAY_MS;
        }
    }

    // Herz-Bitmaske einmalig aus Array aufbauen
    for (int i = 0; i < 64; i++) {
        if (heartMask[i / 8][i % 8]) heartMask64 |= (1ULL << i);
    }
    // Gedrehte Masken (je 90° im Uhrzeigersinn weiter): neu[z][s] = alt[7 - s][z]
    heartMaskRot[0] = heartMask64;
    for (int k = 1; k < 4; k++) {
        heartMaskRot[k] = 0;
        for (int z = 0; z < 8; z++) {
            for (int s = 0; s < 8; s++) {
                if ((heartMaskRot[k - 1] >> ((7 - s) * 8 + z)) & 1) heartMaskRot[k] |= (1ULL << (z * 8 + s));
            }
        }
    }

    WiFi.mode(WIFI_STA);
    esp_wifi_get_mac(WIFI_IF_STA, ownMac);
    // 11B ist Pflicht: ESP-IDF 5.x lehnt G|N ohne B mit ESP_ERR_INVALID_ARG ab.
    esp_wifi_set_protocol(WIFI_IF_STA, WIFI_PROTOCOL_11B | WIFI_PROTOCOL_11G | WIFI_PROTOCOL_11N);
    esp_wifi_set_channel(CCC_CHANNEL, WIFI_SECOND_CHAN_NONE);
    esp_wifi_set_max_tx_power(52);
    WiFi.setSleep(false);

    if (esp_now_init() != ESP_OK) return;

    esp_now_peer_info_t peerInfo = {};
    memcpy(peerInfo.peer_addr, broadcastMac, 6);
    peerInfo.channel = CCC_CHANNEL;
    peerInfo.encrypt = false;
    esp_now_add_peer(&peerInfo);
    esp_now_register_recv_cb(OnDataRecv);

    // WICHTIG: Waveshare-Matrix ist hier RGB verdrahtet — am Gerät verifiziert:
    // mit BGR waren Rot und Blau vertauscht. Rückweg: BGR bzw. GRB (GRB wäre falsch: Rot würde Grün).
    FastLED.addLeds<WS2812B, LED_PIN, RGB>(leds, NUM_LEDS);
    FastLED.clear();
    FastLED.show();

#if ENABLE_IMU
    imuInit();
#endif
}

void loop() {
    uint32_t now = millis();

    // 1. MORSE ERKENNUNG (char-Array statt String)
    bool btn = (digitalRead(BUTTON_PIN) == LOW);
    if (btn && btnDownTime == 0) btnDownTime = now;
    if (!btn && btnDownTime != 0) {
        uint32_t duration = now - btnDownTime;
        char sym = (duration > 250) ? '-' : '.';
        if (morseLen < sizeof(morseBuf) - 1) {
            morseBuf[morseLen++] = sym;
            morseBuf[morseLen] = '\0';
        }
#if ENABLE_SERIAL_DEBUG
        Serial.printf("[Morse] +%c (%lu ms) Puffer: \"%s\"\n",
                      sym, (unsigned long)duration, morseBuf);
#endif
        btnDownTime = 0;
        lastBtnRelease = now;
        if (sym == '.' && tapCount < UINT32_MAX) {  // Druck <= 250 ms = Tap (zusätzlich zur Morse-Logik)
            tapCount++;
            tapDirty = true;
            tapBurstLeft = TAP_SEND_COUNT;
            tapBurstNext = now;
            tapResendPending = false;
        }
    }
    if (morseLen > 0 && (now - lastBtnRelease > 800)) {
        if (strcmp(morseBuf, "-.-.") == 0) {
            // ID im Morse-Bereich (1..MORSE_VIRUS_ID_MAX): dieser Virus endet überall nach 3 s
            uint32_t id = (uint32_t)(esp_random() % MORSE_VIRUS_ID_MAX) + 1;
            portENTER_CRITICAL(&stateMux);
            clearOtherVisualFx(E_VIRUS);  // letzter Effekt gewinnt
            fx[E_VIRUS].id = id;
            fx[E_VIRUS].startTime = now;
            fx[E_VIRUS].active = true;
            portEXIT_CRITICAL(&stateMux);
#if ENABLE_SERIAL_DEBUG
            Serial.println("[Morse] Wortende -> VIRUS (-.-.)");
#endif
        }
#if ENABLE_SERIAL_DEBUG
        else {
            Serial.printf("[Morse] Wortende -> ignoriert (\"%s\")\n", morseBuf);
        }
#endif
        morseLen = 0;
        morseBuf[0] = '\0';
    }

    // 2.–4. GEMEINSAMER ZUSTAND: aktualisieren + Snapshot für den Frame (unter stateMux)
    float inputRSSI, norm, power;
    float rssiSnapshot;
    static uint32_t lastBeatMs = now;
    static uint8_t modeBpm = 35;
    EffectState fs[E_COUNT];
    uint32_t waveDelayS;
    uint8_t ambR, ambG, ambB;

    // Kurz halten: nur Zählen, ein paar float-Operationen und Kopien, keine I/O.
    portENTER_CRITICAL(&stateMux);
    // now neu lesen: OnDataRecv kann seit Loop-Beginn lastSeen/startTime auf einen
    // späteren Wert gesetzt haben, now - x würde sonst überlaufen (Peer/Effekt weg).
    now = millis();

    // 2. PEER COUNT & TIMEOUT CLEANUP + stärkstes Signal (= nächstes Badge)
    uniquePeerCount = 0;
    float nearRSSI = -95.0f;  // kein Peer: ganz „fern“
    for (int i = 0; i < MAX_PEERS; i++) {
        if (seenPeers[i].lastSeen != 0) {
            if (now - seenPeers[i].lastSeen > PEER_TIMEOUT) {
                seenPeers[i].lastSeen = 0;  // lastSeen==0 = Slot frei
            } else {
                uniquePeerCount++;
                if (seenPeers[i].rssi > nearRSSI) nearRSSI = seenPeers[i].rssi;
            }
        }
    }

    // 3. NÄHE: weich dem nächsten Badge folgen (nicht dem Mittel über alle — in einer Gruppe
    // ginge die Person direkt neben einem sonst im Durchschnitt unter). Verschwindet der
    // nächste Peer, sinkt der Wert ebenso weich auf den zweitnächsten bzw. auf -95.
    smoothRSSI += (nearRSSI - smoothRSSI) * NEAR_SMOOTH;
    if (smoothRSSI < -95) smoothRSSI = -95;
    rssiSnapshot = smoothRSSI;

    // 4. RSSI MAPPING (nur Helligkeit) + Takt fortschreiben. Das Tempo hängt nur am Modus des
    // letzten Frames, nicht an der Nähe: wegen der Max-Regel im Schwarm-Takt hätte sonst das
    // am engsten stehende Paar das Tempo aller bestimmt.
    inputRSSI = constrain(rssiSnapshot, -95, -45);
    norm = (inputRSSI - (-95)) / 50.0f;
    power = norm * norm;
    {
        float bpm = modeBpm + 23.4f;
        uint32_t beatStep = (uint32_t)(bpm * (float)(now - lastBeatMs) * (BEAT_UNITS_PER_PULSE / 60000.0f));
        uint32_t catchStep = beatCatchup ? beatCatchup / 4 + 1 : 0;
        if (catchStep > beatCatchup) catchStep = beatCatchup;
        beatCatchup -= catchStep;
        heartBeatState += beatStep + catchStep;
    }
    lastBeatMs = now;
    frameBeat = heartBeatState;

    // Nur Beat, Identify und der Morse-Virus (ID im Morse-Bereich) laufen aus; alle anderen
    // visuellen Effekte laufen endlos (bis Modus 12 oder ein anderer visueller Effekt).
    // Snapshot für das Rendern.
    for (int i = 0; i < E_COUNT; i++) {
        if (i == E_WAVE) {
            // Welle läuft endlos: nie ablaufen, sondern startTime um ganze Zyklen vorsetzen
            // (verpasste Zyklen werden in einem Schritt aufgeholt; kein Wraparound-Problem,
            // da startTime <= now gilt und die Differenz unsigned gerechnet wird).
            if (fx[i].active) {
                uint32_t age = now - fx[i].startTime;
                if (age >= WAVE_DURATION_MS) fx[i].startTime += (age / WAVE_DURATION_MS) * WAVE_DURATION_MS;
            }
        } else if ((i == E_BEAT || i == E_IDENTIFY ||
                    (i == E_VIRUS && fx[i].id <= MORSE_VIRUS_ID_MAX)) && fx[i].active &&
                   now - fx[i].startTime >= fxDurationMs[i]) {
            fx[i].active = false;
        }
        fs[i] = fx[i];
    }
    waveDelayS = waveDelay;
    ambR = ambientR; ambG = ambientG; ambB = ambientB;

    // Stopp-Weiterleitung: höchstens eine Sendung pro Frame, Gesamtzahl/Abstand/Sperre
    // über Zustand unter stateMux; gesendet wird nach dem Freigeben der Sperre.
    bool sendStopNow = false;
    uint32_t stopIdS = 0;
    if (stopFwdLeft > 0 && (int32_t)(now - stopFwdNext) >= 0) {
        sendStopNow = true;
        stopIdS = stopFwdId;
        stopFwdLeft--;
        stopFwdNext = now + WAVE_STOP_FWD_GAP_MS;
        if (stopFwdLeft == 0) {  // letzte Sendung: ab jetzt 1000 ms Sperre
            stopLastSent = now;
            stopLockActive = true;
        }
    }

    // „Alle stoppen“-Weiterleitung: gleiches Muster (max. 3 Sendungen, ~60 ms Abstand, dann Sperre)
    bool sendAllStopNow = false;
    uint32_t allStopIdS = 0;
    if (allStopFwdLeft > 0 && (int32_t)(now - allStopFwdNext) >= 0) {
        sendAllStopNow = true;
        allStopIdS = allStopFwdId;
        allStopFwdLeft--;
        allStopFwdNext = now + ALL_STOP_FWD_GAP_MS;
        if (allStopFwdLeft == 0) {  // letzte Sendung: ab jetzt 1000 ms Sperre
            allStopLastSent = now;
            allStopLockActive = true;
        }
    }

    portEXIT_CRITICAL(&stateMux);

    // sendSync nimmt stateMux selbst (nicht verschachteln) — daher erst hier. Es setzt
    // txData.mode, der reguläre Sync-Block unten sendet dadurch im selben Frame direkt danach.
    if (sendStopNow) sendSync(SYNC_MODE_WAVE_STOP, stopIdS);
    if (sendAllStopNow) sendSync(SYNC_MODE_STOP_ALL, allStopIdS);

    // Tap-Counter senden (nicht blockierend, höchstens je ein Paket eigener Stand / Weiterleitung pro Frame)
    if (tapBurstLeft > 0 && (int32_t)(now - tapBurstNext) >= 0) {
        sendTap(nullptr, tapCount);
        tapBurstLeft--;
        tapBurstNext = now + TAP_SEND_GAP_MS;
        if (tapBurstLeft == 0) {
            tapResendPending = true;
            tapResendAt = now + TAP_RESEND_MS;
        }
    } else if (tapResendPending && tapBurstLeft == 0 && (int32_t)(now - tapResendAt) >= 0) {
        tapResendPending = false;
        sendTap(nullptr, tapCount);
    }
    {
        bool fwdNow = false;
        uint8_t fwdMac[6];
        uint32_t fwdCount = 0;
        portENTER_CRITICAL(&stateMux);
        const uint32_t t = millis();
        if (tapFwdLeft > 0 && (int32_t)(t - tapFwdNext) >= 0) {
            fwdNow = true;
            memcpy(fwdMac, tapFwdMac, 6);
            fwdCount = tapFwdCount;
            tapFwdLeft--;
            tapFwdNext = t + TAP_FWD_GAP_MS;
            if (tapFwdLeft == 0) {  // letzte Sendung: ab jetzt TAP_FWD_LOCK_MS Sperre
                tapFwdLastSent = t;
                tapFwdLockActive = true;
            }
        }
        portEXIT_CRITICAL(&stateMux);
        if (fwdNow) sendTap(fwdMac, fwdCount);
    }
    // Zählerstand gedrosselt sichern (höchstens alle 30 s, nur bei Änderung)
    if (tapDirty && now - tapLastSave >= TAP_SAVE_INTERVAL_MS) {
        tapDirty = false;
        tapLastSave = now;
        tapSave();
    }

#if OTA_ENABLED
    otaPoll(now);  // kehrt nicht zurück, sobald ein angenommenes Update startet
#endif
#if ENABLE_IMU
    imuPoll(now);
#endif

    uint8_t currentBright = BRIGHT_MIN + (uint8_t)(power * (BRIGHT_MAX - BRIGHT_MIN));

    // 5. ANIMATIONS-WEICHE
    FastLED.clear();
    uint8_t pulse = 0;
    uint8_t activeMode = 0;      // für txData.mode
    uint32_t activeFxId = 0;     // für txData.virusID

    bool identifying = false;
    if (fs[E_IDENTIFY].active && (now - fs[E_IDENTIFY].startTime < IDENTIFY_MS)) {
        // BADGE FINDEN: grünes Blinken, volle Helligkeit (siehe currentBright unten)
        if (((now - fs[E_IDENTIFY].startTime) / IDENTIFY_BLINK_MS) % 2 == 0) {
            fill_solid(leds, NUM_LEDS, CRGB::Green);
        }
        identifying = true;
        activeMode = SYNC_MODE_IDENTIFY;
        activeFxId = fs[E_IDENTIFY].id;
    }
    else if (fs[E_BEAT].active && (now - fs[E_BEAT].startTime < BEAT_PULSE_MS)) {
        // Beat-Puls hat Vorrang vor den endlosen visuellen Effekten (nur innerhalb seiner 150 ms)
        uint32_t elapsed = now - fs[E_BEAT].startTime;
        uint8_t brightness;
        if (elapsed < BEAT_PULSE_MS / 2) {
            brightness = (uint8_t)((elapsed * 255) / (BEAT_PULSE_MS / 2));
        } else {
            brightness = (uint8_t)(((BEAT_PULSE_MS - elapsed) * 255) / (BEAT_PULSE_MS / 2));
        }
        fill_solid(leds, NUM_LEDS, CRGB::White);
        nscale8(leds, NUM_LEDS, brightness);
        activeMode = SYNC_MODE_BEAT;
        activeFxId = fs[E_BEAT].id;
    }
    else if (fs[E_VIRUS].active) {
        // MORSE / REMOTE VIRUS BLITZ — Morse-Virus endet nach 3 s (siehe MORSE_VIRUS_ID_MAX),
        // der von einer Station läuft endlos: Zyklus 3000 ms ist ein Vielfaches von 300 ms
        uint32_t flash = ((now - fs[E_VIRUS].startTime) % fxDurationMs[E_VIRUS]) % 300;
        if (flash < 150) fill_solid(leds, NUM_LEDS, CRGB::White);
        activeMode = SYNC_MODE_VIRUS;
        activeFxId = fs[E_VIRUS].id;
    }
    else if (fs[E_RAINBOW].active) {  // endlos (Farbton + Puls über den Schwarm-Takt, kein Zeitfenster nötig)
        modeBpm = 100;
        pulse = swarmPulse(150, 255);
        const uint8_t hue = swarmHue();
        for (int i = 0; i < NUM_LEDS; i++) leds[i] = CHSV(hue + (i*3), 255, pulse);
        activeMode = SYNC_MODE_RAINBOW;
        activeFxId = fs[E_RAINBOW].id;
    }
    else if (fs[E_PRIME].active) {  // endlos (Puls über den Schwarm-Takt, kein Zeitfenster nötig)
        modeBpm = 80;
        pulse = swarmPulse(120, 255);
        fill_solid(leds, NUM_LEDS, heartColor);
        nscale8(leds, NUM_LEDS, pulse);
        if (random8() > 210) leds[random8(64)] = CRGB::White;
        activeMode = SYNC_MODE_PRIME;
        activeFxId = fs[E_PRIME].id;
    }
    else if (fs[E_WAVE].active) {
        // Phase im Zyklus (loop() hat startTime bereits vorgesetzt; Modulo als Absicherung)
        uint32_t elapsed = (now - fs[E_WAVE].startTime) % WAVE_DURATION_MS;
        if (elapsed >= waveDelayS && elapsed < waveDelayS + WAVE_PULSE_MS) {
            uint32_t pulseElapsed = elapsed - waveDelayS;
            uint8_t brightness;
            if (pulseElapsed < 200) {
                brightness = (uint8_t)((pulseElapsed * 255) / 200);
            } else if (pulseElapsed < 500) {
                brightness = 255;
            } else {
                brightness = (uint8_t)(((WAVE_PULSE_MS - pulseElapsed) * 255) / 200);
            }
            fill_solid(leds, NUM_LEDS, CRGB(100, 150, 255));
            nscale8(leds, NUM_LEDS, brightness);
        }
        activeMode = SYNC_MODE_WAVE;
        activeFxId = fs[E_WAVE].id;
    }
    else if (fs[E_ZONE].active) {  // endlos (statische Farbe + Schwarm-Puls)
        CRGB zoneColor;
        if (rssiSnapshot > -55) zoneColor = ZONE0_COLOR;
        else if (rssiSnapshot > -75) zoneColor = ZONE1_COLOR;
        else zoneColor = ZONE2_COLOR;
        modeBpm = 60;
        pulse = swarmPulse(150, 255);
        fill_solid(leds, NUM_LEDS, zoneColor);
        nscale8(leds, NUM_LEDS, pulse);
        activeMode = SYNC_MODE_ZONE;
        activeFxId = fs[E_ZONE].id;
    }
    else if (fs[E_AMBIENT].active) {  // endlos (statische Farbe)
        fill_solid(leds, NUM_LEDS, CRGB(ambR, ambG, ambB));
        activeMode = SYNC_MODE_AMBIENT;
        activeFxId = fs[E_AMBIENT].id;
    }
    else if (fs[E_STROBE].active) {
        // endlos; bewusst ohne Modulo STROBE_DURATION_MS: 2000/80 = 25 (ungerade) würde beim Wrap
        // einen doppelt langen Blitz ergeben — die 160-ms-Periode läuft direkt weiter
        uint32_t elapsed = now - fs[E_STROBE].startTime;
        if ((elapsed / STROBE_FLASH_MS) % 2 == 0) {
            fill_solid(leds, NUM_LEDS, CRGB::White);
        }
        activeMode = SYNC_MODE_STROBE;
        activeFxId = fs[E_STROBE].id;
    }
    else if (uniquePeerCount + 1 >= 17) {
        // THE SINGULARITY
        modeBpm = 100;
        pulse = swarmPulse(150, 255);
        const uint8_t hue = swarmHue();
        for (int i = 0; i < NUM_LEDS; i++) leds[i] = CHSV(hue + (i*3), 255, pulse);
        activeMode = 0;
    }
    else {
        uint8_t totalDevices = uniquePeerCount + 1;
        bool prime = isPrimeFast(totalDevices);
        modeBpm = prime ? 80 : 35;
        pulse = prime ? swarmPulse(120, 255) : swarmPulse(100, 255);
        fill_solid(leds, NUM_LEDS, heartColor);
        nscale8(leds, NUM_LEDS, pulse);
        if (prime && random8() > 210) leds[random8(64)] = CRGB::White;
        activeMode = 0;
    }

#if ENABLE_IMU
    // Herzflattern nach dem Schütteln: weiße Funken über dem normalen Herz. Nur lokal und nur
    // ohne ferngesteuerten Effekt (activeMode 0), damit Effekte auf allen Badges gleich bleiben.
    const bool flutter = imuFlutter && activeMode == 0 && !identifying;
    if (flutter) {
        for (int i = 0; i < 4; i++) leds[random8(64)] = CRGB::White;
    }
    // Abdunkeln in Ruhe (nur wenn eingeschaltet): das normale Herz leuchtet mit BRIGHT_MIN
    const bool resting = imuOk && IMU_REST_DIM_MS > 0 && activeMode == 0 && !identifying &&
                         now - imuLastMotion > (uint32_t)IMU_REST_DIM_MS;
    if (flutter) {
        if (currentBright < FX_BRIGHT) currentBright = FX_BRIGHT;  // Flattern soll man sehen
    } else if (resting) {
        currentBright = BRIGHT_MIN;
    }
#endif

    // Maske: Bitmaske statt 2D-Array-Lookup (heartRot = Drehung nach der Lage, sonst immer 0)
    const uint64_t mask = heartMaskRot[heartRot & 3];
    for (int i = 0; i < 64; i++) {
        if (!((mask >> i) & 1)) leds[i] = CRGB::Black;
    }

    // 6. SENDEN — während der Welle trägt jedes Paket Wellenstart + eigene Verzögerung
    // (sendSync), damit Nachbarn ihre Verzögerung daraus ableiten bzw. verkürzen.
    // Gedrosselt auf SYNC_TX_INTERVAL_MS; Effekt-/ID-Wechsel sofort, damit sich
    // Effekte ohne Verzögerung durch den Schwarm verbreiten.
    // Der Sendetakt bleibt auf einem festen 50-ms-Raster (lastTx += Intervall statt = now):
    // 50 ms ist kein Vielfaches der 20-ms-Frames, sonst würde nur alle 60 ms gesendet.
    static uint32_t lastTx = 0;
    const bool fxChanged = activeMode != txData.mode || activeFxId != txData.virusID;
    const uint32_t sinceTx = now - lastTx;
    if (fxChanged || sinceTx >= SYNC_TX_INTERVAL_MS) {
        sendSync(activeMode, activeFxId);
        lastTx = (fxChanged || sinceTx >= 2 * SYNC_TX_INTERVAL_MS) ? now : lastTx + SYNC_TX_INTERVAL_MS;
    }

    // 7. OUTPUT
    // Identify: volle Helligkeit. Ferngesteuerter Effekt (activeMode != 0): feste Helligkeit,
    // auf allen Badges gleich. Sonst (normales Herz, Singularität): Helligkeit nach Nähe.
    FastLED.setBrightness(identifying ? BRIGHT_MAX : (activeMode != 0 ? FX_BRIGHT : currentBright));
    FastLED.show();

#if ENABLE_SERIAL_DEBUG
    // Nur wenn ENABLE_SERIAL_DEBUG=1: kompletter Block fehlt sonst im Binary — keine Extra-Arbeit für die Animation.
    static uint32_t lastStatusLog = 0;
    if (now - lastStatusLog >= 2000) {
        lastStatusLog = now;
        char line[200];
        int n = snprintf(line, sizeof(line),
                         "Status | FW %u.%u.%02u+debug | Peers: %d | RSSI: %.1f | Bright: %d | Morse: \"%s\" | remote",
                         FW_VERSION_MAJOR, FW_VERSION_MINOR, FW_DEBUG_BUILD,
                         uniquePeerCount, rssiSnapshot, currentBright, morseBuf);
        static PeerTracker peerCopy[MAX_PEERS];
        portENTER_CRITICAL(&stateMux);
        memcpy(peerCopy, seenPeers, sizeof(peerCopy));
        portEXIT_CRITICAL(&stateMux);
        int listed = 0;
        for (int i = 0; i < MAX_PEERS && n < (int)sizeof(line) - 12 && listed < 10; i++) {
            if (peerCopy[i].lastSeen == 0) continue;
            if (peerCopy[i].ver_known) {
                if (peerCopy[i].ver_dbg) {
                    n += snprintf(line + n, sizeof(line) - (size_t)n, " %u.%u.%02u+",
                                  peerCopy[i].ver_major, peerCopy[i].ver_minor, peerCopy[i].ver_dbg);
                } else {
                    n += snprintf(line + n, sizeof(line) - (size_t)n, " %u.%u.%u",
                                  peerCopy[i].ver_major, peerCopy[i].ver_minor, peerCopy[i].ver_rel);
                }
            } else {
                n += snprintf(line + n, sizeof(line) - (size_t)n, " ?");
            }
            listed++;
        }
        Serial.println(line);
    }
#endif

    // 20 ms Frame-Raster: nur den Rest des Frames warten. frameStart ist der Beginn dieses
    // Durchlaufs (nach dem delay des vorigen gesetzt), die Arbeitszeit (FastLED.show ~2 ms,
    // Funk) zählt also mit — sonst wären es 20 ms + Arbeitszeit, d. h. ~44 statt 50 Hz.
    static uint32_t frameStart = 0;
    uint32_t frameTime = millis() - frameStart;
    if (frameTime < 20) {
        delay(20 - frameTime);
    }
    frameStart = millis();
}
