silly82/Herz_Schwarm_CCC_V/(commit log)

2026-04-17 Primzahl-Logik: Gesamtzahl inkl. eigenes Gerät
    - isPrime(totalDevices) mit totalDevices = uniquePeerCount + 1
    - Singularity-Bedingung als uniquePeerCount + 1 >= 17 dokumentiert
    - Cursor-Regel: Arduino CLI für dieses Workspace
    Made-with: Cursor
2026-04-17 README: Primzahl/Singularität (Gesamtzahl), Arduino CLI, BGR wie im Sketch
    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
2026-04-18 Firmware 1.0.0: FW_* im Sketch, README Versionierung, build_debug in .gitignore
    Release-Linie 1.0.0 dokumentiert (Git-Historie ohne Tags). Debug-Builds
    zeigen MAJOR.MINOR.DD+debug; Serial-Banner und Status-Zeile bei ENABLE_SERIAL_DEBUG.
    Arduino-CLI-Regel um FW_*-Hinweis ergänzt.
    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
2026-04-18 docs: v1.0.0-Tag in README und Sketch-Kommentar vermerken
    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
2026-04-18 Basisstation, Remote-Effekte und Dokumentation
    - Badge: ESP-NOW-Modi 2 (Regenbogen) und 3 (Primzahl-Party) per SyncPacket,
    FW_DEBUG_BUILD erhöht; Morse-Virus und lokale Logik unverändert nutzbar.
    - Neu: Sketch Herz_Schwarm_BaseStation mit W5500, Web-UI, /api/peers,
    /api/effect, MQTT über NVS und Web-Formular (Klartext, kein TLS).
    - README um nummerierte Projekt-Doku und mode-Tabelle erweitert; todo.md
    an den Umsetzungsstand angepasst.
    - .gitignore: build_basestation/ ergänzt.
    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
2026-06-15 feat: Wave-Effekt (mode 4) — RSSI-basierter Ripple von Basisstation
    - Badge: SYNC_MODE_WAVE, WAVE_DURATION_MS/WAVE_PULSE_MS Defines
    - Badge: OnDataRecv-Handler berechnet waveDelay aus smoothRSSI
    - Badge: Animationsblock nach Prime, vor Singularity (fade-in/hold/fade-out)
    - Badge: Re-Broadcast mit jitter nach waveDelay für Kettenreaktion
    - Base: handleEffect/sendEffectBroadcast akzeptiert mode 4
    - Base: Web-UI Welle-Button, API-Docs auf m=1|2|3|4 aktualisiert
    - README: Wave in Features (DE/EN), Modus-Doku, REST-API, Abwärtskomp.
    - .gitignore: build_batch/ ergänzt
2026-06-15 feat: Nerves-Controller + Badge Modi 5-8 (Beat/Zone/Ambient/Strobe)
    Badge-Firmware (Herz_Schwarm_CCC_V.ino):
    - Neue Modi: Beat (5, weisser Puls 150ms), Zone (6, RSSI-Farben rot/gelb/blau),
    Ambient (7, RGB aus beatCounter, 30s), Strobe (8, weisse Blitze 2s)
    - OnDataRecv-Handler für alle neuen Modi
    - Animationskette: Virus→Rainbow→Prime→Wave→Beat→Zone→Ambient→Strobe→Singularity→Normal
    ESP32-Bridge-Firmware (herz_schwarm_nerves/firmware/esp32_bridge/):
    - Arduino-Sketch für USB-ESP32 als ESP-NOW-Bridge
    - JSON-Serial-Protokoll (newline-delimited, 115200 Baud)
    - Benötigt ArduinoJson-Library
    Nerves-App (herz_schwarm_nerves/):
    - Elixir/Nerves-Projekt für Raspberry Pi 4
    - He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
2026-07-21 perf: v1.1.0 — Loop- und Speicher-Optimierungen
    - String → char[12] für Morse-Puffer (kein Heap)
    - Peer-Tracking: Hash-Index (MAC[5]) statt O(n²)-Scan
    - isPrime() → LUT[27] für O(1) statt O(√n)
    - Herz-Maske: 64-bit Bitmaske statt 2D-Array-Lookup
    - Wave-Rebroadcast: Zeitstempel statt blockierendem delay()
    - Frame-Limit: dynamisch (20ms Budget) statt festem delay(20)
    - Effekt-State: Array-basiert (8× EffectState) statt 24 Einzelvariablen
    - smoothRSSI: volatile + ISR-Snapshot für Race-Safety
    - esp_now_send: Fehlerbehandlung (esp_err_t) statt void-ignorieren
    - esp_random() statt random() für VirusID
    Build: 959.953 B Flash (73%), 46.308 B RAM — beide Configs OK
2026-07-21 feat(flashlib): arduino-cli compile+upload wrappers
2026-07-21 feat(flash-gui): TUI batch-flasher with ANSI pseudo-GUI
    - Hauptmenü mit 6 Optionen (Ports, Build-Mode, Compile, Flash, Log, Quit)
    - ANSI-Box-Renderer mit NO_COLOR-Fallback
    - Multi-Select Port-Auswahl
    - Live-Output von arduino-cli und esptool
    - Effekt-Steuerung (Modes 1-8) ist NICHT Teil dieses Tools
    — läuft ueber MQTT (Basisstation) oder Web-UI Port 80
    TUI ist nur fuer Flash-Operationen:
    - Port-Discovery (arduino-cli + glob-Fallback)
    - Compile (Release/Debug)
    - Upload + MAC-Read
    - Log anzeigen (gleiche Log-Dateien wie Bash-Skript)
    Dependency: pyserial 3.5+ (bereits installiert)
2026-07-21 fix(flash-gui): auto-build before flash if no .bin present
    Verhindert 'upload_failed' wenn User direkt [4] drueckt ohne
    zuerst [3] zu kompilieren. Jetzt wird automatisch gebaut,
    falls build_batch_gui/*.bin fehlt.
2026-07-21 fix(flashlib): arduino-cli path fallback + correct argv
    Bug 1: arduino-cli ist auf macOS haeufig NICHT im PATH
    (Arduino IDE Bundle-Pfad). build.py und ports.py haben
    jetzt _find_cli() mit Fallback-Liste.
    Bug 2: _compile_argv/_upload_argv hatten 'arduino-cli' als
    argv[0], aber subprocess.run([cli] + argv) prepended den
    CLI-Pfad, sodass 'arduino-cli' als Sub-Command interpretiert
    wurde ('unknown command arduino-cli'). Jetzt startet argv
    mit 'compile'/'upload'.
    Tests angepasst: 22/22 gruen (vorher 20).
2026-07-21 fix(flash): sleep 1.5s -> 3s vor MAC-Read
    Der Bootloader-Reset braucht laenger als 1.5s auf ESP32-S3,
    sodass esptool read_mac den Port noch busy findet und fehlschlaegt.
    Upload ist trotzdem erfolgreich (siehe CSV: 'ok_mac_unread'),
    nur die MAC-Spalte bleibt leer. Mit 3s Sleep jetzt zuverlaessig.
    Beide Tools (TUI + Bash-Skript) angepasst.
2026-07-21 fix(flash): parse MAC from upload output instead of separate read_mac
    esptool write-flash druckt die MAC im 'Connected to ESP32-S3'
    Block (z.B. 'MAC: 3c:0f:02:e4:61:00'). Statt
    nach dem Upload einen separaten 'esptool read_mac' zu starten
    (dazu muss der ESP32-S3-Bootloader-Reset abgewartet werden,
    sonst fail), parsen wir die MAC direkt aus dem Upload-Output.
    Vorteile:
    - Kein 3s Sleep mehr noetig
    - MAC zuverlaessig in CSV/MD-Log
    - Schneller (spart ~3s pro Board)
    - Robuster (kein Race-Condition mit Bootloader-Reset)
    Build + 23/23 Unit-Tests gruen. Hardware-Test: Board 1101
    flash OK mit MAC 3c:0f:02:e4:61:00 in firmware_update_log.csv.
2026-07-21 release: v0.1.1 — Punkt-Release mit Flash-Bug-Fixes
    - .gitignore: build_batch_gui/ hinzugefuegt
    - README: v0.1.0 -> v0.1.1, Changelog-Block, 3-Badge-HW-Test-Tabelle
    - firmware_update_log: 3 neue erfolgreiche Flashes (18:58) angehaengt
    Fixes (von v0.1.0):
    - MAC aus Upload-Output geparst (kein Race mit Bootloader-Reset)
    - arduino-cli Path-Fallback (Arduino-Bundle unter macOS)
    - argv-Bug behoben ('arduino-cli' nicht mehr als Sub-Command)
    - Auto-Build vor Flash (kein manuelles [3] noetig)
2026-07-21 feat(version): A.B.C.D schema + version.sh helper
    Neues Versionsschema (A.B.C.D):
    - A=MAJOR: nur auf speziellen Wunsch
    - B=MINOR: grosses Feature (1.1.0 -> 1.2.0 = TUI)
    - C=PATCH: kleines Feature
    - D=BUILD: nur in Git-Tags, NICHT im Code (sonst Neukompilation
    bei jedem Commit). Tag-Format v1.2.0.5 = 5 Commits seit 1.2.0.
    Aenderungen:
    - FW_VERSION_MINOR 1 -> 2 (TUI als grosses Feature)
    - SyncPacket-Kommentar erklaert: A.B.C + DEBUG_BUILD, kein D
    (17 Byte SyncPacket hat keinen Platz fuer D)
    - flashlib/firmware.py: Doku erweitert, bleibt semantisch gleich
    (gibt nur A.B.C + DEBUG_BUILD aus, nicht D)
    - scripts/version.sh: Helper fuer 'current'/'next-tag'/'since'/'tag'
    - README: Schema-Tabe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
2026-07-21 docs: SKILL.md for AI agents working on this repo
    herz-schwarm.md enthaelt:
    - Quick-Start: version.sh, TUI, Build, Tests
    - A.B.C.D Versionsschema (D nur in Git-Tags)
    - Repo-Layout mit allen relevanten Pfaden
    - Effekt-Steuerung laeuft NICHT im TUI (Web-UI/MQTT)
    - Hardware-Setup (Waveshare ESP32-S3-Matrix, GRB, GPIO 14)
    - Bash→TUI Transition
    - Known Issues (Bootloader-Reset, arduino-cli PATH, argv)
    - Test-Strategie (25/25 Unit-Tests, ad-hoc-verify)
    - Haeufige Befehle
    - Workflow fuer neue Features
    - Cross-Skill-Hinweise
    Fuer Hermes-Agents und andere AI-Tools, die mit diesem
    Repo arbeiten. Version 1.2.0 = aktueller Firmware-Stand.
2026-07-21 feat(nerves): bug-fixes + Mac-Dev-Setup-Doku
    Optimierungen:
    - bridge.ex: exponential Reconnect-Backoff (2s->30s cap), Reset bei Erfolg
    - peer_tracker.ex: pong setzt jetzt auch bridge_connected=true (Logik-Konsistenz)
    - peer_tracker.ex: last_pong wird bei disconnected auf nil gesetzt
    - effect_engine.ex: cancel_beat_timer drained pending :beat_tick Message aus Mailbox
    (Race-Fix: set_bpm(0) konnte von pending beat_tick ueberholt werden)
    - dev.exs: UART-Device Auto-Detect fuer macOS (cu.usbserial-1410, cu.SLAB_USBtoUART)
    + Override via UART_DEVICE env-var
    Doku:
    - herz_schwarm_nerves/MAC_SETUP.md: komplettes Setup fuer Dev auf Mac
    (Elixir via brew/asdf, mix deps.get, mix phx.server, Bridge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
2026-07-21 fix(bridge): fail loud statt silent /dev/ttyUSB0 fallback
    Application.get_env(:herz_schwarm, :uart_device, '/dev/ttyUSB0')
    in bridge.ex:45 hat verursacht, dass auf Mac der Server im
    Reconnect-Loop auf /dev/ttyUSB0 haengt, obwohl dev.exs korrekt
    auf /dev/cu.usbmodem101 aufloest.
    Vermutlich ist das ein Timing-Issue: Application.get_env wird
    zur Bridge-Init-Zeit aufgerufen, BEVOR dev.exs die Config
    gesetzt hat (oder Mix cached eine andere Config-Resolution).
    Fix: Statt silent fallback mit Default, raise loud wenn Config
    fehlt oder falscher Typ. User sieht dann klare Fehlermeldung
    mit Hinweis auf 'UART_DEVICE=/dev/cu.usbmodem101 mix phx.server'.
    Compile clean, v1.2.0.5.
2026-07-21 fix(bridge): Path.wildcard-Auto-Detect als Fallback fuer Timing-Bug
    Application.get_env(:herz_schwarm, :uart_device) lieferte zur
    Bridge-Init-Zeit 'nil', obwohl config.exs + dev.exs den Wert
    korrekt auf /dev/cu.usbmodem101 setzen. Vermutlich Mix-1.18-
    Timing-Issue: Supervisor startet den Bridge-GenServer, bevor
    dev.exs die Application.put_env-Aufrufe abgeschlossen hat.
    Fix: Wenn Application.get_env 'nil' returnt, ruft init/1
    resolve_uart_device/0 als Fallback auf, das:
    1. UART_DEVICE env-var liest (override)
    2. Path.wildcard auf cu.usbserial-*, cu.SLAB_USBtoUART, cu.usbmodem*
    3. Fallback /dev/ttyUSB0 (Linux-Dev) / COM3 (Windows)
    Wenn beides fehlschlaegt, raise loud mit konkreter Anleitung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
2026-07-22 fix(bridge): kein Linux-/dev/ttyUSB0-Fallback auf Mac
    resolve_uart_device/0 ist jetzt plattform-spezifisch:
    - macOS (darwin): Path.wildcard auf cu.usbserial-*, cu.SLAB_USBtoUART,
    cu.usbmodem* — returnt nil wenn keiner gefunden, dann raise laut
    - Linux: Path.wildcard auf ttyUSB*, ttyACM*, Fallback /dev/ttyUSB0
    - Windows: COM3
    Vorher hat resolve_uart_device auf Mac ohne angeschlossenes
    ESP32-Bridge auf /dev/ttyUSB0 zurueckgegriffen (Linux-Pfad), was
    den Bridge-GenServer in einem endlosen Reconnect-Loop haengen
    liess, statt loud zu crashen mit klarer Fehlermeldung.
    Test: auf Mac ohne C6 -> CRASH: :herz_schwarm, :uart_device is
    not configured and no USB-serial... (klar, was zu tun ist).
    Mi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
2026-08-16 feat(bridge): Ack/Retry-Mechanismus für Stationen + echter peer_count
    Bridge trackt Stationen per ESP-NOW-Ack (AckPacket unicast zurück an
    Absender-MAC) und broadcastet SyncPackets bis zu 2x erneut, wenn nicht
    alle zuletzt aktiven Stationen innerhalb von 150ms geantwortet haben.
    Nur der Nerves-Pfad (Modus 3) bekommt das, Modus 2 (Basisstation
    allein) bleibt fire-and-retry-los.
    Behebt nebenbei zwei bestehende Bugs: sendPong() setzte "peers" nie,
    und der Pi pollte nie periodisch "status" — peer_count im Dashboard
    war dadurch dauerhaft 0.
    Version: mix 0.1.0 -> 0.1.1, Bridge-FW 0.1.1 -> 0.1.2.
2026-08-16 docs(version): einheitliches Versionskonzept über alle 5 Module + Inkonsequenzen behoben
    Repo-weite Bestandsaufnahme ergab 5 unabhängige Versions-Namensräume
    (Badge, Basisstation, Bridge, Nerves-App, flashlib), aber Doku behauptete
    fälschlich ein einzelnes "Single-source-of-truth". Statt einer erzwungenen
    globalen Versionsnummer bekommt jedes Modul weiter sein eigenes
    MAJOR.MINOR.PATCH, der vA.B.C.D-Git-Tag wird aber zum Cross-Modul-Snapshot:
    - scripts/version.sh: neuer `all`-Befehl listet alle 5 Modul-Versionen;
    `tag` schreibt sie jetzt in die annotierte Tag-Message statt nur A.B.C
    der Badge-FW zu behaupten
    - README.md: neuer Abschnitt "Versionen aller Module" (zentrale Tabelle)
    -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
2026-10-15 fix(badge,bridge): Peer-Tabelle, implizites Ack, 20-Hz-Senderate
    Badge 1.2.0 -> 1.2.1:
    - Peer-Hash entfernt: beim Wiederbelegen eines abgelaufenen Slots konnte
    peerHashInsert eine Selbstschleife bauen (gleiches MAC-Byte) -> Endlos-
    schleife im WiFi-Callback. Jetzt lineare Suche (MAX_PEERS=25).
    - Sync-Broadcast 20 Hz statt 50 Hz (SYNC_TX_INTERVAL_MS), bei mode/virusID-
    Wechsel sofort. 60 % weniger Kanal-Last, Animation bleibt 50 Hz.
    - txData-Befüllung in sendSync() zusammengefasst.
    Bridge 0.1.2 -> 0.1.3:
    - Ack/Retry war wirkungslos: Bridge wartete nur auf AckPacket, Badges
    senden keins -> peers immer 0, Retries nie. Jetzt zählt ein Badge-
    SyncPacket mit der virusID des laufenden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
2026-10-15 feat(base): Effekte 1-8, mDNS, MQTT-Puffer, no_fs-Partition (0.2.0)
    - Web-UI/API: alle Modi 1-8 (Beat, Zonen, Ambient mit Farbwähler,
    Strobe mit Photosensitivitäts-Hinweis). /api/effect?m=1..8[&c=RRGGBB],
    ungültiges m -> 400 statt still Virus.
    - MQTT-Befehl: leer -> Virus (wie bisher), "N" -> Modus N, "7:RRGGBB".
    - MQTT-Puffer 768 -> ~2 KB: Status-JSON ging ab ~18 Badges stillschweigend
    verloren. publish()-Fehler wird geloggt.
    - /api/peers liefert MQTT-Status mit, UI pollt nur noch einen Endpoint.
    - mDNS: http://herz-base.local. MDNS.begin() verstellt den WiFi-Stack,
    daher applyEspNowRadio() danach erneut - sonst kein ESP-NOW-Empfang.
    - sketch.yaml: PartitionScheme=no_fs (2x 2 MB,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
2026-10-15 fix: synchroner Schwarm-Puls + WiFi-Protokoll (Badge 1.2.2)
    Schwarm-Sync (Badge 1.2.1 -> 1.2.2):
    - Der Puls lief über beatsin8(), das mit dem lokalen millis() rechnet;
    heartBeatState ging nur als 8-Bit-Phasenversatz ein. Badges pulsierten
    daher im Takt ihrer eigenen Boot-Zeit, nie wirklich synchron.
    - heartBeatState ist jetzt die gemeinsame Schwarm-Phase (1 Puls = 65536),
    swarmPulse() rechnet die Helligkeit nur daraus. Max-Regel: Vorsprung
    eines Peers wird weich aufgeholt (1/4 pro Frame), ab 4 Pulsen direkt
    übernommen. Tempo wie bisher: Modus-BPM + RSSI-Anteil.
    - Ambient-Rebroadcast sendete heartBeatState statt der Farbe im
    beatCounter -> Badges, die den Effekt nur weitergeleit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
2026-10-15 fix: Core-übergreifende Races (Badge, Basisstation), ArduinoJson 7 (Bridge)
    Badge 1.2.2 -> 1.2.3:
    - OnDataRecv (WiFi-Task, Core 0) und loop() (Core 1) teilten seenPeers,
    fx[], smoothRSSI, wave*/ambient* ohne Sperre; noInterrupts() schützt
    nicht gegen den anderen Core. Jetzt ein stateMux: Callback aktualisiert
    darunter, loop() kopiert einmal pro Frame (fs[], frameBeat, amb*) und
    rendert ohne Sperre.
    - now wird unter der Sperre neu gelesen: hat der Callback seit Loop-Start
    lastSeen/startTime gesetzt, lief now - x über -> aktiver Peer gelöscht
    bzw. frisch gestarteter Effekt sofort beendet.
    - Effekt-Ablauf per fxDurationMs[] beim Snapshot statt Pauschal-Reset im
    Normal-Zweig (d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
2026-10-15 chore: esp32-Core 3.3.12 + Libraries aktualisiert, 3 Badges neu geflasht
    Core 3.3.11 -> 3.3.12, FastLED 3.10.3 -> 3.10.7 (u. a.). Alle Sketches
    bauen ohne eigene Warnungen (Badge, Basisstation, Bridge S3/C3).
    Badge-Binary +37 KB durch FastLED 3.10.7 (871 -> 908 KB, 69 %).
    3 Badges mit dem neuen Build geflasht; Basisstation und Bridge sehen sie.
    Claude-Session: https://claude.ai/code/session_01DdDYS997F4ZzkaDEKW9HsX
2026-10-15 feat: Badge 1.3.0 / Basisstation 0.3.0 / Bridge 0.1.6 – "Badge finden", OTA, mehr Sendeleistung
    - Badge 1.3.0: Modus 9 (Identify) – nur das Badge mit der Ziel-MAC blinkt
    10 s grün bei voller Helligkeit; Stations-Pakete (ver_major 0) beeinflussen
    den Schwarm-Takt nicht mehr.
    - Basisstation 0.3.0: POST /api/identify?mac=…, „🔎 Finden“-Button je Peer;
    OTA-Upload über Web-UI / POST /api/ota (Basic Auth, Passwort aus
    gitignorter ota_secret.h, Warnung bei Standard-Passwort).
    - Basisstation + Bridge: TX-Leistung 21 dBm (Bridge an Station −85 statt −92 dBm).
    - todo.md aufgeräumt, README aktualisiert; Badge a0:f2:62:ec:3b:b4 auf 1.3.0.
    Getestet: Identify (grünes Blinken b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
2026-10-15 chore(flash): letzte 2 Badges auf 1.3.0 – alle 12 Badges auf 1.3.0
    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
2026-10-15 fix(nerves): Config wird geladen, Bandit statt Cowboy, Bridge-Port per Probe (App 0.1.2)
    - mix.exs: loadconfig-Alias rief den Task nie auf → config/*.exs wurde nicht
    geladen (Endpoint ohne Port, Phoenix fiel auf Cowboy zurück = Translator-Crash,
    :uart_device nil). Jetzt Mix.Task.run("loadconfig"), cli/0 statt
    preferred_cli_target, Aliase zusammengeführt.
    - Bandit als Dep, Cowboy-Altlasten aus mix.lock; HTTP/2 aus
    (EEF-CVE-2026-105659, in Bandit 1.12.5 ungefixt).
    - Bridge: Port wird bei jedem (Re-)Connect ermittelt – UART_DEVICE >
    config :uart_device > Auto-Detect (Espressif/CP210x/CH340/FTDI-Ports, erster
    mit "pong" auf status). Feste ttyUSB0-Defaults entfernt; ohne Bridge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
2026-10-15 feat(nerves): "Badge finden" über Bridge 0.2.0 + Nerves-UI repariert (Phoenix 1.8 / LiveView 1.2)
    Bridge-Firmware 0.2.0:
    - {"cmd":"peers"} → je aktiver Station {"evt":"peer",mac,rssi,fw,age}, danach
    {"evt":"peers","n":N}; RSSI und Version werden pro Station mitgeführt.
    - {"cmd":"identify","mac":…} → Modus 9 (SyncPacket + 6 Byte Ziel-MAC, 3×),
    bewusst ohne Ack/Retry-Maschine (nur ein Badge antwortet).
    Nerves-App:
    - Bridge pollt status + peers; PeerTracker übernimmt die Liste erst beim
    Listenende, PeerTracker.identify/1 validiert die MAC.
    - Dashboard: Badge-Tabelle mit „🔎 Finden“ (ab Badge-FW 1.3.0).
    - UI rendert wieder: Templates nutzen {…}-Interpolation, die LiveVie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
2026-10-15 feat(badge): Welle läuft von Basis/Bridge nach außen (Badge 1.4.0)
    - Wellen-Verzögerung aus dem RSSI des Wellen-Pakets statt smoothRSSI
    - Station/Bridge = Ursprung (0–2000 ms nach Signalstärke), Badges
    relayen mit Hop-Verzögerung (sender + 150 + 0–600 ms, max. 3300 ms)
    - Wellen-Pakete tragen Zeit seit Wellenstart + eigene Verzögerung
    (gemeinsamer Wellenstart, kürzeste Verzögerung gewinnt)
    - Wirkungsloser Rebroadcast-Mechanismus entfernt
    - Erster Badge (a0:f2:62:ec:3b:b0) auf 1.4.0 geflasht; Feldtest mit
    vielen Badges steht noch aus (todo.md)
    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
2026-10-16 chore(flash): letzte 4 Badges auf 1.4.0 – alle 12 Badges auf 1.4.0
2026-10-17 feat(hardware): battery badge KiCad project with reverse-engineered reference
    Adds herz_badge/, a KiCad project (laid out with pcb-kit) for a battery-powered
    Herz-Schwarm badge that runs the existing firmware unchanged.
    - boards/reference: the Waveshare ESP32-S3-Matrix redrawn from the netlist in
    its schematic PDF (scripts/vendor_netlist.py), checked pin for pin against it
    (scripts/check_reference.py: 0 differences).
    - boards/badge: schematic (ERC clean) and placed, unrouted 30 x 34 mm 4-layer
    board: ESP32-S3FH4R2, 64 WS2812B-2020-V6, QMI8658A, TP4056 charger, load
    sharing, off switch, JST PH cell with reverse guard, USB ESD, Walsin
    RFANT3216120A5T corner antenna. JLC quote files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
2026-10-20 feat: Welle endlos mit Stopp, UART-OTA für Bridge, Bridge-Update-UI
    - Badge-FW 1.4.1: Welle läuft endlos (Zyklus 4 s), Stopp über Modus 10 (SYNC_MODE_WAVE_STOP) mit begrenzter Weiterleitung
    - Basisstation 0.3.1: Welle-Toggle im Web-UI, m=10 / MQTT "10", Zustand aus Funkpaketen gelernt
    - Bridge 0.3.0: Modus 10 durchgeleitet, UART-OTA (ota_begin/chunk/end/abort), pong mit fw/ota, min_spiffs-Schema
    - Nerves-App 0.2.0: Welle-Toggle im Dashboard, /bridge-update (Upload, Fortschritt), BridgeUpdater, Tests; Doku aktualisiert
2026-10-20 feat(firmware): Tap-Counter, endlose Effekte mit "Alle stoppen", LED-Farbordnung korrigiert
2026-10-20 feat(app): Monitoring/Diagnose, Tap-Counter, Bridge-UART-OTA, endlose Effekte
2026-11-12 feat: Badge 1.6.0 – Nähe nur als Helligkeit, Stopp mit Kennung, Timing-Fixes
    Badge (1.5.0 -> 1.6.0):
    - Frame-Raster wirklich 50 Hz (Arbeitszeit zählt mit), Sync auf festem 50-ms-Raster
    - Basisstation/Bridge (FW-Major 0) zählen nicht mehr als Peer
    - Regenbogen-Farbton aus dem Schwarm-Takt, damit zwischen Badges synchron
    - Nähe = nächstes Badge (stärkstes Signal) statt Mittel über alle; steuert nur
    noch die Helligkeit, das Tempo ist je Modus fest
    - Ferngesteuerte Effekte mit fester Helligkeit (FX_BRIGHT)
    - Morse-Virus (ID 1..99999) endet nach 3 s
    - "Alle stoppen" trägt eine Kennung und wirkt je Badge genau einmal
    Basisstation / Bridge (0.4.0 -> 0.4.2):
    - führen sich gegenseitig n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
2026-11-12 ci: Firmwares kompilieren, pytest und mix test bei jedem Push
    Drei Jobs: Badge (Release + Debug), Basisstation und Bridge mit arduino-cli
    kompilieren (ESP32-Core und Libraries festgenagelt), pytest für
    scripts/flashlib, mix test für herz_schwarm_nerves auf dem Host-Target.
    Badge- und Bridge-Binärdateien werden als Artefakt abgelegt.
    Claude-Session: https://claude.ai/code/session_01DURg6CovAmfV5nekjjrEiv
2026-11-12 feat: Funk-Update der Badges über WLAN (Badge 1.7.0, Bridge 0.5.0, App 0.3.0)
    Badge: neuer Modus 13. Ein signierter Auslöser (HMAC-SHA256 mit OTA_KEY) nennt
    Zielversion, Server, Größe und MD5. Badges mit älterer Version leiten ihn
    begrenzt weiter, melden sich am WLAN aus ota_secret.h an, laden
    /firmware/badge.bin, prüfen Größe und MD5 und starten neu. Ohne ota_secret.h
    wird der OTA-Code nicht mitkompiliert. Versions-Marker "HERZFW:x.y.z;" im Binary.
    Bridge: Kommando "badge_ota" reicht das fertig signierte Paket durch.
    App: HerzSchwarm.BadgeOta (Ablage, Paketbau, Auslöser), Seite /badge-update,
    GET /firmware/badge.bin. Schlüssel über BADGE_OTA_KEY.
    CI: zusätzlicher Badge-Build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
2026-11-12 feat(badge): Bewegungssensor – Schütteln lässt das Herz flattern (1.8.0)
    Liest den QMI8658 der Waveshare-Matrix (I²C, GPIO 11/12, 25 Hz, nur
    Beschleunigung). Schütteln löst 1,5 s Herzflattern aus (lokal, nur ohne
    ferngesteuerten Effekt). Optional und standardmäßig aus: Herz immer aufrecht
    (IMU_AUTO_ROTATE, braucht einmaliges Einmessen von Offset/Spiegelung) und
    Abdunkeln in Ruhe (IMU_REST_DIM_MS). Ohne passenden Sensor oder bei
    unplausiblen Werten bleibt alles aus. Abschaltbar mit -DENABLE_IMU=0.
    Kompiliert in allen Varianten, am Gerät noch nicht getestet.
    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
2026-11-12 feat(tooling): Flash-TUI 0.2.0 (Windows, paralleles Flashen) + Doku überarbeitet
    Flash-Tooling 0.2.0:
    - Windows: COM-Ports über arduino-cli/pyserial, VT-Farben, UTF-8-Ausgabe
    - Versions-Parser liest #define-Zeilen mit Kommentar (Debug-Version war 00)
    - veralteter Build (Moduswechsel, geänderter Sketch) wird erkannt und neu gebaut
    - Upload-Ausgabe live, Abbruch nach 3 min, gleichzeitiges Flashen, Retry
    - Statuszeile, korrekte Rahmenbreite, Log in UTF-8 mit Zeitzone
    - 41 Tests
    Doku: README, MAC_SETUP.md, todo.md, Hermes-Skill und DESIGN.md auf Stand
    Badge 1.8.0 / Basisstation 0.4.2 / Bridge 0.5.0 / App 0.3.0; build_ota/ in
    .gitignore (enthält WLAN-Passwort und OTA-Schlüssel).
    Co-Authore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
2026-11-12 feat(tooling): Flash-TUI 0.2.1 mit Badge-Herz im Kopf
    - Kopf der TUI zeigt das 8x8-Herz als Blockgrafik (ab 72 Spalten)
    - term.half_blocks / term.beside, zwei neue Tests (43 gesamt)
    - Doku: Version 0.2.1; verstümmelten Pfad `scripts\flash_gui.py`
    in README und MAC_SETUP korrigiert (Seitenvorschub statt `\f`)
    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
2026-11-12 chore: CI entfernt, Prüfung von Hand dokumentiert
    - .github/workflows/ci.yml gelöscht (Projekt bewusst ohne CI)
    - README: Abschnitt „Prüfen vor dem Push" statt „Automatische Prüfung (CI)"
    - MAC_SETUP, todo, Hermes-Skill: Hinweise auf die CI angepasst
    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
